eSpark-Backup/yazid-boud-khlouf-oled-keyboard/Deliverables/Renderings/3D_Top_View.PNG

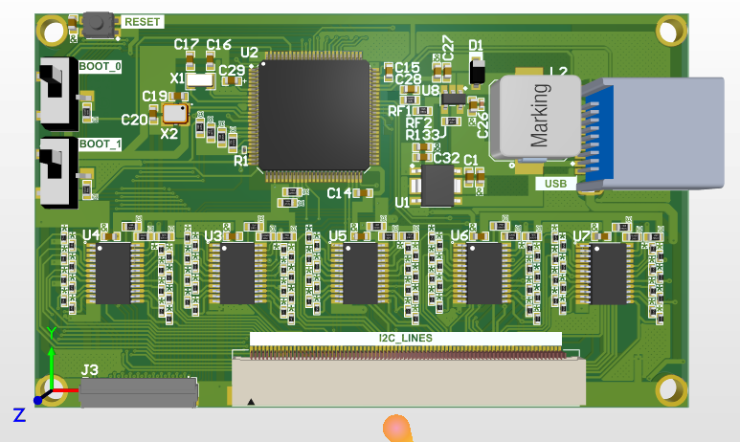
Deliverables/Renderings/3D_Top_View.PNG
