eSpark-Backup/yazid-boud-khlouf-oled-keyboard/Deliverables/Renderings/3D_Bottom_View.PNG

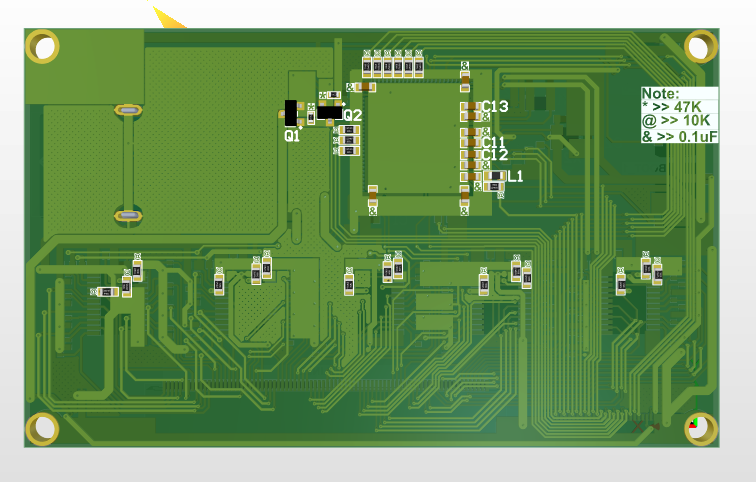
Deliverables/Renderings/3D_Bottom_View.PNG
