eSpark-Backup/yazid-boud-khlouf-oled-keyboard/README.md

# YazidBoukhlouf-OLEDKeyboard
To develop a custom keyboard for client that has OLEDs for Alphanumeric keys and can change characters on runtime. The OLEDs used must be transparent.
