eSpark-Backup/yazid-boud-khlouf-oled-keyboard/Deliverables/Renderings/2D_Bottom_View.PNG

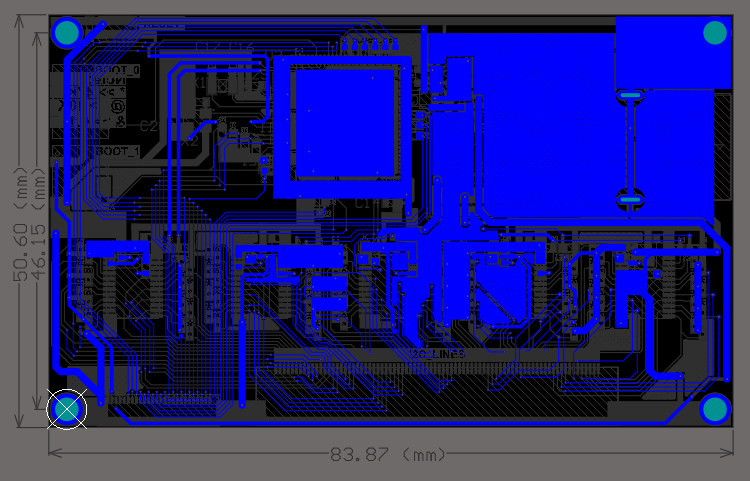
Deliverables/Renderings/2D_Bottom_View.PNG
