eSpark-Backup/yazid-boud-khlouf-oled-keyboard/Deliverables/Renderings/2D_C_View.PNG

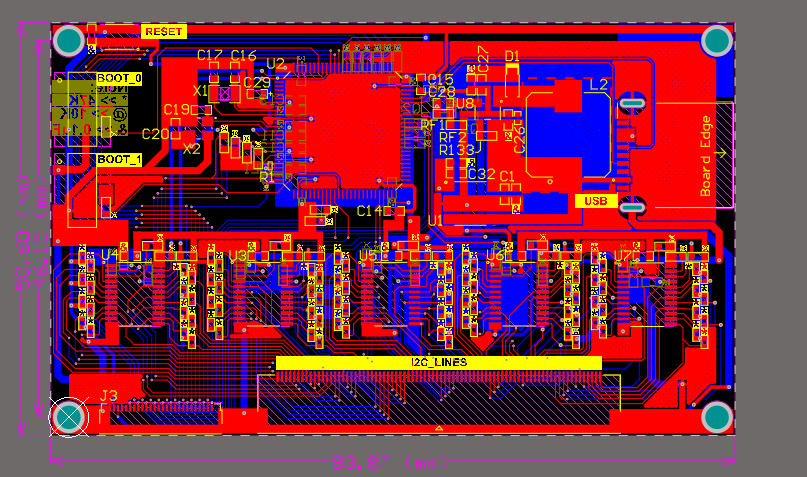
Deliverables/Renderings/2D_C_View.PNG
