eSpark-Backup/yazid-boud-khlouf-oled-keyboard/Deliverables/Renderings/2D_Top_View.PNG

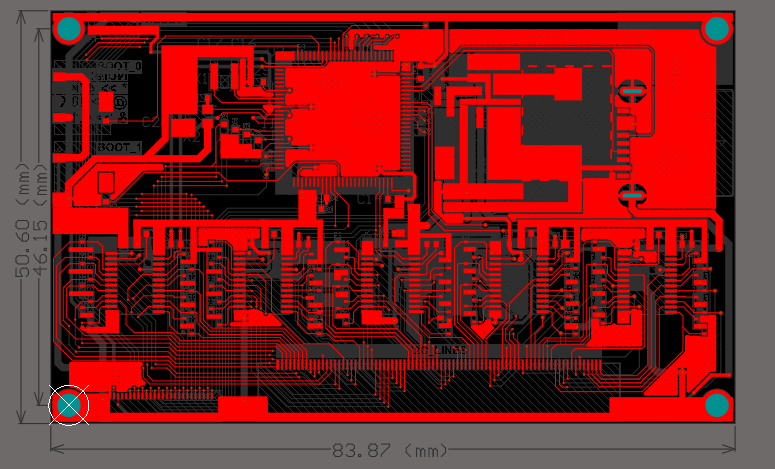
Deliverables/Renderings/2D_Top_View.PNG
