eSpark-Backup/yazid-boud-khlouf-oled-keyboard/Deliverables/Renderings/Isometric_View.PNG

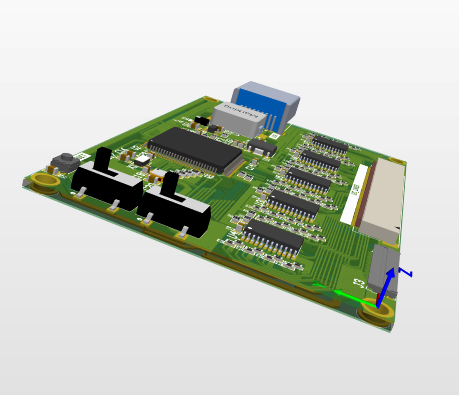
Deliverables/Renderings/Isometric_View.PNG
