eSpark-Backup/yazid-boud-khlouf-oled-keyboard/Design-Files/Control Board/Keyboard layout/layout_rough_sketch.jpg

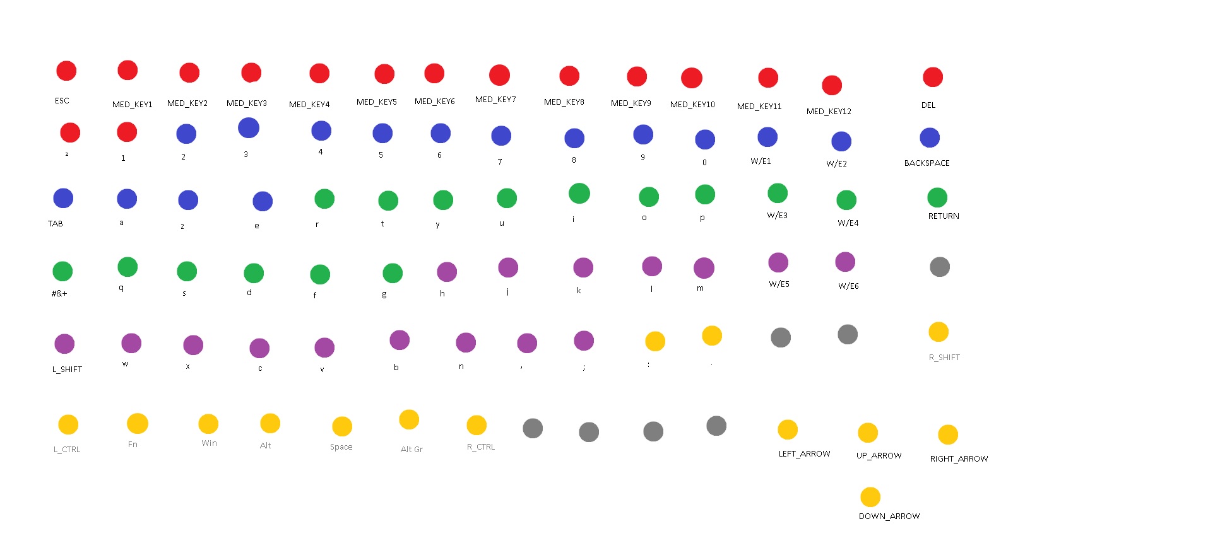
Design-Files/Control Board/Keyboard layout/layout_rough_sketch.jpg
