eSpark-Backup/yazid-boud-khlouf-oled-keyboard/Documents/Dev-Files/IMG_3417.jpg

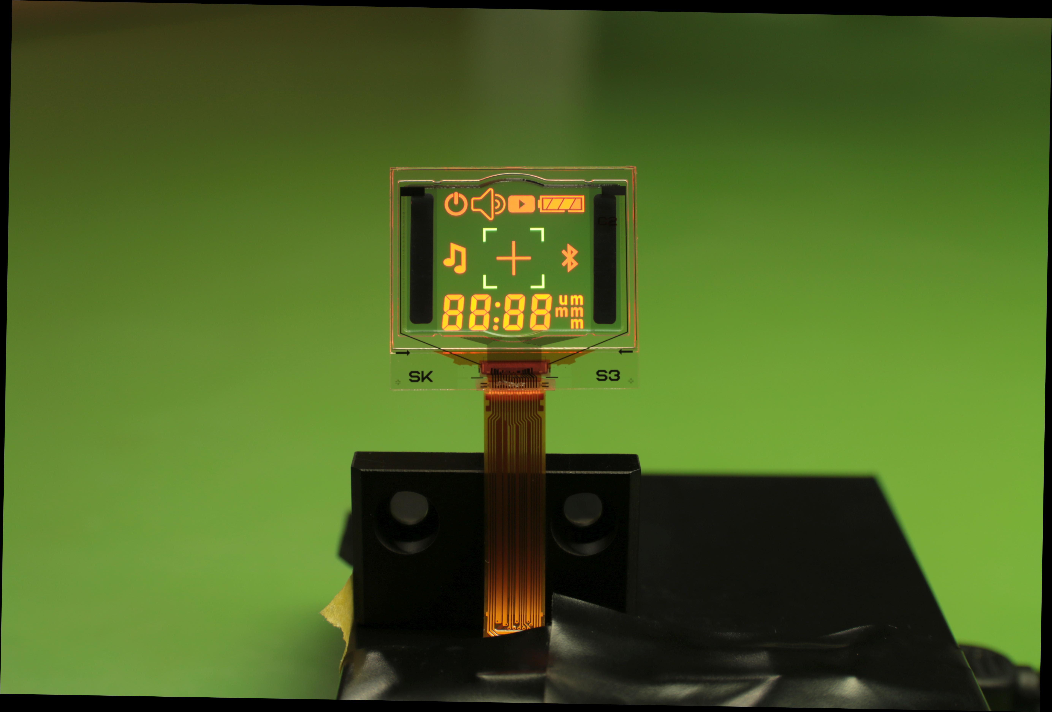
Documents/Dev-Files/IMG_3417.jpg
