eSpark-Backup/yazid-boud-khlouf-oled-keyboard/Documents/Client-Files/Combinaisons de touches.xlsx

Sheet: Short time press
 |  |  | Key is pressed for short time
 |  |  | While key is maintained - but until another key is pressed
 |  |  | While key is maintained
 |  |  | Key is pressed for long time
 |  |  | Key is "activated"
 | By default
 |  |  |  |  |  |  |  |  |  |  |  |  |  |  | Options
 | A | B | C | D | R | F | G | H | I | J | K | L | M | N
1 | Escap |  |  |  |  |  |  |  |  |  |  |  |  | Del | Word |  |  | Excel
2 | ² | 1 | 2 | 3 | 4 | 5 | 6 | 7 | 8 | 9 | 0 |  |  | Back space | Xa | Xa |  | % | =
3 | Tab | a | z | e | r | t | y | u | i | o | p |  |  | Return | B | I |  | + | -
4 | #&+ | q | s | d | f | g | h | j | k | l | m |  |  |  | U | ~~S~~ |  | * | /
5 | Shift |  | w | x | c | v | b | n | , | ; | : | . | Shift
6 | Ctrl | Fn | Win | Alt | Space |  |  |  |  | Alt Gr | Ctrl | ← | ↑ | →
7 |  |  |  |  |  |  |  |  |  |  |  |  | ↓
 | A | B | C | D | R | F | G | H | I | J | K | L | M | N
1 | Escap |  |  |  |  |  |  |  |  |  |  |  |  | Del |  |  |  | Escape
2 | ² | 1 | 2 | 3 | 4 | 5 | 6 | 7 | 8 | 9 | 0 |  |  | Back space
3 | Tab | a | z | e | r | t | y | u | i | o | p |  |  | Return | return
4 | #&+ | q | s | d | f | g | h | j | k | l | m |  |  |  | →
5 | Shift |  | w | x | c | v | b | n | , | ; | : | . | Shift
6 | Ctrl | Fn | Win | Alt | Space |  |  |  |  | Alt Gr | Ctrl | ← | ↑ | →
7 |  |  |  |  |  |  |  |  |  |  |  |  | ↓
 | A | B | C | D | R | F | G | H | I | J | K | L | M | N
1 | Escap |  |  |  |  |  |  |  |  |  |  |  |  | Del |  |  |  | Cancel (Ctrl+z)
2 | ² | 1 | 2 | 3 | 4 | 5 | 6 | 7 | 8 | 9 | 0 |  |  | Back space
3 | Tab | a | z | e | r | t | y | u | i | o | p |  |  | Return | return
4 | #&+ | q | s | d | f | g | h | j | k | l | m |  |  |  | →
5 | Shift |  | w | x | c | v | b | n | , | ; | : | . | Shift
6 | Ctrl | Fn | Win | Alt | Space |  |  |  |  | Alt Gr | Ctrl | ← | ↑ | →
7 |  |  |  |  |  |  |  |  |  |  |  |  | ↓
 | A | B | C | D | R | F | G | H | I | J | K | L | M | N
1 | Escap |  |  |  |  |  |  |  |  |  |  |  |  | Del |  |  |  | decrease screen brightness
2 | ² | 1 | 2 | 3 | 4 | 5 | 6 | 7 | 8 | 9 | 0 |  |  | Back space
3 | Tab | a | z | e | r | t | y | u | i | o | p |  |  | Return | return
4 | #&+ | q | s | d | f | g | h | j | k | l | m |  |  |  | →
5 | Shift |  | w | x | c | v | b | n | , | ; | : | . | Shift
6 | Ctrl | Fn | Win | Alt | Space |  |  |  |  | Alt Gr | Ctrl | ← | ↑ | →
7 |  |  |  |  |  |  |  |  |  |  |  |  | ↓
 | A | B | C | D | R | F | G | H | I | J | K | L | M | N
1 | Escap |  |  |  |  |  |  |  |  |  |  |  |  | Del |  |  |  | increase screen brightness
2 | ² | 1 | 2 | 3 | 4 | 5 | 6 | 7 | 8 | 9 | 0 |  |  | Back space
3 | Tab | a | z | e | r | t | y | u | i | o | p |  |  | Return | return
4 | #&+ | q | s | d | f | g | h | j | k | l | m |  |  |  | →
5 | Shift |  | w | x | c | v | b | n | , | ; | : | . | Shift
6 | Ctrl | Fn | Win | Alt | Space |  |  |  |  | Alt Gr | Ctrl | ← | ↑ | →
7 |  |  |  |  |  |  |  |  |  |  |  |  | ↓
 | A | B | C | D | R | F | G | H | I | J | K | L | M | N
1 | Escap |  |  |  |  |  |  |  |  |  |  |  |  | Del |  |  |  | decrease volume
2 | ² | 1 | 2 | 3 | 4 | 5 | 6 | 7 | 8 | 9 | 0 |  |  | Back space
3 | Tab | a | z | e | r | t | y | u | i | o | p |  |  | Return | return
4 | #&+ | q | s | d | f | g | h | j | k | l | m |  |  |  | →
5 | Shift |  | w | x | c | v | b | n | , | ; | : | . | Shift
6 | Ctrl | Fn | Win | Alt | Space |  |  |  |  | Alt Gr | Ctrl | ← | ↑ | →
7 |  |  |  |  |  |  |  |  |  |  |  |  | ↓
 | A | B | C | D | R | F | G | H | I | J | K | L | M | N
1 | Escap |  |  |  |  |  |  |  |  |  |  |  |  | Del |  |  |  | increase volume
2 | ² | 1 | 2 | 3 | 4 | 5 | 6 | 7 | 8 | 9 | 0 |  |  | Back space
3 | Tab | a | z | e | r | t | y | u | i | o | p |  |  | Return | return
4 | #&+ | q | s | d | f | g | h | j | k | l | m |  |  |  | →
5 | Shift |  | w | x | c | v | b | n | , | ; | : | . | Shift
6 | Ctrl | Fn | Win | Alt | Space |  |  |  |  | Alt Gr | Ctrl | ← | ↑ | →
7 |  |  |  |  |  |  |  |  |  |  |  |  | ↓
 | A | B | C | D | R | F | G | H | I | J | K | L | M | N |  |  |  | A | B | C | D | R | F | G | H | I | J | K | L | M | N
1 | Escap |  |  |  |  |  |  |  |  |  |  |  |  | Del |  |  | 1 | Escap |  |  |  |  |  |  |  |  |  |  |  |  | Del |  | Microphone on/off
2 | ² | 1 | 2 | 3 | 4 | 5 | 6 | 7 | 8 | 9 | 0 |  |  | Back space |  |  | 2 | ² | 1 | 2 | 3 | 4 | 5 | 6 | 7 | 8 | 9 | 0 |  |  | Back space
3 | Tab | a | z | e | r | t | y | u | i | o | p |  |  | Return | return |  | 3 | Tab | a | z | e | r | t | y | u | i | o | p |  |  | Return
4 | #&+ | q | s | d | f | g | h | j | k | l | m |  |  |  | → |  | 4 | #&+ | q | s | d | f | g | h | j | k | l | m
5 | Shift |  | w | x | c | v | b | n | , | ; | : | . | Shift |  |  |  | 5 | Shift |  | w | x | c | v | b | n | , | ; | : | . | Shift
6 | Ctrl | Fn | Win | Alt | Space |  |  |  |  | Alt Gr | Ctrl | ← | ↑ | → |  |  | 6 | Ctrl | Fn | Win | Alt | Space |  |  |  |  | Alt Gr | Ctrl | ← | ↑ | →
7 |  |  |  |  |  |  |  |  |  |  |  |  | ↓ |  |  |  | 7 |  |  |  |  |  |  |  |  |  |  |  |  | ↓
 | A | B | C | D | R | F | G | H | I | J | K | L | M | N |  |  |  | A | B | C | D | R | F | G | H | I | J | K | L | M | N
1 | Escap |  |  |  |  |  |  |  |  |  |  |  |  | Del |  |  | 1 | Escap |  |  |  |  |  |  |  |  |  |  |  |  | Del |  | Camera on/off
2 | ² | 1 | 2 | 3 | 4 | 5 | 6 | 7 | 8 | 9 | 0 |  |  | Back space |  |  | 2 | ² | 1 | 2 | 3 | 4 | 5 | 6 | 7 | 8 | 9 | 0 |  |  | Back space
3 | Tab | a | z | e | r | t | y | u | i | o | p |  |  | Return | return |  | 3 | Tab | a | z | e | r | t | y | u | i | o | p |  |  | Return
4 | #&+ | q | s | d | f | g | h | j | k | l | m |  |  |  | → |  | 4 | #&+ | q | s | d | f | g | h | j | k | l | m
5 | Shift |  | w | x | c | v | b | n | , | ; | : | . | Shift |  | ← |  | 5 | Shift |  | w | x | c | v | b | n | , | ; | : | . | Shift
6 | Ctrl | Fn | Win | Alt | Space |  |  |  |  | Alt Gr | Ctrl | ← | ↑ | → |  |  | 6 | Ctrl | Fn | Win | Alt | Space |  |  |  |  | Alt Gr | Ctrl | ← | ↑ | →
7 |  |  |  |  |  |  |  |  |  |  |  |  | ↓ |  |  |  | 7 |  |  |  |  |  |  |  |  |  |  |  |  | ↓
 | A | B | C | D | R | F | G | H | I | J | K | L | M | N |  |  |  | A | B | C | D | R | F | G | H | I | J | K | L | M | N
1 | Escap |  |  |  |  |  |  |  |  |  |  |  |  | Del |  |  | 1 | Escap |  |  |  |  |  |  |  |  |  |  |  |  | Del |  | Screen record
2 | ² | 1 | 2 | 3 | 4 | 5 | 6 | 7 | 8 | 9 | 0 |  |  | Back space |  |  | 2 | ² | 1 | 2 | 3 | 4 | 5 | 6 | 7 | 8 | 9 | 0 |  |  | Back space
3 | Tab | a | z | e | r | t | y | u | i | o | p |  |  | Return | return |  | 3 | Tab | a | z | e | r | t | y | u | i | o | p |  |  | Return
4 | #&+ | q | s | d | f | g | h | j | k | l | m |  |  |  | → |  | 4 | #&+ | q | s | d | f | g | h | j | k | l | m
5 | Shift |  | w | x | c | v | b | n | , | ; | : | . | Shift |  | ← |  | 5 | Shift |  | w | x | c | v | b | n | , | ; | : | . | Shift
6 | Ctrl | Fn | Win | Alt | Space |  |  |  |  | Alt Gr | Ctrl | ← | ↑ | → |  |  | 6 | Ctrl | Fn | Win | Alt | Space |  |  |  |  | Alt Gr | Ctrl | ← | ↑ | →
7 |  |  |  |  |  |  |  |  |  |  |  |  | ↓ |  |  |  | 7 |  |  |  |  |  |  |  |  |  |  |  |  | ↓
 | A | B | C | D | R | F | G | H | I | J | K | L | M | N
1 | Escap |  |  |  |  |  |  |  |  |  |  |  |  | Del |  |  |  | Screenshot
2 | ² | 1 | 2 | 3 | 4 | 5 | 6 | 7 | 8 | 9 | 0 |  |  | Back space
3 | Tab | a | z | e | r | t | y | u | i | o | p |  |  | Return | return
4 | #&+ | q | s | d | f | g | h | j | k | l | m |  |  |  | →
5 | Shift |  | w | x | c | v | b | n | , | ; | : | . | Shift |  | ←
6 | Ctrl | Fn | Win | Alt | Space |  |  |  |  | Alt Gr | Ctrl | ← | ↑ | →
7 |  |  |  |  |  |  |  |  |  |  |  |  | ↓
 | A | B | C | D | R | F | G | H | I | J | K | L | M | N
1 | Escap |  |  |  |  |  |  |  |  |  |  |  |  | Del |  |  |  | Print
2 | ² | 1 | 2 | 3 | 4 | 5 | 6 | 7 | 8 | 9 | 0 |  |  | Back space
3 | Tab | a | z | e | r | t | y | u | i | o | p |  |  | Return | return
4 | #&+ | q | s | d | f | g | h | j | k | l | m |  |  |  | →
5 | Shift |  | w | x | c | v | b | n | , | ; | : | . | Shift
6 | Ctrl | Fn | Win | Alt | Space |  |  |  |  | Alt Gr | Ctrl | ← | ↑ | →
7 |  |  |  |  |  |  |  |  |  |  |  |  | ↓
 | A | B | C | D | R | F | G | H | I | J | K | L | M | N
1 | Escap |  |  |  |  |  |  |  |  |  |  |  |  | Del |  |  |  | Share
2 | ² | 1 | 2 | 3 | 4 | 5 | 6 | 7 | 8 | 9 | 0 |  |  | Back space
3 | Tab | a | z | e | r | t | y | u | i | o | p |  |  | Return | return
4 | #&+ | q | s | d | f | g | h | j | k | l | m |  |  |  | →
5 | Shift |  | w | x | c | v | b | n | , | ; | : | . | Shift
6 | Ctrl | Fn | Win | Alt | Space |  |  |  |  | Alt Gr | Ctrl | ← | ↑ | →
7 |  |  |  |  |  |  |  |  |  |  |  |  | ↓
 | A | B | C | D | R | F | G | H | I | J | K | L | M | N |  |  |  | A | B | C | D | R | F | G | H | I | J | K | L | M | N
1 | Escap |  |  |  |  |  |  |  |  |  |  |  |  | Del |  |  | 1 | Escap |  |  |  |  |  |  |  |  |  |  |  |  | Del |  | Activate / Disable WiFi
2 | ² | 1 | 2 | 3 | 4 | 5 | 6 | 7 | 8 | 9 | 0 |  |  | Back space |  |  | 2 | ² | 1 | 2 | 3 | 4 | 5 | 6 | 7 | 8 | 9 | 0 |  |  | Back space
3 | Tab | a | z | e | r | t | y | u | i | o | p |  |  | Return | return |  | 3 | Tab | a | z | e | r | t | y | u | i | o | p |  |  | Return | return
4 | #&+ | q | s | d | f | g | h | j | k | l | m |  |  |  | → |  | 4 | #&+ | q | s | d | f | g | h | j | k | l | m |  |  |  | →
5 | Shift |  | w | x | c | v | b | n | , | ; | : | . | Shift |  | ← |  | 5 | Shift |  | w | x | c | v | b | n | , | ; | : | . | Shift
6 | Ctrl | Fn | Win | Alt | Space |  |  |  |  | Alt Gr | Ctrl | ← | ↑ | → |  |  | 6 | Ctrl | Fn | Win | Alt | Space |  |  |  |  | Alt Gr | Ctrl | ← | ↑ | →
7 |  |  |  |  |  |  |  |  |  |  |  |  | ↓ |  |  |  | 7 |  |  |  |  |  |  |  |  |  |  |  |  | ↓
 | A | B | C | D | R | F | G | H | I | J | K | L | M | N
1 | Escap |  |  |  |  |  |  |  |  |  |  |  |  | Del |  |  |  | Delete
2 | ² | 1 | 2 | 3 | 4 | 5 | 6 | 7 | 8 | 9 | 0 |  |  | Back space
3 | Tab | a | z | e | r | t | y | u | i | o | p |  |  | Return | return
4 | #&+ | q | s | d | f | g | h | j | k | l | m |  |  |  | →
5 | Shift |  | w | x | c | v | b | n | , | ; | : | . | Shift
6 | Ctrl | Fn | Win | Alt | Space |  |  |  |  | Alt Gr | Ctrl | ← | ↑ | →
7 |  |  |  |  |  |  |  |  |  |  |  |  | ↓
 | A | B | C | D | R | F | G | H | I | J | K | L | M | N
1 | Escap |  |  |  |  |  |  |  |  |  |  |  |  | Del |  |  |  | ²
2 | ² | 1 | 2 | 3 | 4 | 5 | 6 | 7 | 8 | 9 | 0 |  |  | Back space
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
7 |  |  |  |  |  |  |  |  |  |  |  |  | ↓
 | A | B | C | D | R | F | G | H | I | J | K | L | M | N
1 | Escap |  |  |  |  |  |  |  |  |  |  |  |  | Del |  |  |  | Return
2 | ² | 1 | 2 | 3 | 4 | 5 | 6 | 7 | 8 | 9 | 0 |  |  | Back space
3 | Tab | a | z | e | r | t | y | u | i | o | p |  |  | Return | return
4 | #&+ | q | s | d | f | g | h | j | k | l | m |  |  |  | →
5 | Shift |  | w | x | c | v | b | n | , | ; | : | . | Shift
6 | Ctrl | Fn | Win | Alt | Space |  |  |  |  | Alt Gr | Ctrl | ← | ↑ | →
7 |  |  |  |  |  |  |  |  |  |  |  |  | ↓
 | A | B | C | D | R | F | G | H | I | J | K | L | M | N |  |  |  | A | B | C | D | R | F | G | H | I | J | K | L | M | N
1 | Escap |  |  |  |  |  |  |  |  |  |  |  |  | Del |  |  | 1 | Escap |  |  |  |  |  |  |  |  |  |  |  |  | Del
2 | ² | 1 | 2 | 3 | 4 | 5 | 6 | 7 | 8 | 9 | 0 |  |  | Back space |  |  | 2 | ° | 1 | 2 | 3 | 4 | 5 | 6 | 7 | 8 | 9 | 0 | % | = | Back space
3 | Tab | a | z | e | r | t | y | u | i | o | p |  |  | Return | return |  | 3 | Tab | ' | " | ( | ) | { | } | [ | ] | < | > | + | - | Return
4 | #&+ | q | s | d | f | g | h | j | k | l | m |  |  |  | → |  | 4 | abc | & | # | @ | € | $ | £ | ¥ | ~ | ¨ | ^ | * | /
5 | Shift |  | w | x | c | v | b | n | , | ; | : | . | Shift |  | ← |  | 5 | Shift |  | \ | | | - | _ | ; | : | , | . | ? | ! | Shift
6 | Ctrl | Fn | Win | Alt | Space |  |  |  |  | Alt Gr | Ctrl | ← | ↑ | → |  |  | 6 | Ctrl | Fn | Win | Alt | Space |  |  |  |  | Alt Gr | Ctrl | ← | ↑ | →
7 |  |  |  |  |  |  |  |  |  |  |  |  | ↓ |  |  |  | 7 |  |  |  |  |  |  |  |  |  |  |  |  | ↓
 |  |  |  |  |  |  |  |  |  |  |  |  |  |  |  |  |  | A | B | C | D | R | F | G | H | I | J | K | L | M | N
 |  |  |  |  |  |  |  |  |  |  |  |  |  |  |  |  | 1 | Escap |  |  |  |  |  |  |  |  |  |  |  |  | Del |  | °
 |  |  |  |  |  |  |  |  |  |  |  |  |  |  |  |  | 2 | ° | 1 | 2 | 3 | 4 | 5 | 6 | 7 | 8 | 9 | 0 | % | = | Back space
 |  |  |  |  |  |  |  |  |  |  |  |  |  |  |  |  | 3 | Tab | ' | " | ( | ) | { | } | [ | ] | < | > | + | - | Return | return
 |  |  |  |  |  |  |  |  |  |  |  |  |  |  |  |  | 4 | abc | & | # | @ | € | $ | £ | ¥ | ~ | ¨ | ^ | * | / |  | →
 |  |  |  |  |  |  |  |  |  |  |  |  |  |  |  |  | 5 | Shift |  | \ | | | - | _ | ; | : | , | . | ? | ! | Shift
 |  |  |  |  |  |  |  |  |  |  |  |  |  |  |  |  | 6 | Ctrl | Fn | Win | Alt | Space |  |  |  |  | Alt Gr | Ctrl | ← | ↑ | →
 |  |  |  |  |  |  |  |  |  |  |  |  |  |  |  |  | 7 |  |  |  |  |  |  |  |  |  |  |  |  | ↓
 |  |  |  |  |  |  |  |  |  |  |  |  |  |  |  |  |  | A | B | C | D | R | F | G | H | I | J | K | L | M | N
 |  |  |  |  |  |  |  |  |  |  |  |  |  |  |  |  | 1 | Escap |  |  |  |  |  |  |  |  |  |  |  |  | Del |  | %
 |  |  |  |  |  |  |  |  |  |  |  |  |  |  |  |  | 2 | ° | 1 | 2 | 3 | 4 | 5 | 6 | 7 | 8 | 9 | 0 | % | = | Back space
 |  |  |  |  |  |  |  |  |  |  |  |  |  |  |  |  | 3 | Tab | ' | " | ( | ) | { | } | [ | ] | < | > | + | - | Return | return
 |  |  |  |  |  |  |  |  |  |  |  |  |  |  |  |  | 4 | abc | & | # | @ | € | $ | £ | ¥ | ~ | ¨ | ^ | * | / |  | →
 |  |  |  |  |  |  |  |  |  |  |  |  |  |  |  |  | 5 | Shift |  | \ | | | - | _ | ; | : | , | . | ? | ! | Shift
 |  |  |  |  |  |  |  |  |  |  |  |  |  |  |  |  | 6 | Ctrl | Fn | Win | Alt | Space |  |  |  |  | Alt Gr | Ctrl | ← | ↑ | →
 |  |  |  |  |  |  |  |  |  |  |  |  |  |  |  |  | 7 |  |  |  |  |  |  |  |  |  |  |  |  | ↓
 |  |  |  |  |  |  |  |  |  |  |  |  |  |  |  |  |  | A | B | C | D | R | F | G | H | I | J | K | L | M | N
 |  |  |  |  |  |  |  |  |  |  |  |  |  |  |  |  | 1 | Escap |  |  |  |  |  |  |  |  |  |  |  |  | Del |  | =
 |  |  |  |  |  |  |  |  |  |  |  |  |  |  |  |  | 2 | ° | 1 | 2 | 3 | 4 | 5 | 6 | 7 | 8 | 9 | 0 | % | = | Back space
 |  |  |  |  |  |  |  |  |  |  |  |  |  |  |  |  | 3 | Tab | ' | " | ( | ) | { | } | [ | ] | < | > | + | - | Return | return
 |  |  |  |  |  |  |  |  |  |  |  |  |  |  |  |  | 4 | abc | & | # | @ | € | $ | £ | ¥ | ~ | ¨ | ^ | * | / |  | →
 |  |  |  |  |  |  |  |  |  |  |  |  |  |  |  |  | 5 | Shift |  | \ | | | - | _ | ; | : | , | . | ? | ! | Shift
 |  |  |  |  |  |  |  |  |  |  |  |  |  |  |  |  | 6 | Ctrl | Fn | Win | Alt | Space |  |  |  |  | Alt Gr | Ctrl | ← | ↑ | →
 |  |  |  |  |  |  |  |  |  |  |  |  |  |  |  |  | 7 |  |  |  |  |  |  |  |  |  |  |  |  | ↓
 |  |  |  |  |  |  |  |  |  |  |  |  |  |  |  |  |  | A | B | C | D | R | F | G | H | I | J | K | L | M | N
 |  |  |  |  |  |  |  |  |  |  |  |  |  |  |  |  | 1 | Escap |  |  |  |  |  |  |  |  |  |  |  |  | Del
 |  |  |  |  |  |  |  |  |  |  |  |  |  |  |  |  | 2 | ° | 1 | 2 | 3 | 4 | 5 | 6 | 7 | 8 | 9 | 0 | % | = | Back space
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
 |  |  |  |  |  |  |  |  |  |  |  |  |  |  |  |  | 2 | ° | 1 | 2 | 3 | 4 | 5 | 6 | 7 | 8 | 9 | 0 | % | = | Back space
 |  |  |  |  |  |  |  |  |  |  |  |  |  |  |  |  | 3 | Tab | ' | " | ( | ) | { | } | [ | ] | < | > | + | - | Return | return
 |  |  |  |  |  |  |  |  |  |  |  |  |  |  |  |  | 4 | abc | & | # | @ | € | $ | £ | ¥ | ~ | ¨ | ^ | * | / |  | →
 |  |  |  |  |  |  |  |  |  |  |  |  |  |  |  |  | 5 | Shift |  | \ | | | - | _ | ; | : | , | ; | ? | ! | Shift
 |  |  |  |  |  |  |  |  |  |  |  |  |  |  |  |  | 6 | Ctrl | Fn | Win | Alt | Space |  |  |  |  | Alt Gr | Ctrl | ← | ↑ | →
 |  |  |  |  |  |  |  |  |  |  |  |  |  |  |  |  | 7 |  |  |  |  |  |  |  |  |  |  |  |  | ↓
 | A | B | C | D | R | F | G | H | I | J | K | L | M | N
1 | Escap |  |  |  |  |  |  |  |  |  |  |  |  | Del |  |  |  | q
2 | ² | 1 | 2 | 3 | 4 | 5 | 6 | 7 | 8 | 9 | 0 |  |  | Back space
3 | Tab | a | z | e | r | t | y | u | i | o | p |  |  | Return | return
4 | #&+ | q | s | d | f | g | h | j | k | l | m |  |  |  | →
5 | Shift |  | w | x | c | v | b | n | , | ; | : | . | Shift
6 | Ctrl | Fn | Win | Alt | Space |  |  |  |  | Alt Gr | Ctrl | ← | ↑ | →
7 |  |  |  |  |  |  |  |  |  |  |  |  | ↓
 | A | B | C | D | R | F | G | H | I | J | K | L | M | N
1 | Escap |  |  |  |  |  |  |  |  |  |  |  |  | Del |  |  |  | s
2 | ² | 1 | 2 | 3 | 4 | 5 | 6 | 7 | 8 | 9 | 0 |  |  | Back space
3 | Tab | a | z | e | r | t | y | u | i | o | p |  |  | Return | return
4 | #&+ | q | s | d | f | g | h | j | k | l | m |  |  |  | →
5 | Shift |  | w | x | c | v | b | n | , | ; | : | . | Shift
6 | Ctrl | Fn | Win | Alt | Space |  |  |  |  | Alt Gr | Ctrl | ← | ↑ | →
7 |  |  |  |  |  |  |  |  |  |  |  |  | ↓
 | A | B | C | D | R | F | G | H | I | J | K | L | M | N
1 | Escap |  |  |  |  |  |  |  |  |  |  |  |  | Del |  |  |  | d
2 | ² | 1 | 2 | 3 | 4 | 5 | 6 | 7 | 8 | 9 | 0 |  |  | Back space
3 | Tab | a | z | e | r | t | y | u | i | o | p |  |  | Return | return
4 | #&+ | q | s | d | f | g | h | j | k | l | m |  |  |  | →
5 | Shift |  | w | x | c | v | b | n | , | ; | : | . | Shift
6 | Ctrl | Fn | Win | Alt | Space |  |  |  |  | Alt Gr | Ctrl | ← | ↑ | →
7 |  |  |  |  |  |  |  |  |  |  |  |  | ↓
 | A | B | C | D | R | F | G | H | I | J | K | L | M | N
1 | Escap |  |  |  |  |  |  |  |  |  |  |  |  | Del |  |  |  | f
2 | ² | 1 | 2 | 3 | 4 | 5 | 6 | 7 | 8 | 9 | 0 |  |  | Back space
3 | Tab | a | z | e | r | t | y | u | i | o | p |  |  | Return | return
4 | #&+ | q | s | d | f | g | h | j | k | l | m |  |  |  | →
5 | Shift |  | w | x | c | v | b | n | , | ; | : | . | Shift
6 | Ctrl | Fn | Win | Alt | Space |  |  |  |  | Alt Gr | Ctrl | ← | ↑ | →
7 |  |  |  |  |  |  |  |  |  |  |  |  | ↓
 | A | B | C | D | R | F | G | H | I | J | K | L | M | N
1 | Escap |  |  |  |  |  |  |  |  |  |  |  |  | Del |  |  |  | g
2 | ² | 1 | 2 | 3 | 4 | 5 | 6 | 7 | 8 | 9 | 0 |  |  | Back space
3 | Tab | a | z | e | r | t | y | u | i | o | p |  |  | Return | return
4 | #&+ | q | s | d | f | g | h | j | k | l | m |  |  |  | →
5 | Shift |  | w | x | c | v | b | n | , | ; | : | . | Shift
6 | Ctrl | Fn | Win | Alt | Space |  |  |  |  | Alt Gr | Ctrl | ← | ↑ | →
7 |  |  |  |  |  |  |  |  |  |  |  |  | ↓
 | A | B | C | D | R | F | G | H | I | J | K | L | M | N
1 | Escap |  |  |  |  |  |  |  |  |  |  |  |  | Del |  |  |  | h
2 | ² | 1 | 2 | 3 | 4 | 5 | 6 | 7 | 8 | 9 | 0 |  |  | Back space
3 | Tab | a | z | e | r | t | y | u | i | o | p |  |  | Return | return
4 | #&+ | q | s | d | f | g | h | j | k | l | m |  |  |  | →
5 | Shift |  | w | x | c | v | b | n | , | ; | : | . | Shift
6 | Ctrl | Fn | Win | Alt | Space |  |  |  |  | Alt Gr | Ctrl | ← | ↑ | →
7 |  |  |  |  |  |  |  |  |  |  |  |  | ↓
 | A | B | C | D | R | F | G | H | I | J | K | L | M | N
1 | Escap |  |  |  |  |  |  |  |  |  |  |  |  | Del |  |  |  | i
2 | ² | 1 | 2 | 3 | 4 | 5 | 6 | 7 | 8 | 9 | 0 |  |  | Back space
3 | Tab | a | z | e | r | t | y | u | i | o | p |  |  | Return | return
4 | #&+ | q | s | d | f | g | h | j | k | l | m |  |  |  | →
5 | Shift |  | w | x | c | v | b | n | , | ; | : | . | Shift
6 | Ctrl | Fn | Win | Alt | Space |  |  |  |  | Alt Gr | Ctrl | ← | ↑ | →
7 |  |  |  |  |  |  |  |  |  |  |  |  | ↓
 | A | B | C | D | R | F | G | H | I | J | K | L | M | N
1 | Escap |  |  |  |  |  |  |  |  |  |  |  |  | Del |  |  |  | k
2 | ² | 1 | 2 | 3 | 4 | 5 | 6 | 7 | 8 | 9 | 0 |  |  | Back space
3 | Tab | a | z | e | r | t | y | u | i | o | p |  |  | Return | return
4 | #&+ | q | s | d | f | g | h | j | k | l | m |  |  |  | →
5 | Shift |  | w | x | c | v | b | n | , | ; | : | . | Shift
6 | Ctrl | Fn | Win | Alt | Space |  |  |  |  | Alt Gr | Ctrl | ← | ↑ | →
7 |  |  |  |  |  |  |  |  |  |  |  |  | ↓
 | A | B | C | D | R | F | G | H | I | J | K | L | M | N
1 | Escap |  |  |  |  |  |  |  |  |  |  |  |  | Del |  |  |  | l
2 | ² | 1 | 2 | 3 | 4 | 5 | 6 | 7 | 8 | 9 | 0 |  |  | Back space
3 | Tab | a | z | e | r | t | y | u | i | o | p |  |  | Return | return
4 | #&+ | q | s | d | f | g | h | j | k | l | m |  |  |  | →
5 | Shift |  | w | x | c | v | b | n | , | ; | : | . | Shift
6 | Ctrl | Fn | Win | Alt | Space |  |  |  |  | Alt Gr | Ctrl | ← | ↑ | →
7 |  |  |  |  |  |  |  |  |  |  |  |  | ↓
 | A | B | C | D | R | F | G | H | I | J | K | L | M | N
1 | Escap |  |  |  |  |  |  |  |  |  |  |  |  | Del |  |  |  | m
2 | ² | 1 | 2 | 3 | 4 | 5 | 6 | 7 | 8 | 9 | 0 |  |  | Back space
3 | Tab | a | z | e | r | t | y | u | i | o | p |  |  | Return | return
4 | #&+ | q | s | d | f | g | h | j | k | l | m |  |  |  | →
5 | Shift |  | w | x | c | v | b | n | , | ; | : | . | Shift
6 | Ctrl | Fn | Win | Alt | Space |  |  |  |  | Alt Gr | Ctrl | ← | ↑ | →
7 |  |  |  |  |  |  |  |  |  |  |  |  | ↓
 | A | B | C | D | R | F | G | H | I | J | K | L | M | N
1 | Escap |  |  |  |  |  |  |  |  |  |  |  |  | Del |  |  |  | None
2 | ² | 1 | 2 | 3 | 4 | 5 | 6 | 7 | 8 | 9 | 0 |  |  | Back space
3 | Tab | a | z | e | r | t | y | u | i | o | p |  |  | Return | return
4 | #&+ | q | s | d | f | g | h | j | k | l | m |  |  |  | →
5 | Shift |  | w | x | c | v | b | n | , | ; | : | . | Shift
6 | Ctrl | Fn | Win | Alt | Space |  |  |  |  | Alt Gr | Ctrl | ← | ↑ | →
7 |  |  |  |  |  |  |  |  |  |  |  |  | ↓
 | A | B | C | D | R | F | G | H | I | J | K | L | M | N
1 | Escap |  |  |  |  |  |  |  |  |  |  |  |  | Del |  |  |  | None
2 | ² | 1 | 2 | 3 | 4 | 5 | 6 | 7 | 8 | 9 | 0 |  |  | Back space
3 | Tab | a | z | e | r | t | y | u | i | o | p |  |  | Return | return
4 | #&+ | q | s | d | f | g | h | j | k | l | m |  |  |  | →
5 | Shift |  | w | x | c | v | b | n | , | ; | : | . | Shift
6 | Ctrl | Fn | Win | Alt | Space |  |  |  |  | Alt Gr | Ctrl | ← | ↑ | →
7 |  |  |  |  |  |  |  |  |  |  |  |  | ↓
 | A | B | C | D | R | F | G | H | I | J | K | L | M | N |  |  |  | A | B | C | D | R | F | G | H | I | J | K | L | M | N
1 | Escap |  |  |  |  |  |  |  |  |  |  |  |  | Del |  |  | 1 | Escap |  |  |  |  |  |  |  |  |  |  |  |  | Del
2 | ² | 1 | 2 | 3 | 4 | 5 | 6 | 7 | 8 | 9 | 0 |  |  | Back space |  |  | 2 | 3 | 1 | 2 | 3 | 4 | 5 | 6 | 7 | 8 | 9 | 0 |  |  | Back space
3 | Tab | a | z | e | r | t | y | u | i | o | p |  |  | Return | return |  | 3 | Tab | A | Z | E | R | T | Y | U | I | O | P |  |  | Return
4 | #&+ | q | s | d | f | g | h | j | k | l | m |  |  |  | → |  | 4 | #&+ | Q | S | D | F | G | H | J | K | L | M
5 | Shift |  | w | x | c | v | b | n | , | ; | : | . | Shift |  |  |  | 5 | Shift |  | W | X | C | V | B | N | , | ; | : | . | Shift
6 | Ctrl | Fn | Win | Alt | Space |  |  |  |  | Alt Gr | Ctrl | ← | ↑ | → |  |  | 6 | Ctrl | Fn | Win | Alt | Space |  |  |  |  | Alt Gr | Ctrl | ← | ↑ | →
7 |  |  |  |  |  |  |  |  |  |  |  |  | ↓ |  |  |  | 7 |  |  |  |  |  |  |  |  |  |  |  |  | ↓
 |  |  |  |  |  |  |  |  |  |  |  |  |  |  |  |  |  | A | B | C | D | R | F | G | H | I | J | K | L | M | N
 |  |  |  |  |  |  |  |  |  |  |  |  |  |  |  |  | 1 | Escap |  |  |  |  |  |  |  |  |  |  |  |  | Del |  | A
 |  |  |  |  |  |  |  |  |  |  |  |  |  |  |  |  | 2 | 3 | 1 | 2 | 3 | 4 | 5 | 6 | 7 | 8 | 9 | 0 |  |  | Back space
 |  |  |  |  |  |  |  |  |  |  |  |  |  |  |  |  | 3 | Tab | A | Z | E | R | T | Y | U | I | O | P |  |  | Return | return
 |  |  |  |  |  |  |  |  |  |  |  |  |  |  |  |  | 4 | #&+ | Q | S | D | F | G | H | J | K | L | M |  |  |  | →
 |  |  |  |  |  |  |  |  |  |  |  |  |  |  |  |  | 5 | Shift |  | W | X | C | V | B | N | , | ; | : | . | Shift
 |  |  |  |  |  |  |  |  |  |  |  |  |  |  |  |  | 6 | Ctrl | Fn | Win | Alt | Space |  |  |  |  | Alt Gr | Ctrl | ← | ↑ | →
 |  |  |  |  |  |  |  |  |  |  |  |  |  |  |  |  | 7 |  |  |  |  |  |  |  |  |  |  |  |  | ↓
 |  |  |  |  |  |  |  |  |  |  |  |  |  |  |  |  |  | A | B | C | D | R | F | G | H | I | J | K | L | M | N
 |  |  |  |  |  |  |  |  |  |  |  |  |  |  |  |  | 1 | Escap |  |  |  |  |  |  |  |  |  |  |  |  | Del |  | Z
 |  |  |  |  |  |  |  |  |  |  |  |  |  |  |  |  | 2 | 3 | 1 | 2 | 3 | 4 | 5 | 6 | 7 | 8 | 9 | 0 |  |  | Back space
 |  |  |  |  |  |  |  |  |  |  |  |  |  |  |  |  | 3 | Tab | A | Z | E | R | T | Y | U | I | O | P |  |  | Return | return
 |  |  |  |  |  |  |  |  |  |  |  |  |  |  |  |  | 4 | #&+ | Q | S | D | F | G | H | J | K | L | M |  |  |  | →
 |  |  |  |  |  |  |  |  |  |  |  |  |  |  |  |  | 5 | Shift |  | W | X | C | V | B | N | , | ; | : | . | Shift
 |  |  |  |  |  |  |  |  |  |  |  |  |  |  |  |  | 6 | Ctrl | Fn | Win | Alt | Space |  |  |  |  | Alt Gr | Ctrl | ← | ↑ | →
 |  |  |  |  |  |  |  |  |  |  |  |  |  |  |  |  | 7 |  |  |  |  |  |  |  |  |  |  |  |  | ↓
 |  |  |  |  |  |  |  |  |  |  |  |  |  |  |  |  |  | A | B | C | D | R | F | G | H | I | J | K | L | M | N
 |  |  |  |  |  |  |  |  |  |  |  |  |  |  |  |  | 1 | Escap |  |  |  |  |  |  |  |  |  |  |  |  | Del |  | E
 |  |  |  |  |  |  |  |  |  |  |  |  |  |  |  |  | 2 | 3 | 1 | 2 | 3 | 4 | 5 | 6 | 7 | 8 | 9 | 0 |  |  | Back space
 |  |  |  |  |  |  |  |  |  |  |  |  |  |  |  |  | 3 | Tab | A | Z | E | R | T | Y | U | I | O | P |  |  | Return | return
 |  |  |  |  |  |  |  |  |  |  |  |  |  |  |  |  | 4 | #&+ | Q | S | D | F | G | H | J | K | L | M |  |  |  | →
 |  |  |  |  |  |  |  |  |  |  |  |  |  |  |  |  | 5 | Shift |  | W | X | C | V | B | N | , | ; | : | . | Shift
 |  |  |  |  |  |  |  |  |  |  |  |  |  |  |  |  | 6 | Ctrl | Fn | Win | Alt | Space |  |  |  |  | Alt Gr | Ctrl | ← | ↑ | →
 |  |  |  |  |  |  |  |  |  |  |  |  |  |  |  |  | 7 |  |  |  |  |  |  |  |  |  |  |  |  | ↓
 |  |  |  |  |  |  |  |  |  |  |  |  |  |  |  |  |  | A | B | C | D | R | F | G | H | I | J | K | L | M | N
 |  |  |  |  |  |  |  |  |  |  |  |  |  |  |  |  | 1 | Escap |  |  |  |  |  |  |  |  |  |  |  |  | Del |  | R
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
 |  |  |  |  |  |  |  |  |  |  |  |  |  |  |  |  | 1 | Escap |  |  |  |  |  |  |  |  |  |  |  |  | Del |  | B
 |  |  |  |  |  |  |  |  |  |  |  |  |  |  |  |  | 2 | 3 | 1 | 2 | 3 | 4 | 5 | 6 | 7 | 8 | 9 | 0 |  |  | Back space
 |  |  |  |  |  |  |  |  |  |  |  |  |  |  |  |  | 3 | Tab | A | Z | E | R | T | Y | U | I | O | P |  |  | Return | return
 |  |  |  |  |  |  |  |  |  |  |  |  |  |  |  |  | 4 | #&+ | Q | S | D | F | G | H | J | K | L | M |  |  |  | →
 |  |  |  |  |  |  |  |  |  |  |  |  |  |  |  |  | 5 | Shift |  | W | X | C | V | B | N | , | ; | : | . | Shift
 |  |  |  |  |  |  |  |  |  |  |  |  |  |  |  |  | 6 | Ctrl | Fn | Win | Alt | Space |  |  |  |  | Alt Gr | Ctrl | ← | ↑ | →
 |  |  |  |  |  |  |  |  |  |  |  |  |  |  |  |  | 7 |  |  |  |  |  |  |  |  |  |  |  |  | ↓
 |  |  |  |  |  |  |  |  |  |  |  |  |  |  |  |  |  | A | B | C | D | R | F | G | H | I | J | K | L | M | N
 |  |  |  |  |  |  |  |  |  |  |  |  |  |  |  |  | 1 | Escap |  |  |  |  |  |  |  |  |  |  |  |  | Del |  | N
 |  |  |  |  |  |  |  |  |  |  |  |  |  |  |  |  | 2 | 3 | 1 | 2 | 3 | 4 | 5 | 6 | 7 | 8 | 9 | 0 |  |  | Back space
 |  |  |  |  |  |  |  |  |  |  |  |  |  |  |  |  | 3 | Tab | A | Z | E | R | T | Y | U | I | O | P |  |  | Return | return
 |  |  |  |  |  |  |  |  |  |  |  |  |  |  |  |  | 4 | #&+ | Q | S | D | F | G | H | J | K | L | M |  |  |  | →
 |  |  |  |  |  |  |  |  |  |  |  |  |  |  |  |  | 5 | Shift |  | W | X | C | V | B | N | , | ; | : | . | Shift
 |  |  |  |  |  |  |  |  |  |  |  |  |  |  |  |  | 6 | Ctrl | Fn | Win | Alt | Space |  |  |  |  | Alt Gr | Ctrl | ← | ↑ | →
 |  |  |  |  |  |  |  |  |  |  |  |  |  |  |  |  | 7 |  |  |  |  |  |  |  |  |  |  |  |  | ↓
 | A | B | C | D | R | F | G | H | I | J | K | L | M | N
1 | Escap |  |  |  |  |  |  |  |  |  |  |  |  | Del |  |  |  | w
2 | ² | 1 | 2 | 3 | 4 | 5 | 6 | 7 | 8 | 9 | 0 |  |  | Back space
3 | Tab | a | z | e | r | t | y | u | i | o | p |  |  | Return | return
4 | #&+ | q | s | d | f | g | h | j | k | l | m |  |  |  | →
5 | Shift |  | w | x | c | v | b | n | , | ; | : | . | Shift
6 | Ctrl | Fn | Win | Alt | Space |  |  |  |  | Alt Gr | Ctrl | ← | ↑ | →
7 |  |  |  |  |  |  |  |  |  |  |  |  | ↓
 | A | B | C | D | R | F | G | H | I | J | K | L | M | N
1 | Escap |  |  |  |  |  |  |  |  |  |  |  |  | Del |  |  |  | x
2 | ² | 1 | 2 | 3 | 4 | 5 | 6 | 7 | 8 | 9 | 0 |  |  | Back space
3 | Tab | a | z | e | r | t | y | u | i | o | p |  |  | Return | return
4 | #&+ | q | s | d | f | g | h | j | k | l | m |  |  |  | →
5 | Shift |  | w | x | c | v | b | n | , | ; | : | . | Shift
6 | Ctrl | Fn | Win | Alt | Space |  |  |  |  | Alt Gr | Ctrl | ← | ↑ | →
7 |  |  |  |  |  |  |  |  |  |  |  |  | ↓
 | A | B | C | D | R | F | G | H | I | J | K | L | M | N
1 | Escap |  |  |  |  |  |  |  |  |  |  |  |  | Del |  |  |  | c
2 | ² | 1 | 2 | 3 | 4 | 5 | 6 | 7 | 8 | 9 | 0 |  |  | Back space
3 | Tab | a | z | e | r | t | y | u | i | o | p |  |  | Return | return
4 | #&+ | q | s | d | f | g | h | j | k | l | m |  |  |  | →
5 | Shift |  | w | x | c | v | b | n | , | ; | : | . | Shift
6 | Ctrl | Fn | Win | Alt | Space |  |  |  |  | Alt Gr | Ctrl | ← | ↑ | →
7 |  |  |  |  |  |  |  |  |  |  |  |  | ↓
 | A | B | C | D | R | F | G | H | I | J | K | L | M | N
1 | Escap |  |  |  |  |  |  |  |  |  |  |  |  | Del |  |  |  | v
2 | ² | 1 | 2 | 3 | 4 | 5 | 6 | 7 | 8 | 9 | 0 |  |  | Back space
3 | Tab | a | z | e | r | t | y | u | i | o | p |  |  | Return | return
4 | #&+ | q | s | d | f | g | h | j | k | l | m |  |  |  | →
5 | Shift |  | w | x | c | v | b | n | , | ; | : | . | Shift
6 | Ctrl | Fn | Win | Alt | Space |  |  |  |  | Alt Gr | Ctrl | ← | ↑ | →
7 |  |  |  |  |  |  |  |  |  |  |  |  | ↓
 | A | B | C | D | R | F | G | H | I | J | K | L | M | N
1 | Escap |  |  |  |  |  |  |  |  |  |  |  |  | Del |  |  |  | b
2 | ² | 1 | 2 | 3 | 4 | 5 | 6 | 7 | 8 | 9 | 0 |  |  | Back space
3 | Tab | a | z | e | r | t | y | u | i | o | p |  |  | Return | return
4 | #&+ | q | s | d | f | g | h | j | k | l | m |  |  |  | →
5 | Shift |  | w | x | c | v | b | n | , | ; | : | . | Shift
6 | Ctrl | Fn | Win | Alt | Space |  |  |  |  | Alt Gr | Ctrl | ← | ↑ | →
7 |  |  |  |  |  |  |  |  |  |  |  |  | ↓
 | A | B | C | D | R | F | G | H | I | J | K | L | M | N
1 | Escap |  |  |  |  |  |  |  |  |  |  |  |  | Del |  |  |  | n
2 | ² | 1 | 2 | 3 | 4 | 5 | 6 | 7 | 8 | 9 | 0 |  |  | Back space
3 | Tab | a | z | e | r | t | y | u | i | o | p |  |  | Return | return
4 | #&+ | q | s | d | f | g | h | j | k | l | m |  |  |  | →
5 | Shift |  | w | x | c | v | b | n | , | ; | : | . | Shift
6 | Ctrl | Fn | Win | Alt | Space |  |  |  |  | Alt Gr | Ctrl | ← | ↑ | →
7 |  |  |  |  |  |  |  |  |  |  |  |  | ↓
 | A | B | C | D | R | F | G | H | I | J | K | L | M | N
1 | Escap |  |  |  |  |  |  |  |  |  |  |  |  | Del |  |  |  | ,
2 | ² | 1 | 2 | 3 | 4 | 5 | 6 | 7 | 8 | 9 | 0 |  |  | Back space
3 | Tab | a | z | e | r | t | y | u | i | o | p |  |  | Return | return
4 | #&+ | q | s | d | f | g | h | j | k | l | m |  |  |  | →
5 | Shift |  | w | x | c | v | b | n | , | ; | : | . | Shift
6 | Ctrl | Fn | Win | Alt | Space |  |  |  |  | Alt Gr | Ctrl | ← | ↑ | →
7 |  |  |  |  |  |  |  |  |  |  |  |  | ↓
 | A | B | C | D | R | F | G | H | I | J | K | L | M | N
1 | Escap |  |  |  |  |  |  |  |  |  |  |  |  | Del |  |  |  | ;
2 | ² | 1 | 2 | 3 | 4 | 5 | 6 | 7 | 8 | 9 | 0 |  |  | Back space
3 | Tab | a | z | e | r | t | y | u | i | o | p |  |  | Return | return
4 | #&+ | q | s | d | f | g | h | j | k | l | m |  |  |  | →
5 | Shift |  | w | x | c | v | b | n | , | ; | : | . | Shift
6 | Ctrl | Fn | Win | Alt | Space |  |  |  |  | Alt Gr | Ctrl | ← | ↑ | →
7 |  |  |  |  |  |  |  |  |  |  |  |  | ↓
 | A | B | C | D | R | F | G | H | I | J | K | L | M | N
1 | Escap |  |  |  |  |  |  |  |  |  |  |  |  | Del |  |  |  | :
2 | ² | 1 | 2 | 3 | 4 | 5 | 6 | 7 | 8 | 9 | 0 |  |  | Back space
3 | Tab | a | z | e | r | t | y | u | i | o | p |  |  | Return | return
4 | #&+ | q | s | d | f | g | h | j | k | l | m |  |  |  | →
5 | Shift |  | w | x | c | v | b | n | , | ; | : | . | Shift
6 | Ctrl | Fn | Win | Alt | Space |  |  |  |  | Alt Gr | Ctrl | ← | ↑ | →
7 |  |  |  |  |  |  |  |  |  |  |  |  | ↓
 | A | B | C | D | R | F | G | H | I | J | K | L | M | N
1 | Escap |  |  |  |  |  |  |  |  |  |  |  |  | Del |  |  |  | .
2 | ² | 1 | 2 | 3 | 4 | 5 | 6 | 7 | 8 | 9 | 0 |  |  | Back space
3 | Tab | a | z | e | r | t | y | u | i | o | p |  |  | Return | return
4 | #&+ | q | s | d | f | g | h | j | k | l | m |  |  |  | →
5 | Shift |  | w | x | c | v | b | n | , | ; | : | . | Shift
6 | Ctrl | Fn | Win | Alt | Space |  |  |  |  | Alt Gr | Ctrl | ← | ↑ | →
7 |  |  |  |  |  |  |  |  |  |  |  |  | ↓
 | A | B | C | D | R | F | G | H | I | J | K | L | M | N
1 | Escap |  |  |  |  |  |  |  |  |  |  |  |  | Del |  |  |  | (Same as the other side)
2 | ² | 1 | 2 | 3 | 4 | 5 | 6 | 7 | 8 | 9 | 0 |  |  | Back space
3 | Tab | a | z | e | r | t | y | u | i | o | p |  |  | Return | return
4 | #&+ | q | s | d | f | g | h | j | k | l | m |  |  |  | →
5 | Shift |  | w | x | c | v | b | n | , | ; | : | . | Shift
6 | Ctrl | Fn | Win | Alt | Space |  |  |  |  | Alt Gr | Ctrl | ← | ↑ | →
7 |  |  |  |  |  |  |  |  |  |  |  |  | ↓
 | A | B | C | D | R | F | G | H | I | J | K | L | M | N
1 | Escap |  |  |  |  |  |  |  |  |  |  |  |  | Del |  |  |  | Control
2 | ² | 1 | 2 | 3 | 4 | 5 | 6 | 7 | 8 | 9 | 0 |  |  | Back space
3 | Tab | a | z | e | r | t | y | u | i | o | p |  |  | Return | return
4 | #&+ | q | s | d | f | g | h | j | k | l | m |  |  |  | →
5 | Shift |  | w | x | c | v | b | n | , | ; | : | . | Shift
6 | Ctrl | Fn | Win | Alt | Space |  |  |  |  | Alt Gr | Ctrl | ← | ↑ | →
7 |  |  |  |  |  |  |  |  |  |  |  |  | ↓
 | A | B | C | D | R | F | G | H | I | J | K | L | M | N |  |  |  | A | B | C | D | R | F | G | H | I | J | K | L | M | N
1 | Escap |  |  |  |  |  |  |  |  |  |  |  |  | Del |  |  | 1 | Escap | f1 | f2 | f3 | f4 | f5 | f6 | f7 | f8 | f9 | f10 | f11 | f12 | Del
2 | ² | 1 | 2 | 3 | 4 | 5 | 6 | 7 | 8 | 9 | 0 |  |  | Back space |  |  | 2 | ² | 1 | 2 | 3 | 4 | 5 | 6 | 7 | 8 | 9 | 0 |  |  | Back space
3 | Tab | a | z | e | r | t | y | u | i | o | p |  |  | Return | return |  | 3 | Tab | a | z | e | r | t | y | u | i | o | p |  |  | Return
4 | #&+ | q | s | d | f | g | h | j | k | l | m |  |  |  | → |  | 4 | #&+ | q | s | d | f | g | h | j | k | l | m
5 | Shift |  | w | x | c | v | b | n | , | ; | : | . | Shift |  |  |  | 5 | Shift |  | w | x | c | v | b | n | , | ; | : | . | Shift
6 | Ctrl | Fn | Win | Alt | Space |  |  |  |  | Alt Gr | Ctrl | ← | ↑ | → |  |  | 6 | Ctrl | Fn | Win | Alt | Space |  |  |  |  | Alt Gr | Ctrl | ← | ↑ | →
7 |  |  |  |  |  |  |  |  |  |  |  |  | ↓ |  |  |  | 7 |  |  |  |  |  |  |  |  |  |  |  |  | ↓
 |  |  |  |  |  |  |  |  |  |  |  |  |  |  |  |  |  | A | B | C | D | R | F | G | H | I | J | K | L | M | N
 |  |  |  |  |  |  |  |  |  |  |  |  |  |  |  |  | 1 | Escap | f1 | f2 | f3 | f4 | f5 | f6 | f7 | f8 | f9 | f10 | f11 | f12 | Del |  | f1
 |  |  |  |  |  |  |  |  |  |  |  |  |  |  |  |  | 2 | ² | 1 | 2 | 3 | 4 | 5 | 6 | 7 | 8 | 9 | 0 |  |  | Back space
 |  |  |  |  |  |  |  |  |  |  |  |  |  |  |  |  | 3 | Tab | a | z | e | r | t | y | u | i | o | p |  |  | Return | return
 |  |  |  |  |  |  |  |  |  |  |  |  |  |  |  |  | 4 | #&+ | q | s | d | f | g | h | j | k | l | m |  |  |  | →
 |  |  |  |  |  |  |  |  |  |  |  |  |  |  |  |  | 5 | Shift |  | w | x | c | v | b | n | , | ; | : | . | Shift
 |  |  |  |  |  |  |  |  |  |  |  |  |  |  |  |  | 6 | Ctrl | Fn | Win | Alt | Space |  |  |  |  | Alt Gr | Ctrl | ← | ↑ | →
 |  |  |  |  |  |  |  |  |  |  |  |  |  |  |  |  | 7 |  |  |  |  |  |  |  |  |  |  |  |  | ↓
 |  |  |  |  |  |  |  |  |  |  |  |  |  |  |  |  |  | A | B | C | D | R | F | G | H | I | J | K | L | M | N
 |  |  |  |  |  |  |  |  |  |  |  |  |  |  |  |  | 1 | Escap | f1 | f2 | f3 | f4 | f5 | f6 | f7 | f8 | f9 | f10 | f11 | f12 | Del |  | f2
 |  |  |  |  |  |  |  |  |  |  |  |  |  |  |  |  | 2 | ² | 1 | 2 | 3 | 4 | 5 | 6 | 7 | 8 | 9 | 0 |  |  | Back space
 |  |  |  |  |  |  |  |  |  |  |  |  |  |  |  |  | 3 | Tab | a | z | e | r | t | y | u | i | o | p |  |  | Return | return
 |  |  |  |  |  |  |  |  |  |  |  |  |  |  |  |  | 4 | #&+ | q | s | d | f | g | h | j | k | l | m |  |  |  | →
 |  |  |  |  |  |  |  |  |  |  |  |  |  |  |  |  | 5 | Shift |  | w | x | c | v | b | n | , | ; | : | . | Shift
 |  |  |  |  |  |  |  |  |  |  |  |  |  |  |  |  | 6 | Ctrl | Fn | Win | Alt | Space |  |  |  |  | Alt Gr | Ctrl | ← | ↑ | →
 |  |  |  |  |  |  |  |  |  |  |  |  |  |  |  |  | 7 |  |  |  |  |  |  |  |  |  |  |  |  | ↓
 |  |  |  |  |  |  |  |  |  |  |  |  |  |  |  |  |  | A | B | C | D | R | F | G | H | I | J | K | L | M | N
 |  |  |  |  |  |  |  |  |  |  |  |  |  |  |  |  | 1 | Escap | f1 | f2 | f3 | f4 | f5 | f6 | f7 | f8 | f9 | f10 | f11 | f12 | Del |  | f3
 |  |  |  |  |  |  |  |  |  |  |  |  |  |  |  |  | 2 | ² | 1 | 2 | 3 | 4 | 5 | 6 | 7 | 8 | 9 | 0 |  |  | Back space
 |  |  |  |  |  |  |  |  |  |  |  |  |  |  |  |  | 3 | Tab | a | z | e | r | t | y | u | i | o | p |  |  | Return | return
 |  |  |  |  |  |  |  |  |  |  |  |  |  |  |  |  | 4 | #&+ | q | s | d | f | g | h | j | k | l | m |  |  |  | →
 |  |  |  |  |  |  |  |  |  |  |  |  |  |  |  |  | 5 | Shift |  | w | x | c | v | b | n | , | ; | : | . | Shift
 |  |  |  |  |  |  |  |  |  |  |  |  |  |  |  |  | 6 | Ctrl | Fn | Win | Alt | Space |  |  |  |  | Alt Gr | Ctrl | ← | ↑ | →
 |  |  |  |  |  |  |  |  |  |  |  |  |  |  |  |  | 7 |  |  |  |  |  |  |  |  |  |  |  |  | ↓
 |  |  |  |  |  |  |  |  |  |  |  |  |  |  |  |  |  | A | B | C | D | R | F | G | H | I | J | K | L | M | N
 |  |  |  |  |  |  |  |  |  |  |  |  |  |  |  |  | 1 | Escap | f1 | f2 | f3 | f4 | f5 | f6 | f7 | f8 | f9 | f10 | f11 | f12 | Del |  | f4
 |  |  |  |  |  |  |  |  |  |  |  |  |  |  |  |  | 2 | ² | 1 | 2 | 3 | 4 | 5 | 6 | 7 | 8 | 9 | 0 |  |  | Back space
 |  |  |  |  |  |  |  |  |  |  |  |  |  |  |  |  | 3 | Tab | a | z | e | r | t | y | u | i | o | p |  |  | Return | return
 |  |  |  |  |  |  |  |  |  |  |  |  |  |  |  |  | 4 | #&+ | q | s | d | f | g | h | j | k | l | m |  |  |  | →
 |  |  |  |  |  |  |  |  |  |  |  |  |  |  |  |  | 5 | Shift |  | w | x | c | v | b | n | , | ; | : | . | Shift
 |  |  |  |  |  |  |  |  |  |  |  |  |  |  |  |  | 6 | Ctrl | Fn | Win | Alt | Space |  |  |  |  | Alt Gr | Ctrl | ← | ↑ | →
 |  |  |  |  |  |  |  |  |  |  |  |  |  |  |  |  | 7 |  |  |  |  |  |  |  |  |  |  |  |  | ↓
 |  |  |  |  |  |  |  |  |  |  |  |  |  |  |  |  |  | A | B | C | D | R | F | G | H | I | J | K | L | M | N
 |  |  |  |  |  |  |  |  |  |  |  |  |  |  |  |  | 1 | Escap | f1 | f2 | f3 | f4 | f5 | f6 | f7 | f8 | f9 | f10 | f11 | f12 | Del |  | f5
 |  |  |  |  |  |  |  |  |  |  |  |  |  |  |  |  | 2 | ² | 1 | 2 | 3 | 4 | 5 | 6 | 7 | 8 | 9 | 0 |  |  | Back space
 |  |  |  |  |  |  |  |  |  |  |  |  |  |  |  |  | 3 | Tab | a | z | e | r | t | y | u | i | o | p |  |  | Return | return
 |  |  |  |  |  |  |  |  |  |  |  |  |  |  |  |  | 4 | #&+ | q | s | d | f | g | h | j | k | l | m |  |  |  | →
 |  |  |  |  |  |  |  |  |  |  |  |  |  |  |  |  | 5 | Shift |  | w | x | c | v | b | n | , | ; | : | . | Shift
 |  |  |  |  |  |  |  |  |  |  |  |  |  |  |  |  | 6 | Ctrl | Fn | Win | Alt | Space |  |  |  |  | Alt Gr | Ctrl | ← | ↑ | →
 |  |  |  |  |  |  |  |  |  |  |  |  |  |  |  |  | 7 |  |  |  |  |  |  |  |  |  |  |  |  | ↓
 |  |  |  |  |  |  |  |  |  |  |  |  |  |  |  |  |  | A | B | C | D | R | F | G | H | I | J | K | L | M | N
 |  |  |  |  |  |  |  |  |  |  |  |  |  |  |  |  | 1 | Escap | f1 | f2 | f3 | f4 | f5 | f6 | f7 | f8 | f9 | f10 | f11 | f12 | Del |  | f6
 |  |  |  |  |  |  |  |  |  |  |  |  |  |  |  |  | 2 | ² | 1 | 2 | 3 | 4 | 5 | 6 | 7 | 8 | 9 | 0 |  |  | Back space
 |  |  |  |  |  |  |  |  |  |  |  |  |  |  |  |  | 3 | Tab | a | z | e | r | t | y | u | i | o | p |  |  | Return | return
 |  |  |  |  |  |  |  |  |  |  |  |  |  |  |  |  | 4 | #&+ | q | s | d | f | g | h | j | k | l | m |  |  |  | →
 |  |  |  |  |  |  |  |  |  |  |  |  |  |  |  |  | 5 | Shift |  | w | x | c | v | b | n | , | ; | : | . | Shift
 |  |  |  |  |  |  |  |  |  |  |  |  |  |  |  |  | 6 | Ctrl | Fn | Win | Alt | Space |  |  |  |  | Alt Gr | Ctrl | ← | ↑ | →
 |  |  |  |  |  |  |  |  |  |  |  |  |  |  |  |  | 7 |  |  |  |  |  |  |  |  |  |  |  |  | ↓
 |  |  |  |  |  |  |  |  |  |  |  |  |  |  |  |  |  | A | B | C | D | R | F | G | H | I | J | K | L | M | N
 |  |  |  |  |  |  |  |  |  |  |  |  |  |  |  |  | 1 | Escap | f1 | f2 | f3 | f4 | f5 | f6 | f7 | f8 | f9 | f10 | f11 | f12 | Del |  | f7
 |  |  |  |  |  |  |  |  |  |  |  |  |  |  |  |  | 2 | ² | 1 | 2 | 3 | 4 | 5 | 6 | 7 | 8 | 9 | 0 |  |  | Back space
 |  |  |  |  |  |  |  |  |  |  |  |  |  |  |  |  | 3 | Tab | a | z | e | r | t | y | u | i | o | p |  |  | Return | return
 |  |  |  |  |  |  |  |  |  |  |  |  |  |  |  |  | 4 | #&+ | q | s | d | f | g | h | j | k | l | m |  |  |  | →
 |  |  |  |  |  |  |  |  |  |  |  |  |  |  |  |  | 5 | Shift |  | w | x | c | v | b | n | , | ; | : | . | Shift
 |  |  |  |  |  |  |  |  |  |  |  |  |  |  |  |  | 6 | Ctrl | Fn | Win | Alt | Space |  |  |  |  | Alt Gr | Ctrl | ← | ↑ | →
 |  |  |  |  |  |  |  |  |  |  |  |  |  |  |  |  | 7 |  |  |  |  |  |  |  |  |  |  |  |  | ↓
 |  |  |  |  |  |  |  |  |  |  |  |  |  |  |  |  |  | A | B | C | D | R | F | G | H | I | J | K | L | M | N
 |  |  |  |  |  |  |  |  |  |  |  |  |  |  |  |  | 1 | Escap | f1 | f2 | f3 | f4 | f5 | f6 | f7 | f8 | f9 | f10 | f11 | f12 | Del |  | f8
 |  |  |  |  |  |  |  |  |  |  |  |  |  |  |  |  | 2 | ² | 1 | 2 | 3 | 4 | 5 | 6 | 7 | 8 | 9 | 0 |  |  | Back space
 |  |  |  |  |  |  |  |  |  |  |  |  |  |  |  |  | 3 | Tab | a | z | e | r | t | y | u | i | o | p |  |  | Return | return
 |  |  |  |  |  |  |  |  |  |  |  |  |  |  |  |  | 4 | #&+ | q | s | d | f | g | h | j | k | l | m |  |  |  | →
 |  |  |  |  |  |  |  |  |  |  |  |  |  |  |  |  | 5 | Shift |  | w | x | c | v | b | n | , | ; | : | . | Shift
 |  |  |  |  |  |  |  |  |  |  |  |  |  |  |  |  | 6 | Ctrl | Fn | Win | Alt | Space |  |  |  |  | Alt Gr | Ctrl | ← | ↑ | →
 |  |  |  |  |  |  |  |  |  |  |  |  |  |  |  |  | 7 |  |  |  |  |  |  |  |  |  |  |  |  | ↓
 |  |  |  |  |  |  |  |  |  |  |  |  |  |  |  |  |  | A | B | C | D | R | F | G | H | I | J | K | L | M | N
 |  |  |  |  |  |  |  |  |  |  |  |  |  |  |  |  | 1 | Escap | f1 | f2 | f3 | f4 | f5 | f6 | f7 | f8 | f9 | f10 | f11 | f12 | Del |  | f9
 |  |  |  |  |  |  |  |  |  |  |  |  |  |  |  |  | 2 | ² | 1 | 2 | 3 | 4 | 5 | 6 | 7 | 8 | 9 | 0 |  |  | Back space
 |  |  |  |  |  |  |  |  |  |  |  |  |  |  |  |  | 3 | Tab | a | z | e | r | t | y | u | i | o | p |  |  | Return | return
 |  |  |  |  |  |  |  |  |  |  |  |  |  |  |  |  | 4 | #&+ | q | s | d | f | g | h | j | k | l | m |  |  |  | →
 |  |  |  |  |  |  |  |  |  |  |  |  |  |  |  |  | 5 | Shift |  | w | x | c | v | b | n | , | ; | : | . | Shift
 |  |  |  |  |  |  |  |  |  |  |  |  |  |  |  |  | 6 | Ctrl | Fn | Win | Alt | Space |  |  |  |  | Alt Gr | Ctrl | ← | ↑ | →
 |  |  |  |  |  |  |  |  |  |  |  |  |  |  |  |  | 7 |  |  |  |  |  |  |  |  |  |  |  |  | ↓
 |  |  |  |  |  |  |  |  |  |  |  |  |  |  |  |  |  | A | B | C | D | R | F | G | H | I | J | K | L | M | N
 |  |  |  |  |  |  |  |  |  |  |  |  |  |  |  |  | 1 | Escap | f1 | f2 | f3 | f4 | f5 | f6 | f7 | f8 | f9 | f10 | f11 | f12 | Del |  | f10
 |  |  |  |  |  |  |  |  |  |  |  |  |  |  |  |  | 2 | ² | 1 | 2 | 3 | 4 | 5 | 6 | 7 | 8 | 9 | 0 |  |  | Back space
 |  |  |  |  |  |  |  |  |  |  |  |  |  |  |  |  | 3 | Tab | a | z | e | r | t | y | u | i | o | p |  |  | Return | return
 |  |  |  |  |  |  |  |  |  |  |  |  |  |  |  |  | 4 | #&+ | q | s | d | f | g | h | j | k | l | m |  |  |  | →
 |  |  |  |  |  |  |  |  |  |  |  |  |  |  |  |  | 5 | Shift |  | w | x | c | v | b | n | , | ; | : | . | Shift
 |  |  |  |  |  |  |  |  |  |  |  |  |  |  |  |  | 6 | Ctrl | Fn | Win | Alt | Space |  |  |  |  | Alt Gr | Ctrl | ← | ↑ | →
 |  |  |  |  |  |  |  |  |  |  |  |  |  |  |  |  | 7 |  |  |  |  |  |  |  |  |  |  |  |  | ↓
 |  |  |  |  |  |  |  |  |  |  |  |  |  |  |  |  |  | A | B | C | D | R | F | G | H | I | J | K | L | M | N
 |  |  |  |  |  |  |  |  |  |  |  |  |  |  |  |  | 1 | Escap | f1 | f2 | f3 | f4 | f5 | f6 | f7 | f8 | f9 | f10 | f11 | f12 | Del |  | f11
 |  |  |  |  |  |  |  |  |  |  |  |  |  |  |  |  | 2 | ² | 1 | 2 | 3 | 4 | 5 | 6 | 7 | 8 | 9 | 0 |  |  | Back space
 |  |  |  |  |  |  |  |  |  |  |  |  |  |  |  |  | 3 | Tab | a | z | e | r | t | y | u | i | o | p |  |  | Return | return
 |  |  |  |  |  |  |  |  |  |  |  |  |  |  |  |  | 4 | #&+ | q | s | d | f | g | h | j | k | l | m |  |  |  | →
 |  |  |  |  |  |  |  |  |  |  |  |  |  |  |  |  | 5 | Shift |  | w | x | c | v | b | n | , | ; | : | . | Shift
 |  |  |  |  |  |  |  |  |  |  |  |  |  |  |  |  | 6 | Ctrl | Fn | Win | Alt | Space |  |  |  |  | Alt Gr | Ctrl | ← | ↑ | →
 |  |  |  |  |  |  |  |  |  |  |  |  |  |  |  |  | 7 |  |  |  |  |  |  |  |  |  |  |  |  | ↓
 |  |  |  |  |  |  |  |  |  |  |  |  |  |  |  |  |  | A | B | C | D | R | F | G | H | I | J | K | L | M | N
 |  |  |  |  |  |  |  |  |  |  |  |  |  |  |  |  | 1 | Escap | f1 | f2 | f3 | f4 | f5 | f6 | f7 | f8 | f9 | f10 | f11 | f12 | Del |  | f12
 |  |  |  |  |  |  |  |  |  |  |  |  |  |  |  |  | 2 | ² | 1 | 2 | 3 | 4 | 5 | 6 | 7 | 8 | 9 | 0 |  |  | Back space
 |  |  |  |  |  |  |  |  |  |  |  |  |  |  |  |  | 3 | Tab | a | z | e | r | t | y | u | i | o | p |  |  | Return | return
 |  |  |  |  |  |  |  |  |  |  |  |  |  |  |  |  | 4 | #&+ | q | s | d | f | g | h | j | k | l | m |  |  |  | →
 |  |  |  |  |  |  |  |  |  |  |  |  |  |  |  |  | 5 | Shift |  | w | x | c | v | b | n | , | ; | : | . | Shift
 |  |  |  |  |  |  |  |  |  |  |  |  |  |  |  |  | 6 | Ctrl | Fn | Win | Alt | Space |  |  |  |  | Alt Gr | Ctrl | ← | ↑ | →
 |  |  |  |  |  |  |  |  |  |  |  |  |  |  |  |  | 7 |  |  |  |  |  |  |  |  |  |  |  |  | ↓
 | A | B | C | D | R | F | G | H | I | J | K | L | M | N
1 | Escap |  |  |  |  |  |  |  |  |  |  |  |  | Del |  |  |  | Windows
2 | ² | 1 | 2 | 3 | 4 | 5 | 6 | 7 | 8 | 9 | 0 |  |  | Back space
3 | Tab | a | z | e | r | t | y | u | i | o | p |  |  | Return | return
4 | #&+ | q | s | d | f | g | h | j | k | l | m |  |  |  | →
5 | Shift |  | w | x | c | v | b | n | , | ; | : | . | Shift
6 | Ctrl | Fn | Win | Alt | Space |  |  |  |  | Alt Gr | Ctrl | ← | ↑ | →
7 |  |  |  |  |  |  |  |  |  |  |  |  | ↓
 | A | B | C | D | R | F | G | H | I | J | K | L | M | N
1 | Escap |  |  |  |  |  |  |  |  |  |  |  |  | Del |  |  |  | Alt
2 | ² | 1 | 2 | 3 | 4 | 5 | 6 | 7 | 8 | 9 | 0 |  |  | Back space
3 | Tab | a | z | e | r | t | y | u | i | o | p |  |  | Return | return
4 | #&+ | q | s | d | f | g | h | j | k | l | m |  |  |  | →
5 | Shift |  | w | x | c | v | b | n | , | ; | : | . | Shift
6 | Ctrl | Fn | Win | Alt | Space |  |  |  |  | Alt Gr | Ctrl | ← | ↑ | →
7 |  |  |  |  |  |  |  |  |  |  |  |  | ↓
 | A | B | C | D | R | F | G | H | I | J | K | L | M | N
1 | Escap |  |  |  |  |  |  |  |  |  |  |  |  | Del |  |  |  | Space
2 | ² | 1 | 2 | 3 | 4 | 5 | 6 | 7 | 8 | 9 | 0 |  |  | Back space
3 | Tab | a | z | e | r | t | y | u | i | o | p |  |  | Return | return
4 | #&+ | q | s | d | f | g | h | j | k | l | m |  |  |  | →
5 | Shift |  | w | x | c | v | b | n | , | ; | : | . | Shift
6 | Ctrl | Fn | Win | Alt | Space |  |  |  |  | Alt Gr | Ctrl | ← | ↑ | →
7 |  |  |  |  |  |  |  |  |  |  |  |  | ↓
 | A | B | C | D | R | F | G | H | I | J | K | L | M | N
1 | Escap |  |  |  |  |  |  |  |  |  |  |  |  | Del |  |  |  | Alt Gr
2 | ² | 1 | 2 | 3 | 4 | 5 | 6 | 7 | 8 | 9 | 0 |  |  | Back space
3 | Tab | a | z | e | r | t | y | u | i | o | p |  |  | Return | return
4 | #&+ | q | s | d | f | g | h | j | k | l | m |  |  |  | →
5 | Shift |  | w | x | c | v | b | n | , | ; | : | . | Shift
6 | Ctrl | Fn | Win | Alt | Space |  |  |  |  | Alt Gr | Ctrl | ← | ↑ | →
7 |  |  |  |  |  |  |  |  |  |  |  |  | ↓
 | A | B | C | D | R | F | G | H | I | J | K | L | M | N
1 | Escap |  |  |  |  |  |  |  |  |  |  |  |  | Del |  |  |  | Control
2 | ² | 1 | 2 | 3 | 4 | 5 | 6 | 7 | 8 | 9 | 0 |  |  | Back space
3 | Tab | a | z | e | r | t | y | u | i | o | p |  |  | Return | return
4 | #&+ | q | s | d | f | g | h | j | k | l | m |  |  |  | →
5 | Shift |  | w | x | c | v | b | n | , | ; | : | . | Shift
6 | Ctrl | Fn | Win | Alt | Space |  |  |  |  | Alt Gr | Ctrl | ← | ↑ | →
7 |  |  |  |  |  |  |  |  |  |  |  |  | ↓
 | A | B | C | D | R | F | G | H | I | J | K | L | M | N
1 | Escap |  |  |  |  |  |  |  |  |  |  |  |  | Del |  |  |  | left arrow
2 | ² | 1 | 2 | 3 | 4 | 5 | 6 | 7 | 8 | 9 | 0 |  |  | Back space
3 | Tab | a | z | e | r | t | y | u | i | o | p |  |  | Return | return
4 | #&+ | q | s | d | f | g | h | j | k | l | m |  |  |  | →
5 | Shift |  | w | x | c | v | b | n | , | ; | ? | ! | Shift
6 | Ctrl | Fn | Win | Alt | Space |  |  |  |  | Alt Gr | Ctrl | ← | ↑ | →
7 |  |  |  |  |  |  |  |  |  |  |  |  | ↓
 | A | B | C | D | R | F | G | H | I | J | K | L | M | N
1 | Escap |  |  |  |  |  |  |  |  |  |  |  |  | Del |  |  |  | up arrow
2 | ² | 1 | 2 | 3 | 4 | 5 | 6 | 7 | 8 | 9 | 0 |  |  | Back space
3 | Tab | a | z | e | r | t | y | u | i | o | p |  |  | Return | return
4 | #&+ | q | s | d | f | g | h | j | k | l | m |  |  |  | →
5 | Shift |  | w | x | c | v | b | n | , | ; | : | . | Shift
6 | Ctrl | Fn | Win | Alt | Space |  |  |  |  | Alt Gr | Ctrl | ← | ↑ | →
7 |  |  |  |  |  |  |  |  |  |  |  |  | ↓
 | A | B | C | D | R | F | G | H | I | J | K | L | M | N
1 | Escap |  |  |  |  |  |  |  |  |  |  |  |  | Del |  |  |  | right arrow
2 | ² | 1 | 2 | 3 | 4 | 5 | 6 | 7 | 8 | 9 | 0 |  |  | Back space
3 | Tab | a | z | e | r | t | y | u | i | o | p |  |  | Return | return
4 | #&+ | q | s | d | f | g | h | j | k | l | m |  |  |  | →
5 | Shift |  | w | x | c | v | b | n | , | ; | : | . | Shift
6 | Ctrl | Fn | Win | Alt | Space |  |  |  |  | Alt Gr | Ctrl | ← | ↑ | →
7 |  |  |  |  |  |  |  |  |  |  |  |  | ↓
 | A | B | C | D | R | F | G | H | I | J | K | L | M | N
1 | Escap |  |  |  |  |  |  |  |  |  |  |  |  | Del |  |  |  | down arrow
2 | ² | 1 | 2 | 3 | 4 | 5 | 6 | 7 | 8 | 9 | 0 |  |  | Back space
3 | Tab | a | z | e | r | t | y | u | i | o | p |  |  | Return | return
4 | #&+ | q | s | d | f | g | h | j | k | l | m |  |  |  | →
5 | Shift |  | w | x | c | v | b | n | , | ; | : | . | Shift
6 | Ctrl | Fn | Win | Alt | Space |  |  |  |  | Alt Gr | Ctrl | ← | ↑ | →
7 |  |  |  |  |  |  |  |  |  |  |  |  | ↓

Sheet: Key maintained
 |  |  | Key is pressed for short time
 |  |  | While key is maintained - but until another key is pressed
 |  |  | While key is maintained
 |  |  | Key is pressed for long time
 |  |  | Key is "activated"
 | By default
 | A | B | C | D | R | F | G | H | I | J | K | L | M | N
1 | Escap |  |  |  |  |  |  |  |  |  |  |  |  | Del
2 | ² | 1 | 2 | 3 | 4 | 5 | 6 | 7 | 8 | 9 | 0 |  |  | Back space
3 | Tab | a | z | e | r | t | y | u | i | o | p |  |  | Return
4 | #&+ | q | s | d | f | g | h | j | k | l | m
5 | Shift |  | w | x | c | v | b | n | , | ; | : | . | Shift
6 | Ctrl | Fn | Win | Alt | Space |  |  |  |  | Alt Gr | Ctrl | ← | ↑ | →
7 |  |  |  |  |  |  |  |  |  |  |  |  | ↓
 | A | B | C | D | R | F | G | H | I | J | K | L | M | N |  |  | A | B | C | D | R | F | G | H | I | J | K | L | M | N
1 | Escap |  |  |  |  |  |  |  |  |  |  |  |  | Del |  | 1 | Escap
2 | ² | 1 | 2 | 3 | 4 | 5 | 6 | 7 | 8 | 9 | 0 |  |  | Back space |  | 2
3 | Tab | a | z | e | r | t | y | u | i | o | p |  |  | Return | return | 3 |  | a | à | á | â | ã | ä | å | ā | æ
4 | #&+ | q | s | d | f | g | h | j | k | l | m |  |  |  | → | 4
5 | Shift |  | w | x | c | v | b | n | , | ; | : | . | Shift |  | ← | 5 |  |  |  |  |  |  |  |  |  |  |  | .
6 | Ctrl | Fn | Win | Alt | Space |  |  |  |  | Alt Gr | Ctrl | ← | ↑ | → |  | 6
7 |  |  |  |  |  |  |  |  |  |  |  |  | ↓ |  |  | 7
 |  |  |  |  |  |  |  |  |  |  |  |  |  |  |  |  | A | B | C | D | R | F | G | H | I | J | K | L | M | N
 |  |  |  |  |  |  |  |  |  |  |  |  |  |  |  | 1 | Escap |  |  |  |  |  |  |  |  |  |  |  |  |  |  | a
 |  |  |  |  |  |  |  |  |  |  |  |  |  |  |  | 2
 |  |  |  |  |  |  |  |  |  |  |  |  |  |  |  | 3 |  | a | à | á | â | ã | ä | å | ā | æ |  |  |  |  | return
 |  |  |  |  |  |  |  |  |  |  |  |  |  |  |  | 4 |  |  |  |  |  |  |  |  |  |  |  |  |  |  | →
 |  |  |  |  |  |  |  |  |  |  |  |  |  |  |  | 5 |  |  |  |  |  |  |  |  |  |  |  | .
 |  |  |  |  |  |  |  |  |  |  |  |  |  |  |  | 6
 |  |  |  |  |  |  |  |  |  |  |  |  |  |  |  | 7
 |  |  |  |  |  |  |  |  |  |  |  |  |  |  |  |  | A | B | C | D | R | F | G | H | I | J | K | L | M | N
 |  |  |  |  |  |  |  |  |  |  |  |  |  |  |  | 1 | Escap |  |  |  |  |  |  |  |  |  |  |  |  |  |  | a
 |  |  |  |  |  |  |  |  |  |  |  |  |  |  |  | 2
 |  |  |  |  |  |  |  |  |  |  |  |  |  |  |  | 3 |  | a | à | á | â | ã | ä | å | ā | æ |  |  |  |  | return
 |  |  |  |  |  |  |  |  |  |  |  |  |  |  |  | 4 |  |  |  |  |  |  |  |  |  |  |  |  |  |  | →
 |  |  |  |  |  |  |  |  |  |  |  |  |  |  |  | 5 |  |  |  |  |  |  |  |  |  |  |  | .
 |  |  |  |  |  |  |  |  |  |  |  |  |  |  |  | 6
 |  |  |  |  |  |  |  |  |  |  |  |  |  |  |  | 7
 |  |  |  |  |  |  |  |  |  |  |  |  |  |  |  |  | A | B | C | D | R | F | G | H | I | J | K | L | M | N
 |  |  |  |  |  |  |  |  |  |  |  |  |  |  |  | 1 | Escap |  |  |  |  |  |  |  |  |  |  |  |  |  |  | à
 |  |  |  |  |  |  |  |  |  |  |  |  |  |  |  | 2
 |  |  |  |  |  |  |  |  |  |  |  |  |  |  |  | 3 |  | a | à | á | â | ã | ä | å | ā | æ |  |  |  |  | return
 |  |  |  |  |  |  |  |  |  |  |  |  |  |  |  | 4 |  |  |  |  |  |  |  |  |  |  |  |  |  |  | →
 |  |  |  |  |  |  |  |  |  |  |  |  |  |  |  | 5 |  |  |  |  |  |  |  |  |  |  |  | .

Sheet: Key maintained (temporarly)
 |  |  | Key is pressed for short time
 |  |  | While key is maintained - but until another key is pressed
 |  |  | While key is maintained
 |  |  | Key is pressed for long time
 |  |  | Key is "activated"
 | By default
 | A | B | C | D | R | F | G | H | I | J | K | L | M | N
1 | Escap |  |  |  |  |  |  |  |  |  |  |  |  | Del
2 | ² | 1 | 2 | 3 | 4 | 5 | 6 | 7 | 8 | 9 | 0 |  |  | Back space
3 | Tab | a | z | e | r | t | y | u | i | o | p |  |  | Return
4 | #&+ | q | s | d | f | g | h | j | k | l | m
5 | Shift |  | w | x | c | v | b | n | , | ; | : | . | Shift
6 | Ctrl | Fn | Win | Alt | Space |  |  |  |  | Alt Gr | Ctrl | ← | ↑ | →
7 |  |  |  |  |  |  |  |  |  |  |  |  | ↓
 | A | B | C | D | R | F | G | H | I | J | K | L | M | N |  |  | A | B | C | D | R | F | G | H | I | J | K | L | M | N
1 | Escap |  |  |  |  |  |  |  |  |  |  |  |  | Del |  | 1 | Escap |  |  |  |  |  |  |  |  |  |  |  |  | Del
2 | ² | 1 | 2 | 3 | 4 | 5 | 6 | 7 | 8 | 9 | 0 |  |  | Back space |  | 2 | ° | 1 | 2 | 3 | 4 | 5 | 6 | 7 | 8 | 9 | 0 | % | = | Back space
3 | Tab | a | z | e | r | t | y | u | i | o | p |  |  | Return | return | 3 | Tab | ' | " | ( | ) | { | } | [ | ] | < | > | + | - | Return
4 | #&+ | q | s | d | f | g | h | j | k | l | m |  |  |  | → | 4 | #&+ | & | # | @ | € | $ | £ | ¥ | ~ | ¨ | ^ | * | /
5 | Shift |  | w | x | c | v | b | n | , | ; | : | . | Shift |  | ← | 5 | Shift |  | \ | | | - | _ | ; | : | , | . | ? | ! | Shift
6 | Ctrl | Fn | Win | Alt | Space |  |  |  |  | Alt Gr | Ctrl | ← | ↑ | → |  | 6 | Ctrl | Fn | Win | Alt | Space |  |  |  |  | Alt Gr | Ctrl | ← | ↑ | →
7 |  |  |  |  |  |  |  |  |  |  |  |  | ↓ |  |  | 7 |  |  |  |  |  |  |  |  |  |  |  |  | ↓
 | A | B | C | D | R | F | G | H | I | J | K | L | M | N |  |  | A | B | C | D | R | F | G | H | I | J | K | L | M | N
1 | Escap |  |  |  |  |  |  |  |  |  |  |  |  | Del |  | 1 | Escap |  |  |  |  |  |  |  |  |  |  |  |  | Del
2 | ² | 1 | 2 | 3 | 4 | 5 | 6 | 7 | 8 | 9 | 0 |  |  | Back space |  | 2 | 3 | 1 | 2 | 3 | 4 | 5 | 6 | 7 | 8 | 9 | 0 |  |  | Back space
3 | Tab | a | z | e | r | t | y | u | i | o | p |  |  | Return | return | 3 | Tab | A | Z | E | R | T | Y | U | I | O | P |  |  | Return
4 | #&+ | q | s | d | f | g | h | j | k | l | m |  |  |  | → | 4 | #&+ | Q | S | D | F | G | H | J | K | L | M
5 | Shift |  | w | x | c | v | b | n | , | ; | : | . | Shift |  | ← | 5 | Shift |  | W | X | C | V | B | N | , | ; | : | . | Shift
6 | Ctrl | Fn | Win | Alt | Space |  |  |  |  | Alt Gr | Ctrl | ← | ↑ | → |  | 6 | Ctrl | Fn | Win | Alt | Space |  |  |  |  | Alt Gr | Ctrl | ← | ↑ | →
7 |  |  |  |  |  |  |  |  |  |  |  |  | ↓ |  |  | 7 |  |  |  |  |  |  |  |  |  |  |  |  | ↓

Sheet: Shortcuts
 | Option 1
 |  | A | B | C | D | R | F | G | H | I | J | K | L | M | N
 | 1 | Escap |  |  |  |  |  |  |  |  |  |  |  |  | Del
 |  |  | cancel | restore | lum - | lum + | son - | son + | play pause | micro on/off | screen record | screenshot | print | Wifi on/off
 | Option 2
 |  | A | B | C | D | R | F | G | H | I | J | K | L | M | N
 | 1 | Escap |  |  |  |  |  |  |  |  |  |  |  |  | Del
quick press |  |  | cancel | lum - | lum + | son - | son + | micro on/off | Camera On/off | Screen record | Screenshot | Print | Share | Wifi On/off
long press |  |  |  |  |  |  |  | Micro settings | Camera settings |  |  | Printer settings |  | Wifi settings
 | Option 3
 |  | A | B | C | D | R | F | G | H | I | J | K | L | M | N
 | 1 | Escap |  |  |  |  |  |  |  |  |  |  |  |  | Del
quick press |  |  | cancel | lum - | lum + | son - | son + | micro on/off | Camera On/off | Screenshot | Print | Share | Bluetooth | Wifi On/off
long press |  |  |  |  |  |  |  | Micro settings | Camera settings | Screenrecord | Printer settings |  | Bluetooth settings | Wifi settings
 | Option 4
 |  | A | B | C | D | R | F | G | H | I | J | K | L | M | N
 | 1 | Escap |  |  |  |  |  |  |  |  |  |  |  |  | Del
quick press |  |  | Night view | lum - | lum + | son - | son + | micro on/off | Camera On/off | Screenshot | Share screen | Bluetooth | Wifi On/off | Mode économie d'energie
long press |  |  | Dark mode |  |  |  |  | Micro settings | Camera settings | Screenrecord |  | Bluetooth settings | Wifi settings
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
