eSpark-Backup/yazid-boud-khlouf-oled-keyboard/Deliverables/Supporting Files/Custom_Keyboard.step

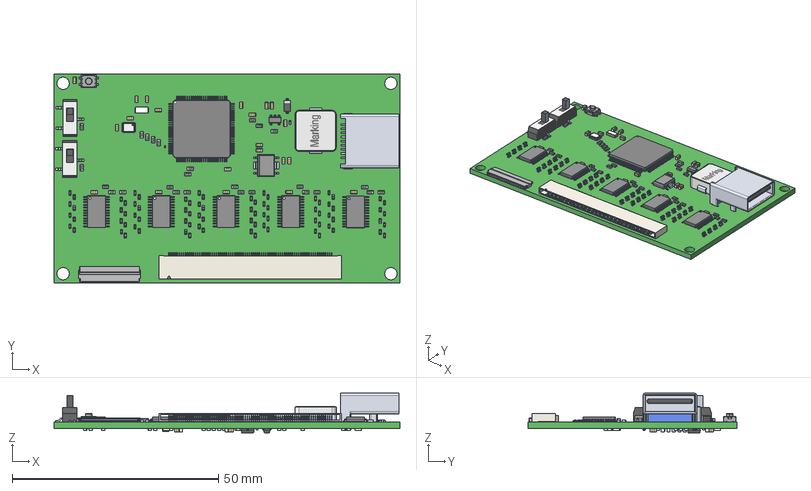
[picture p9: CAD file, 2022-07-15]
Deliverables/Supporting Files/Custom_Keyboard.step
83.9 x 50.6 x 9.63 mm
046288080000846+
User_Library-CAPC1608X09 x 32
ECS-.327-12.5-34B-C-TR--3DModel-STEP-40055
FH34SRJ-26S-0.5SH_RGB8421504
User_Library-RES_1005-0402 x 82
MetalFrame
Pin1Marker
Pin3
Pin1
Lid
Pin4
Pin2
Ceramic
User_Library-SOT-23-5-1
TCA9548APWR x 5
User_Library-LQFP100_05
User_Library-HSOP-6
ts-1185ec-c-d-b_RGB6710886
ss-3235d-03-l2 x 2
User_Library-RESC1608X05N x 51
User_Library-0201(0603M)_Res
CircuitWorks-SOT-23 x 2
base
pin
CircuitWorks-SOD123
User_Library-Capacitor_0402
