eSpark-Backup/yazid-boud-khlouf-oled-keyboard/Design-Files/Control Board/Custom_Keyboard.step

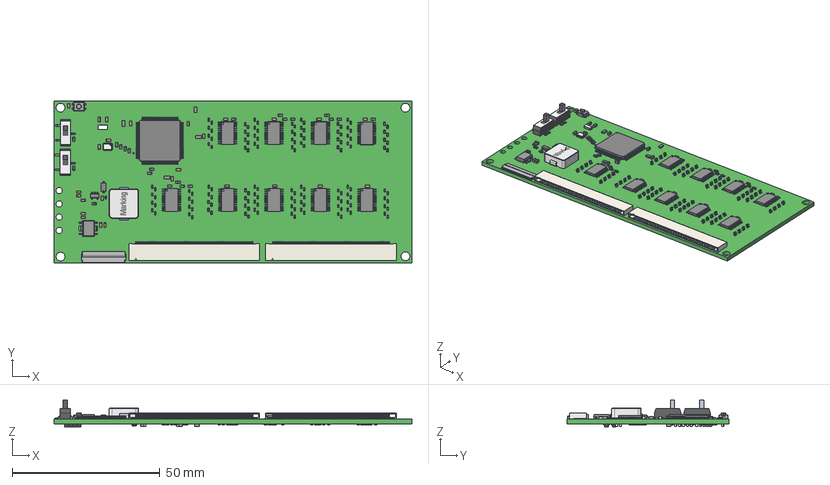
[picture p10: CAD file, 2022-11-07]
Design-Files/Control Board/Custom_Keyboard.step
121.1 x 54.7 x 9.05 mm
TCA9548APWR x 9
User_Library-CAPC1608X09 x 40
Pins x 4
User_Library-RES_1005-0402 x 146
User_Library-RESC1608X05N x 63
046288080000846+ x 2
FH34SRJ-26S-0.5SH_RGB8421504
ECS-.327-12.5-34B-C-TR--3DModel-STEP-40055
MetalFrame
Pin1Marker
Pin3
Pin1
Lid
Pin4
Pin2
Ceramic
User_Library-SOT-23-5-1
User_Library-LQFP100_05
User_Library-HSOP-6
ts-1185ec-c-d-b_RGB6710886
ss-3235d-03-l2 x 2
User_Library-0201(0603M)_Res
CircuitWorks-SOT-23 x 2
base
pin
SOD-123_STM
User_Library-Capacitor_0402
