eSpark-Backup/yazid-boud-khlouf-oled-keyboard/Design-Files/Flex Cables/Control_Flex_Cable (26-Pin)/Flex_26.step

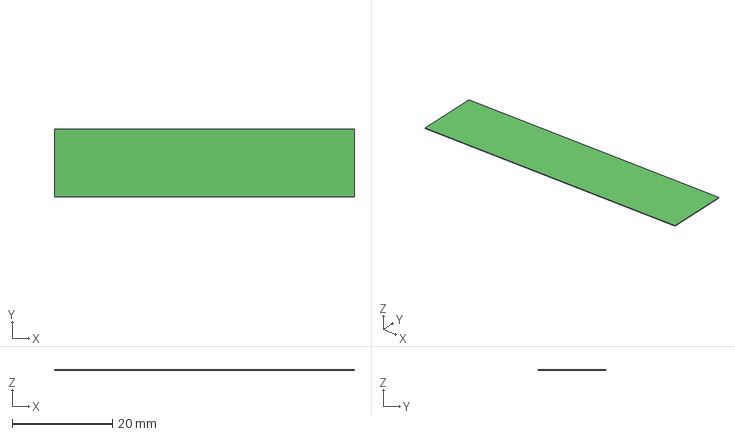
[picture p11: CAD file, 2022-10-26]
Design-Files/Flex Cables/Control_Flex_Cable (26-Pin)/Flex_26.step
60.0 x 13.5 x 0.116 mm
