eSpark-Backup/yazid-boud-khlouf-oled-keyboard/Design-Files/Flex Cables/Membrane_Flex_Cable (80-Pin)/Flex_80.step

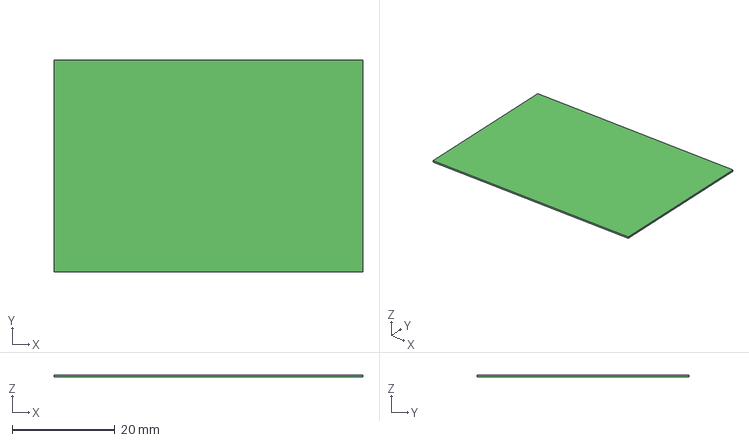
[picture p12: CAD file, 2022-10-26]
Design-Files/Flex Cables/Membrane_Flex_Cable (80-Pin)/Flex_80.step
60.0 x 41.2 x 0.411 mm
