eSpark-Backup/yazid-boud-khlouf-oled-keyboard/Design-Files/Flex Cables/OLED_Flex_Cable (6-Pin)/Flex_6.step

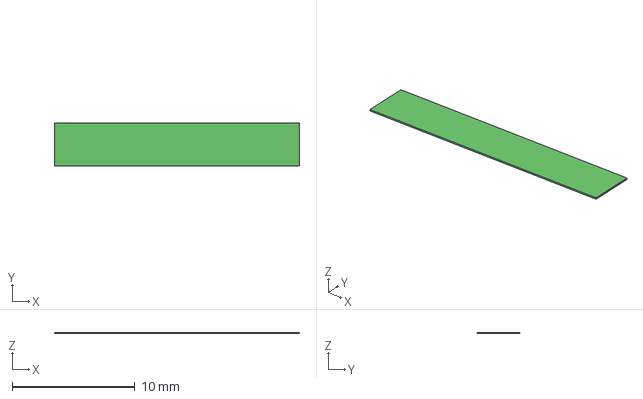
[picture p13: CAD file, 2022-10-26]
Design-Files/Flex Cables/OLED_Flex_Cable (6-Pin)/Flex_6.step
20.0 x 3.50 x 0.116 mm
