eSpark-Backup/yazid-boud-khlouf-oled-keyboard/Design-Files/Membrane_Board/Membrane_Board.step

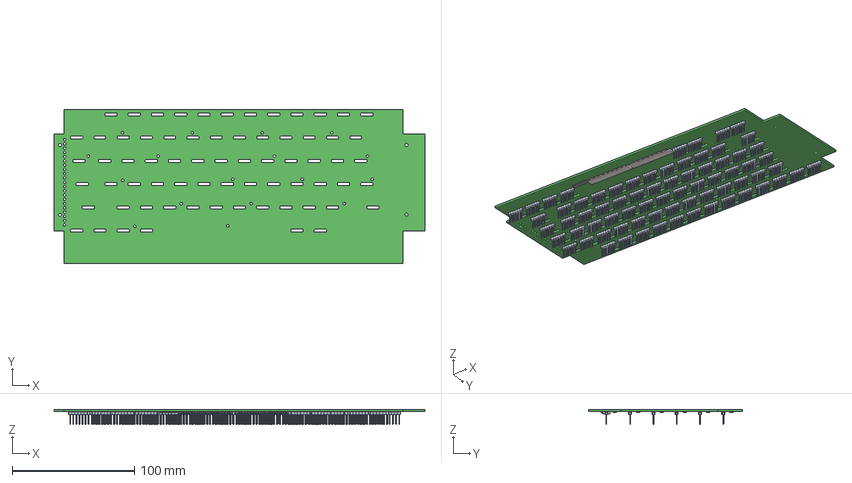
[picture p14: CAD file, 2022-11-07]
Design-Files/Membrane_Board/Membrane_Board.step
303.0 x 126.1 x 12.3 mm
s10129380-906002XLF x 72
046288080000846+ x 2
FH19C-6S-0.5SH_\X\8A\ÜH\X\97\Ü* x 72
FH34SRJ-26S-0.5SH_RGB8421504
