eSpark-Backup/yazid-boud-khlouf-oled-keyboard/Design-Files/Membrane_Board/Project Logs for Membrane_Board/Membrane_Board.step

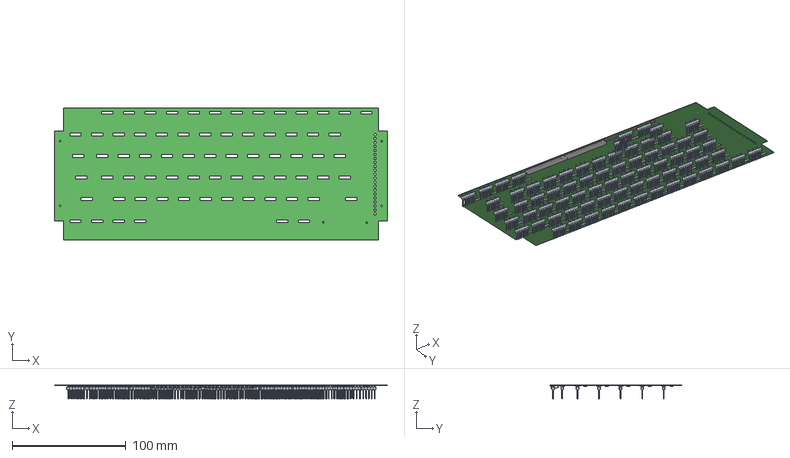
[picture p15: CAD file, 2022-08-18]
Design-Files/Membrane_Board/Project Logs for Membrane_Board/Membrane_Board.step
293.0 x 116.1 x 12.3 mm
s10129380-906002XLF x 72
FH19C-6S-0.5SH_\X\8A\ÜH\X\97\Ü* x 72
FH34SRJ-26S-0.5SH_RGB8421504
046288080000846+ x 2
