eSpark-Backup/yazid-boud-khlouf-oled-keyboard/Design-Files/OLED_PCB/OLED_PCB.step

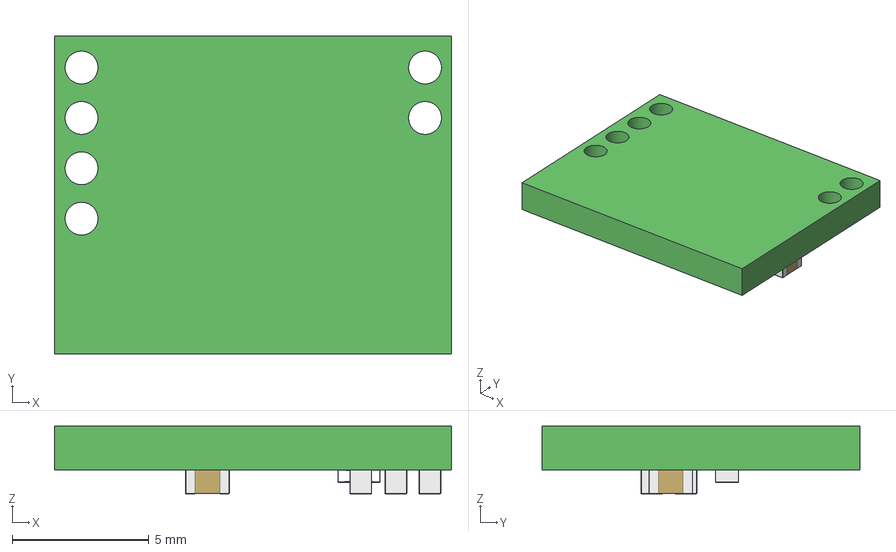
[picture p16: CAD file, 2022-10-11]
Design-Files/OLED_PCB/OLED_PCB.step
14.5 x 11.6 x 2.47 mm
User_Library-RESC1608X05N
User_Library-CAPC1608X09 x 5
