eSpark-Backup/yazid-boud-khlouf-oled-keyboard/Design-Files/USB Extension Board/USB_Extension.step

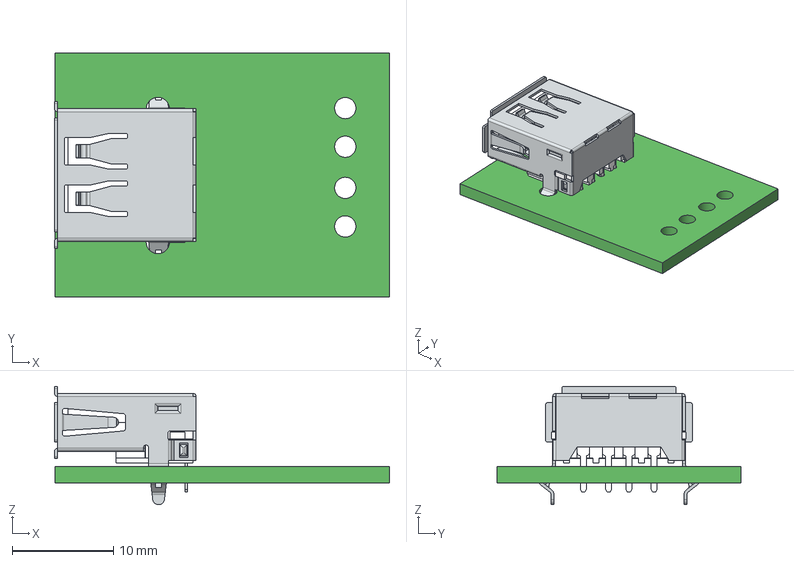
[picture p17: CAD file, 2022-10-11]
Design-Files/USB Extension Board/USB_Extension.step
33.1 x 24.1 x 11.7 mm
61400416021_Insulator
61400416021_Contact_Plating x 4
61400416021_Shielding
