eSpark-Backup/yazid-boud-khlouf-oled-keyboard/(list of files, cad)

Other CAD files:
Design-Files/Project Outputs for Custom_Keyboard/Custom_Keyboard.step
Deliverables/Supporting_Files/Custom_Keyboard.DWG
Deliverables/Supporting_Files/Custom_Keyboard.step
