eSpark-Backup/yazid-boud-khlouf-oled-keyboard/Deliverables/Schematics/Custom_Keyboard.pdf

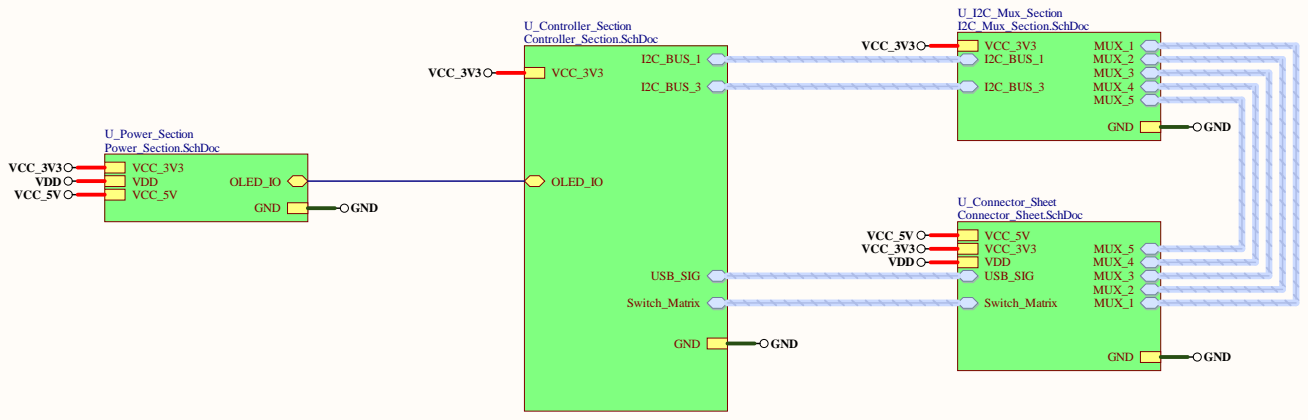
[picture p18: page 1]

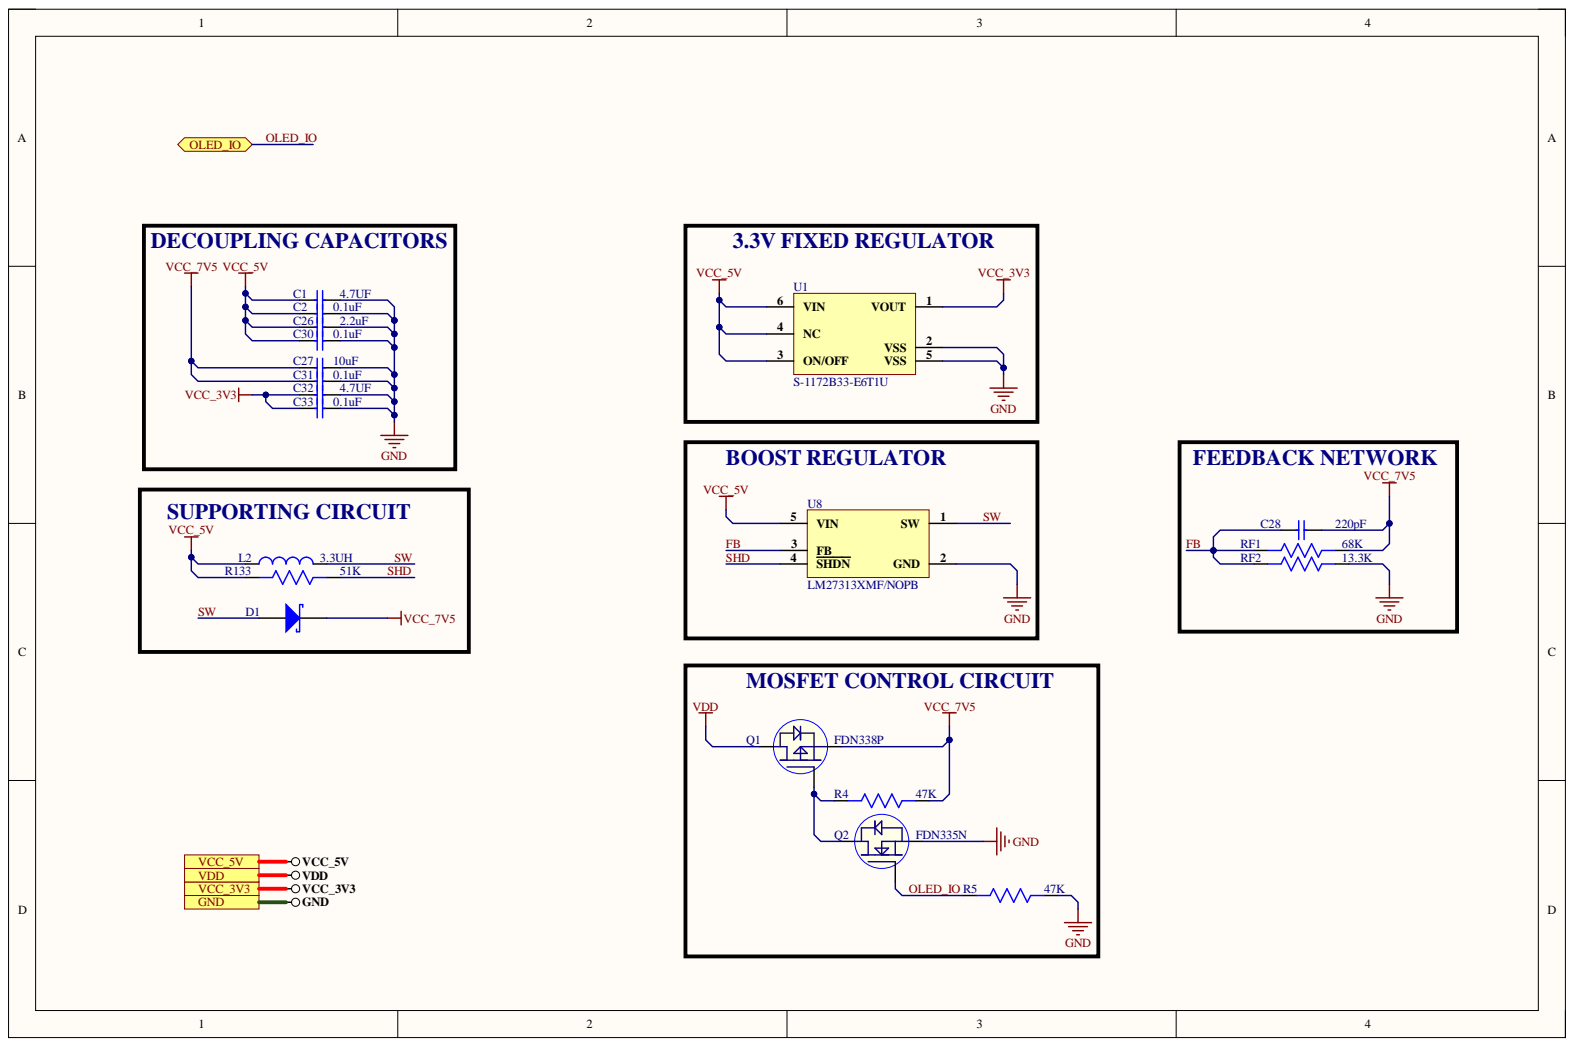
[picture p19: page 2]

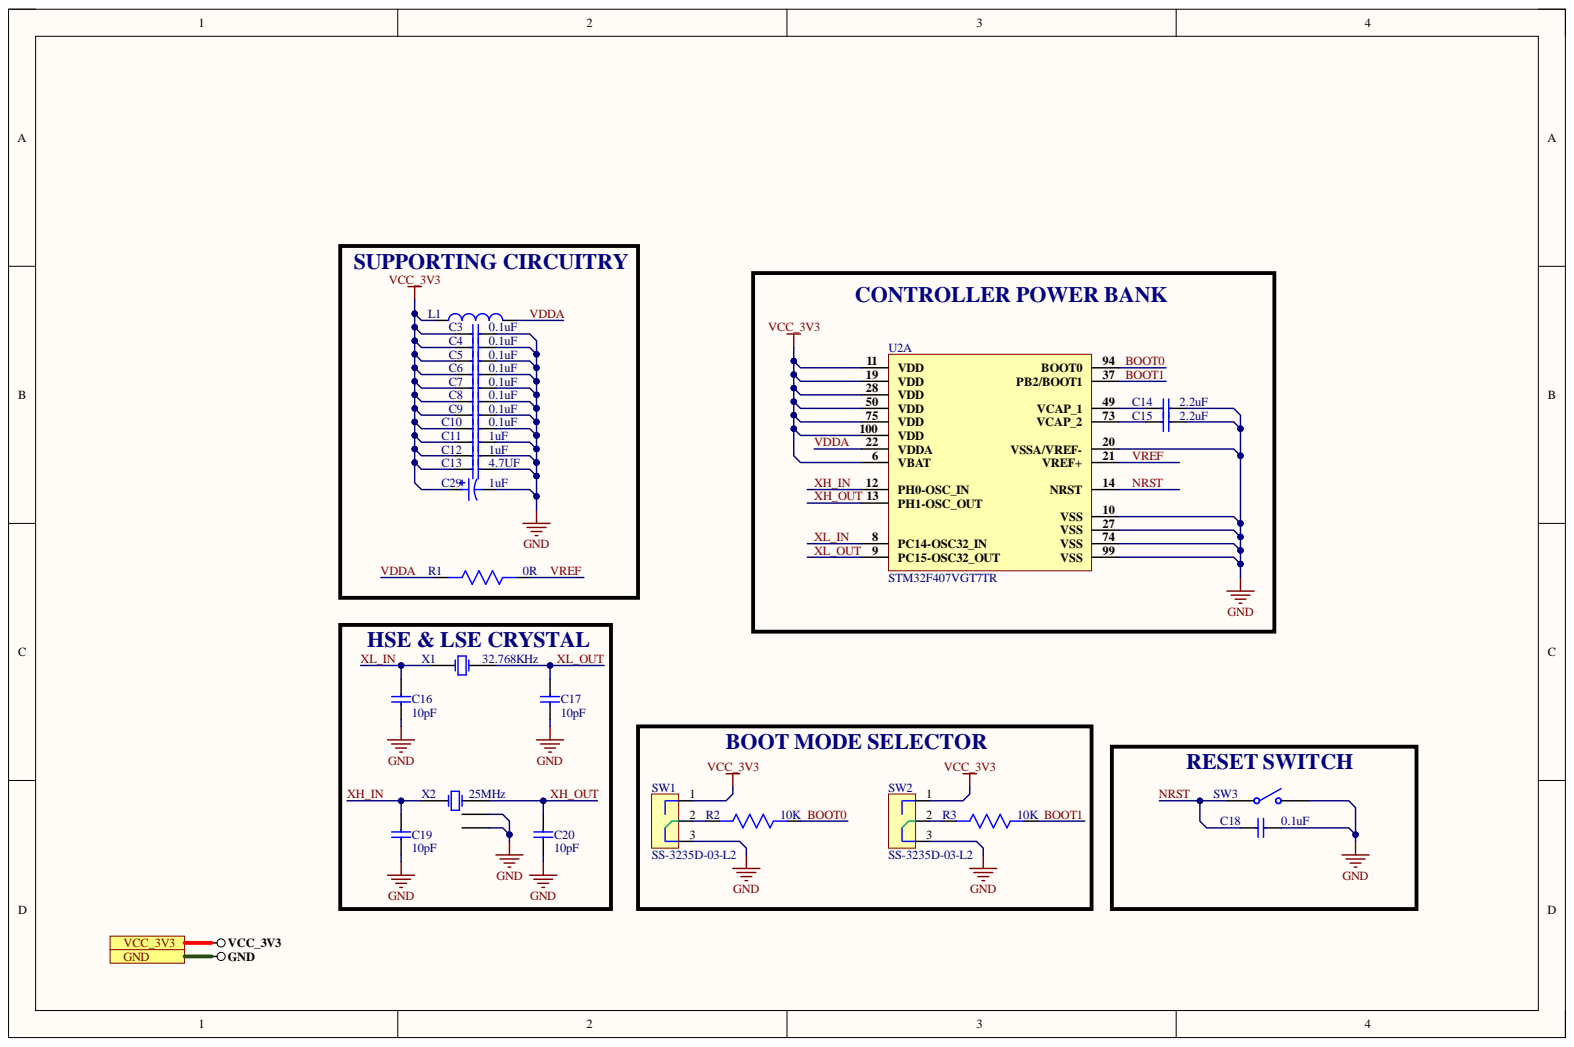
[picture p20: page 3]

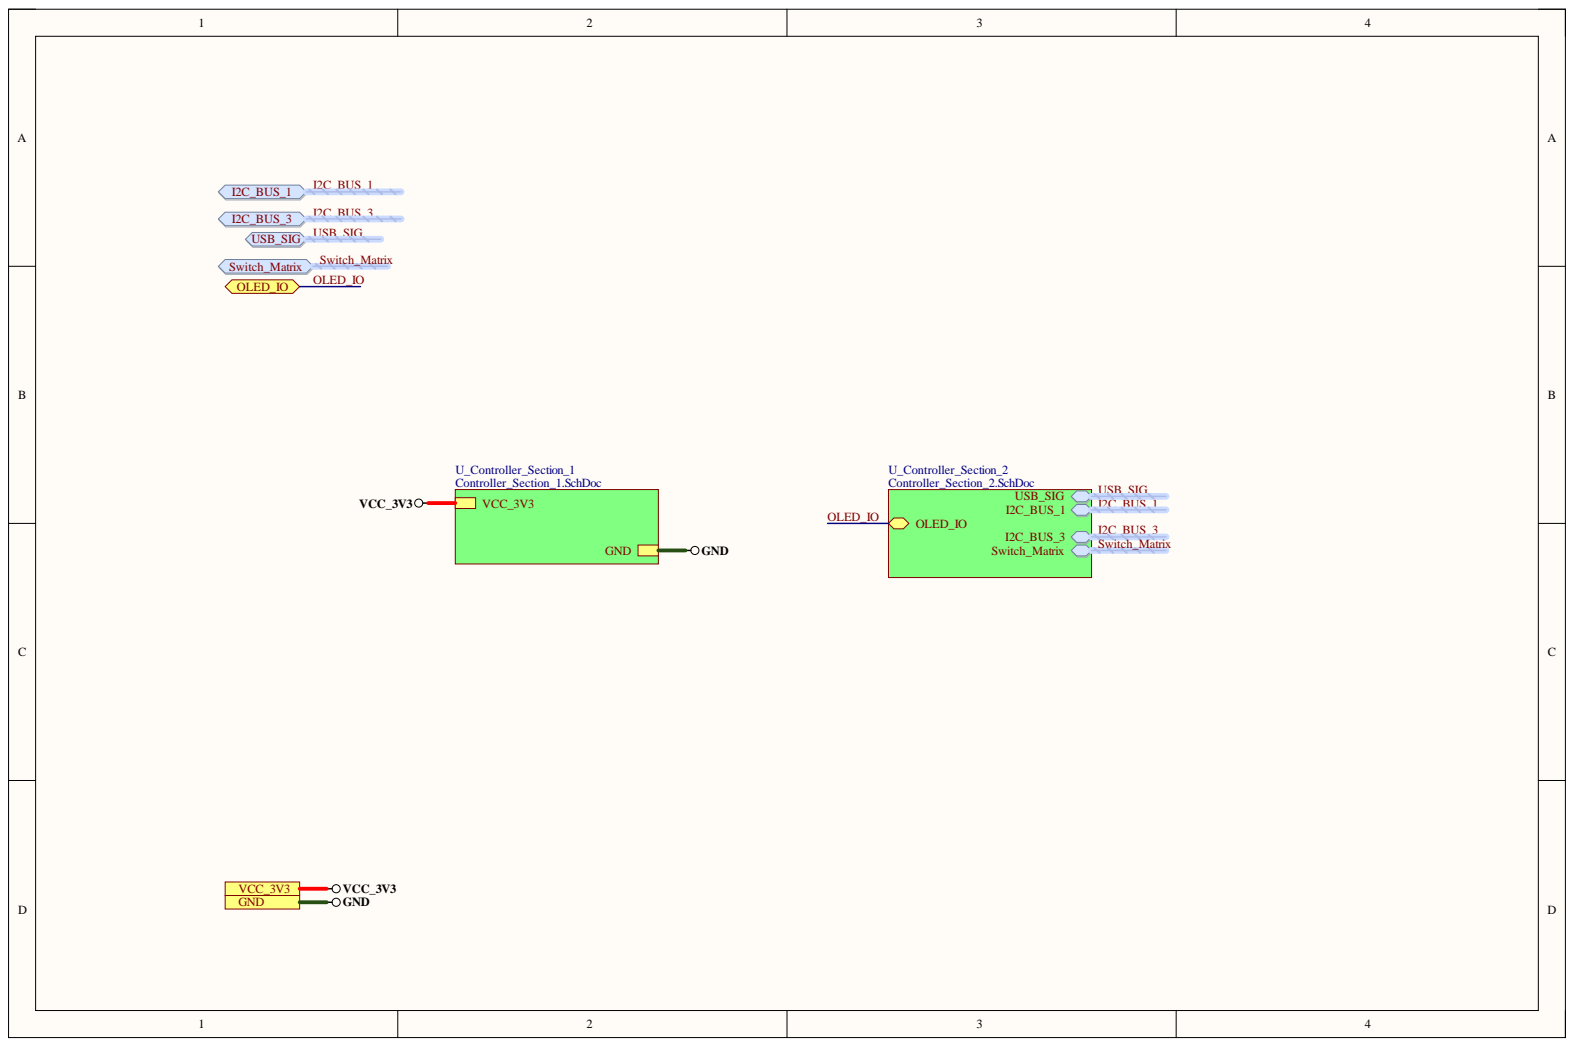
[picture p21: page 4]

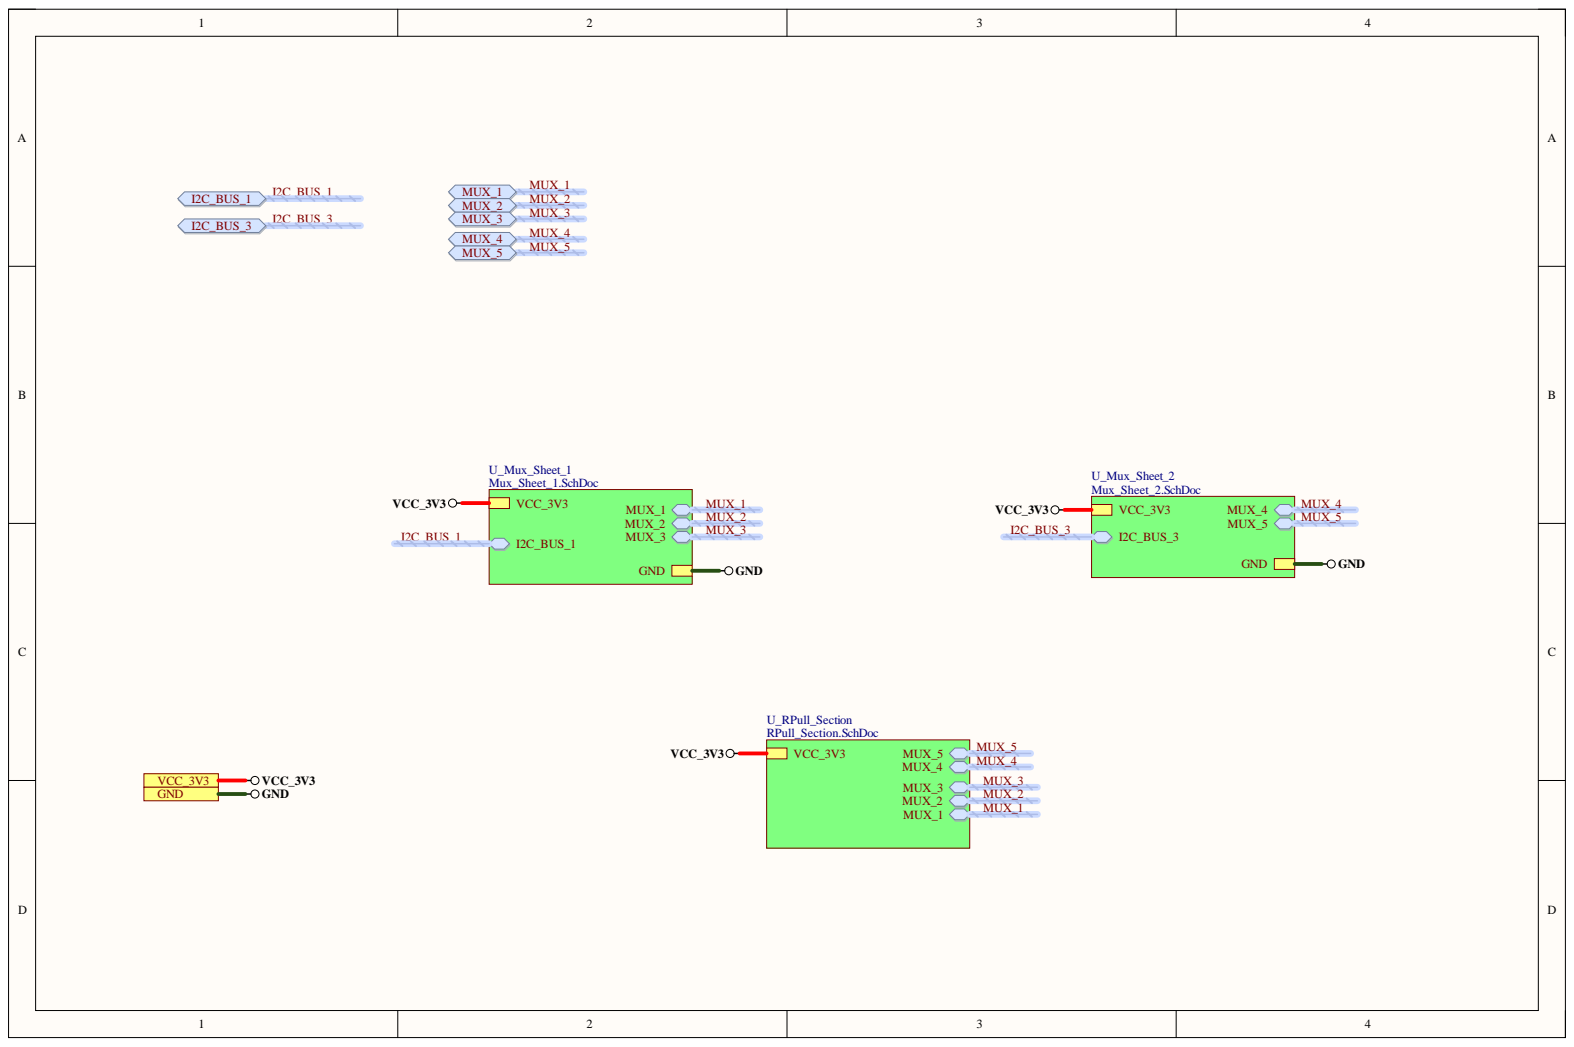
[picture p22: page 5]

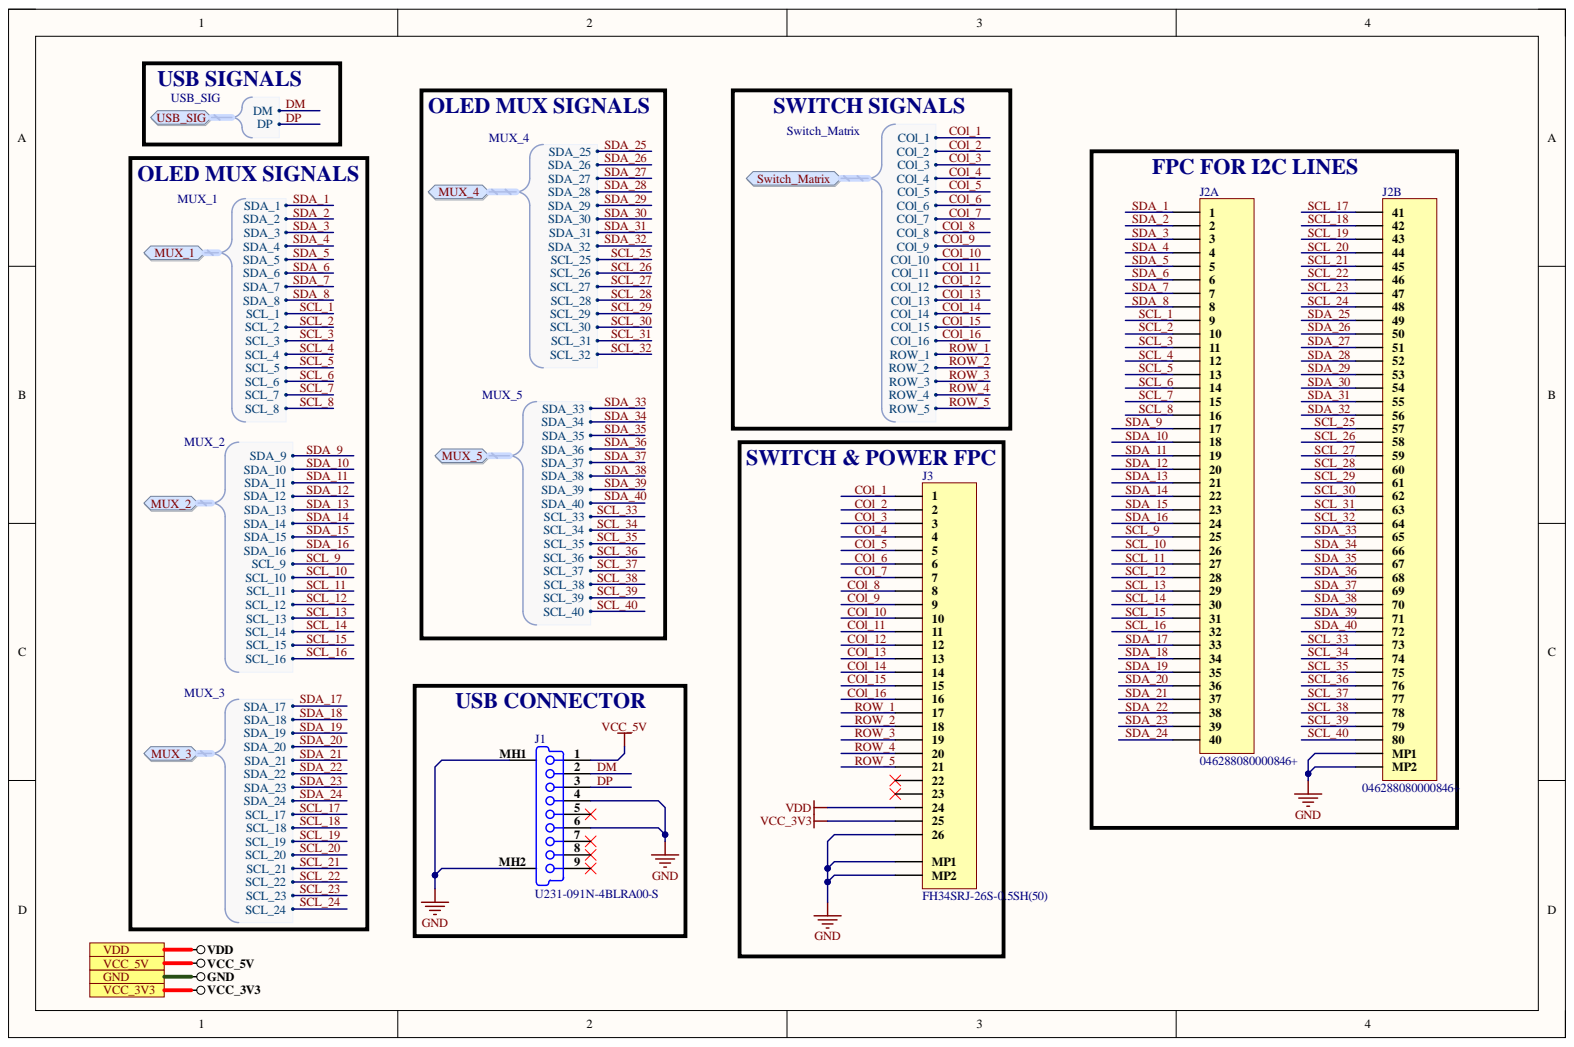
[picture p23: page 6]

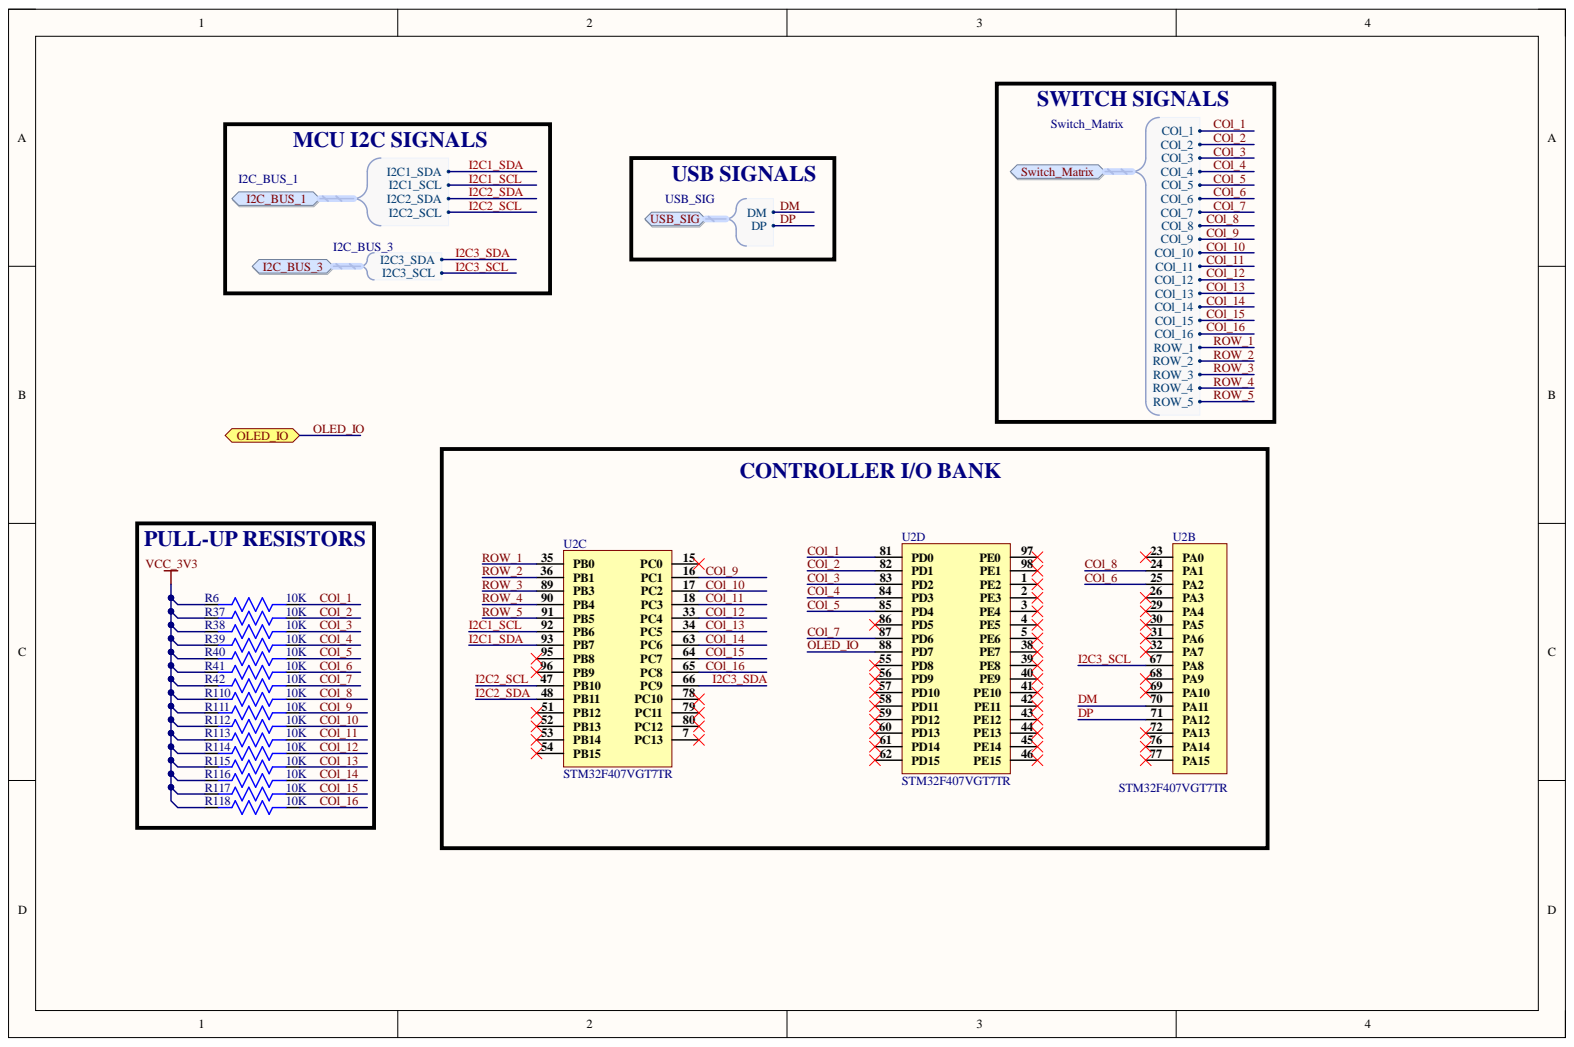
[picture p24: page 7]

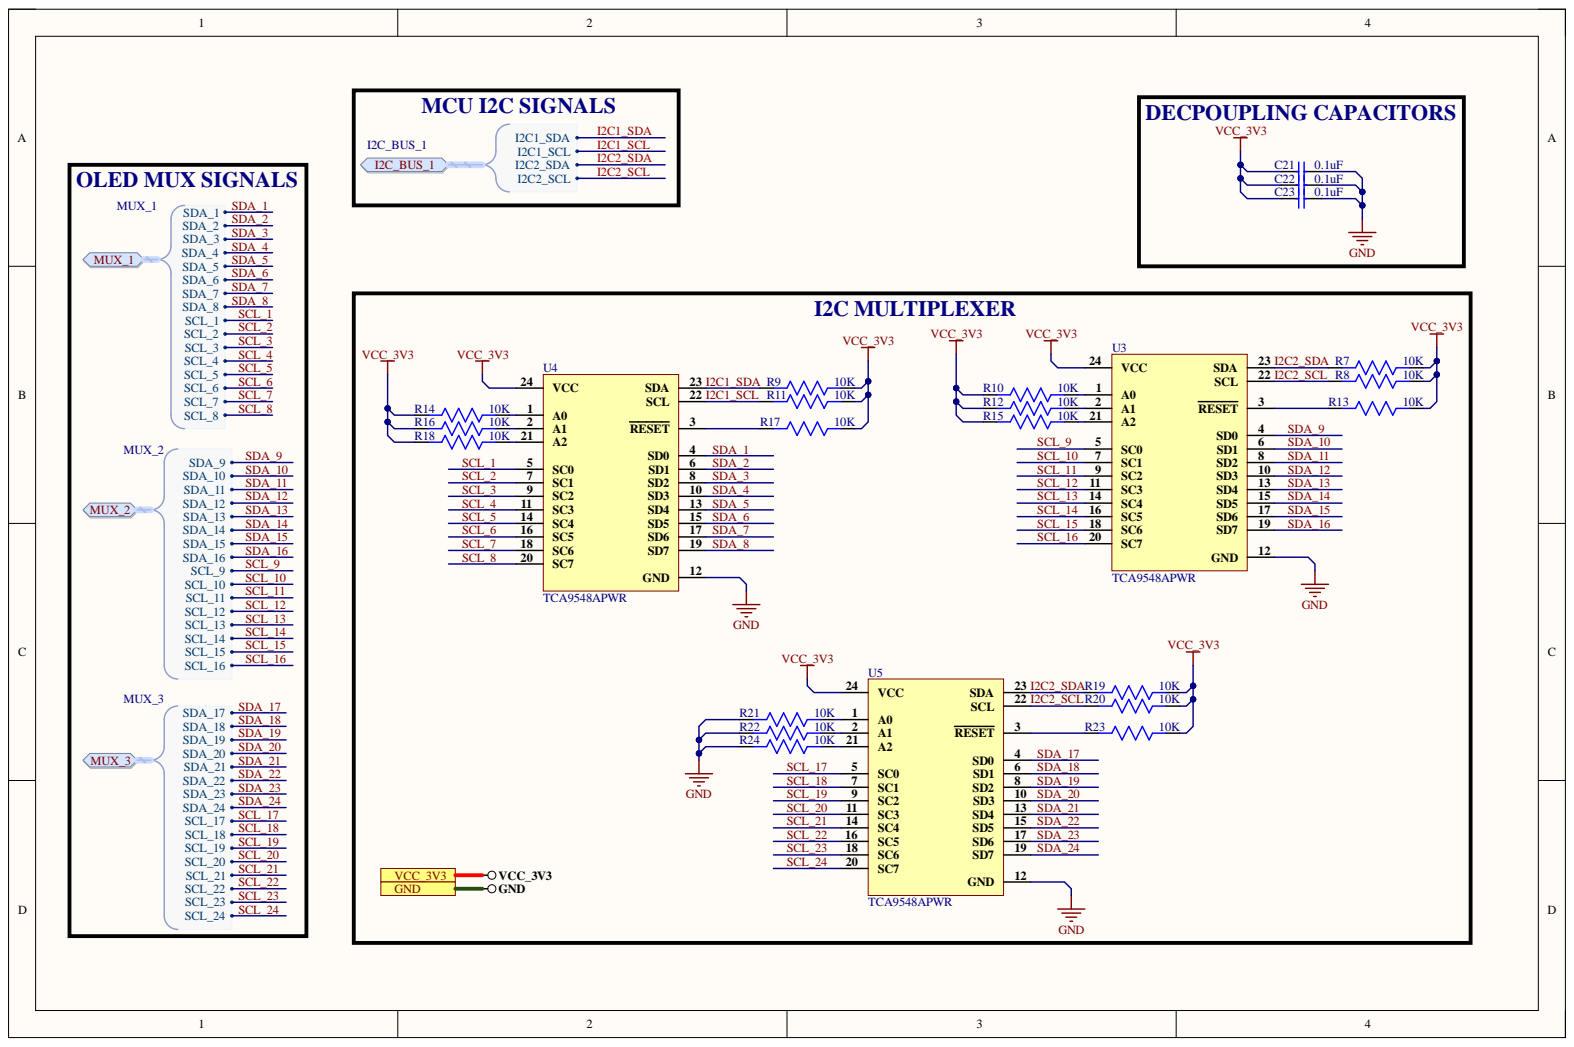
[picture p25: page 8]

MCU I2C SIGNALS I2C_BUS _ 1 | I2C1_S D A I2C2_S D A I2C2_S D A I2C2_S C L I2C2_S C L

DECPOUPLING CAPACITORS VC C_3 V 3 | GN D

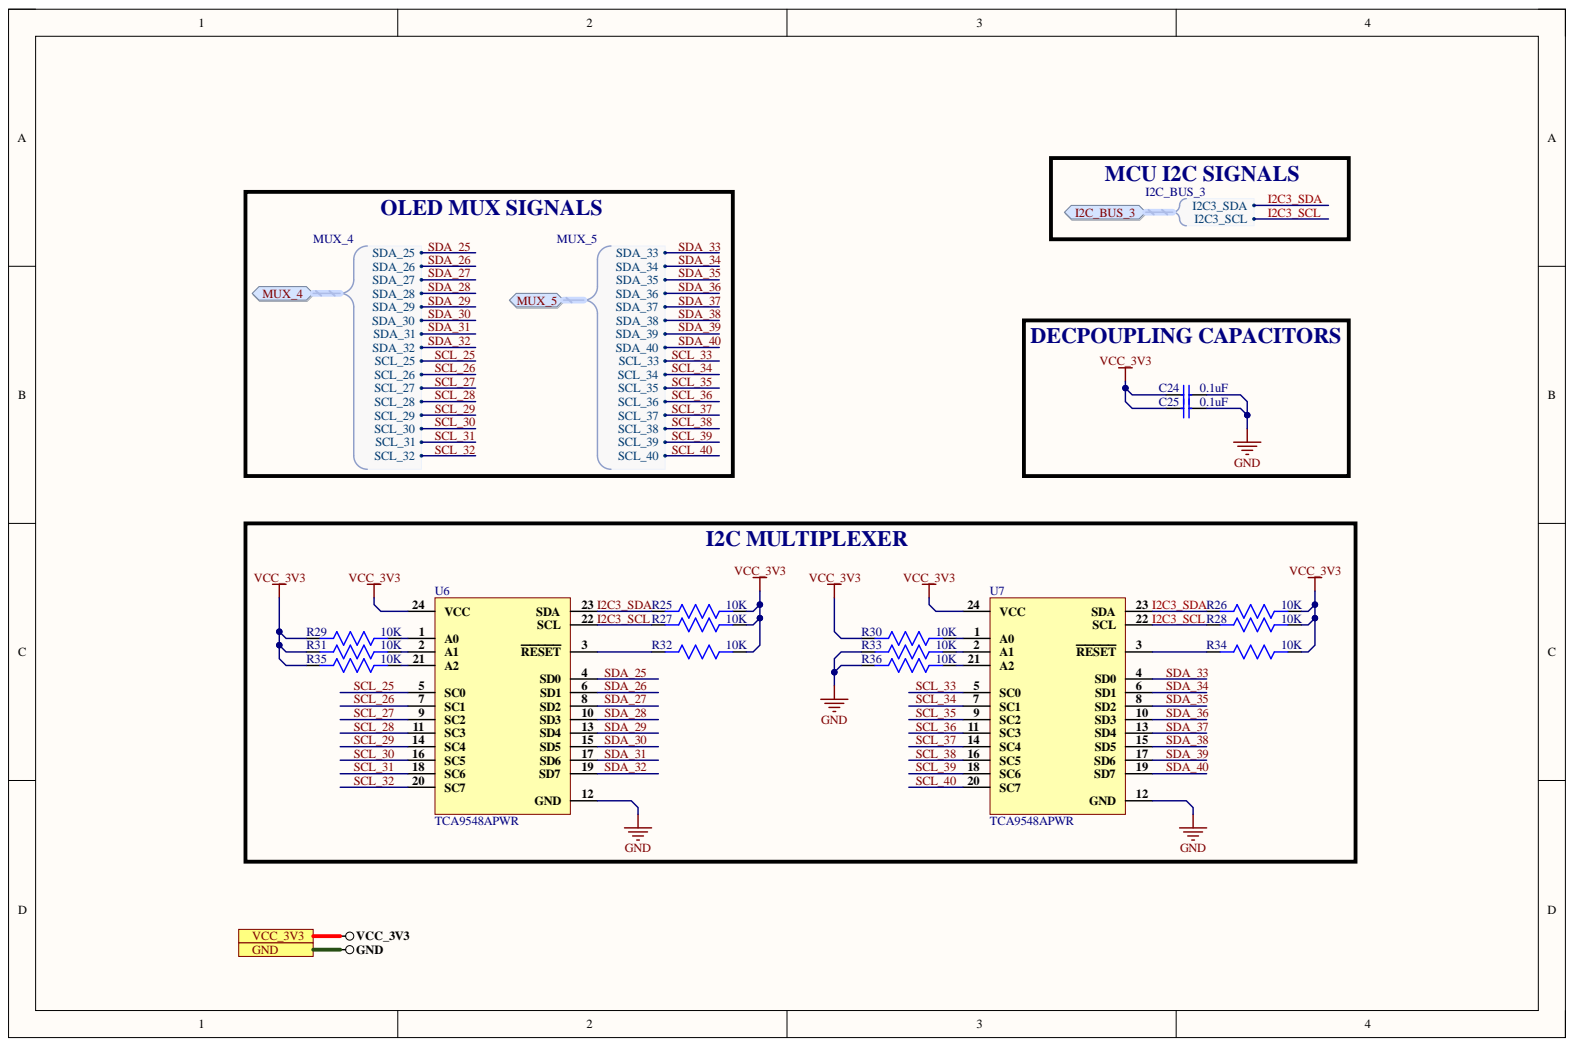
[picture p26: page 9]

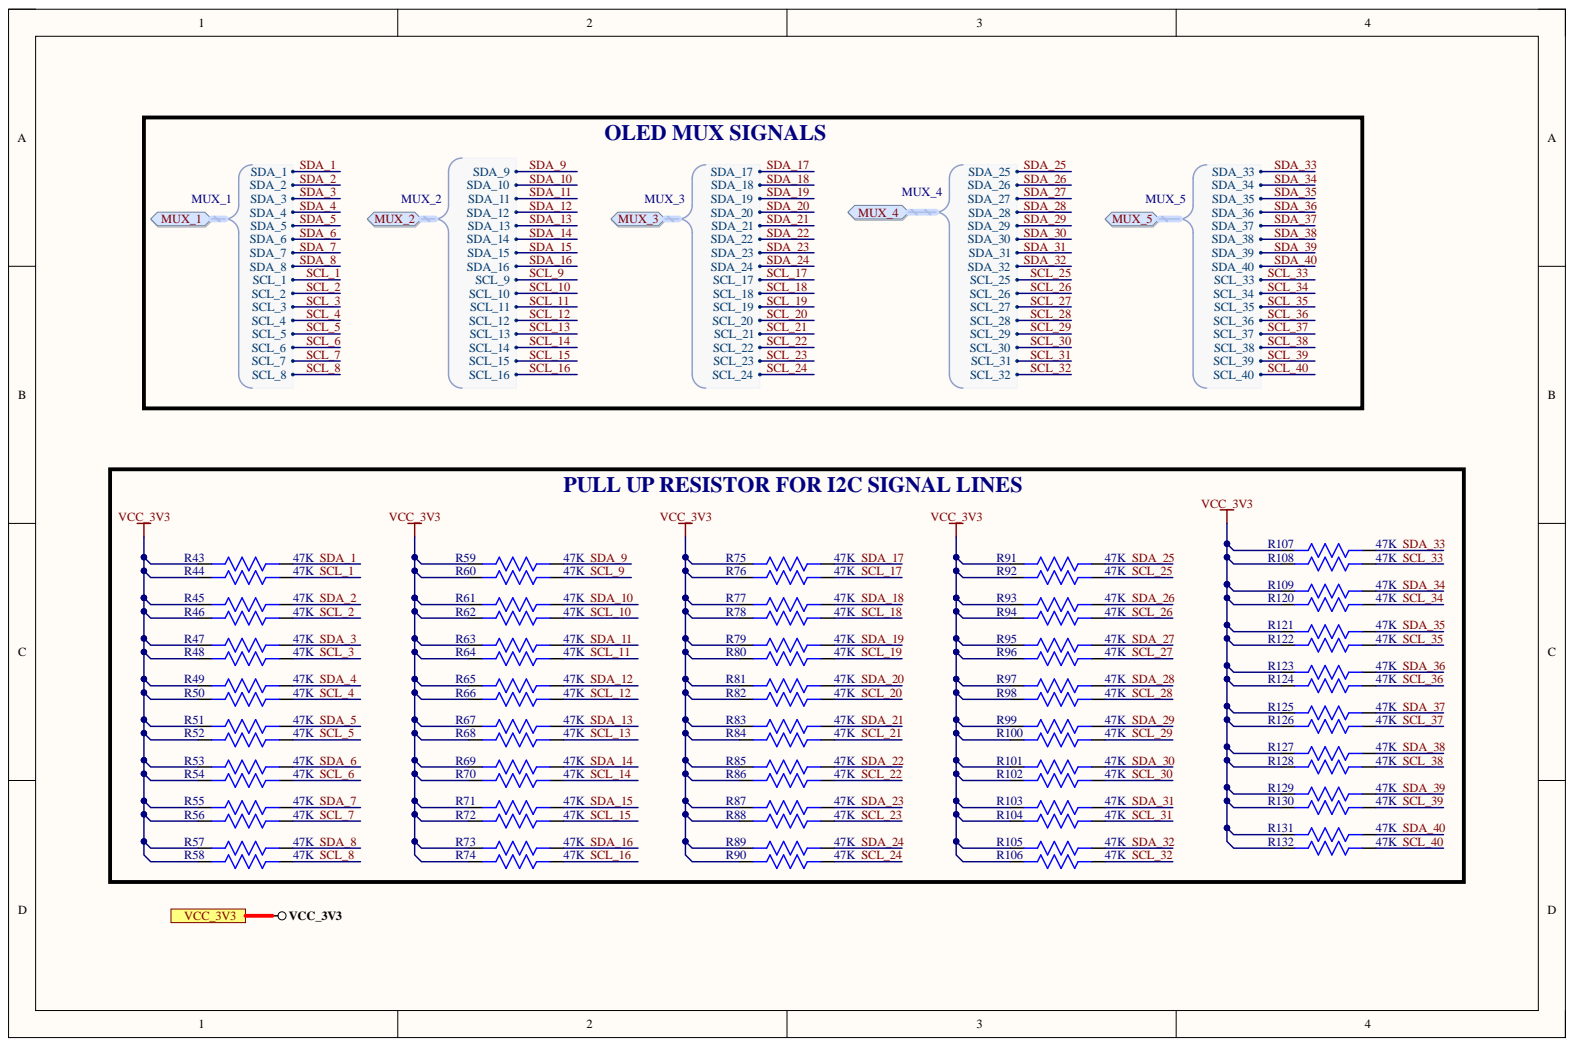
[picture p27: page 10]

PULL UP RESISTOR FOR I2C SIGNAL LINES

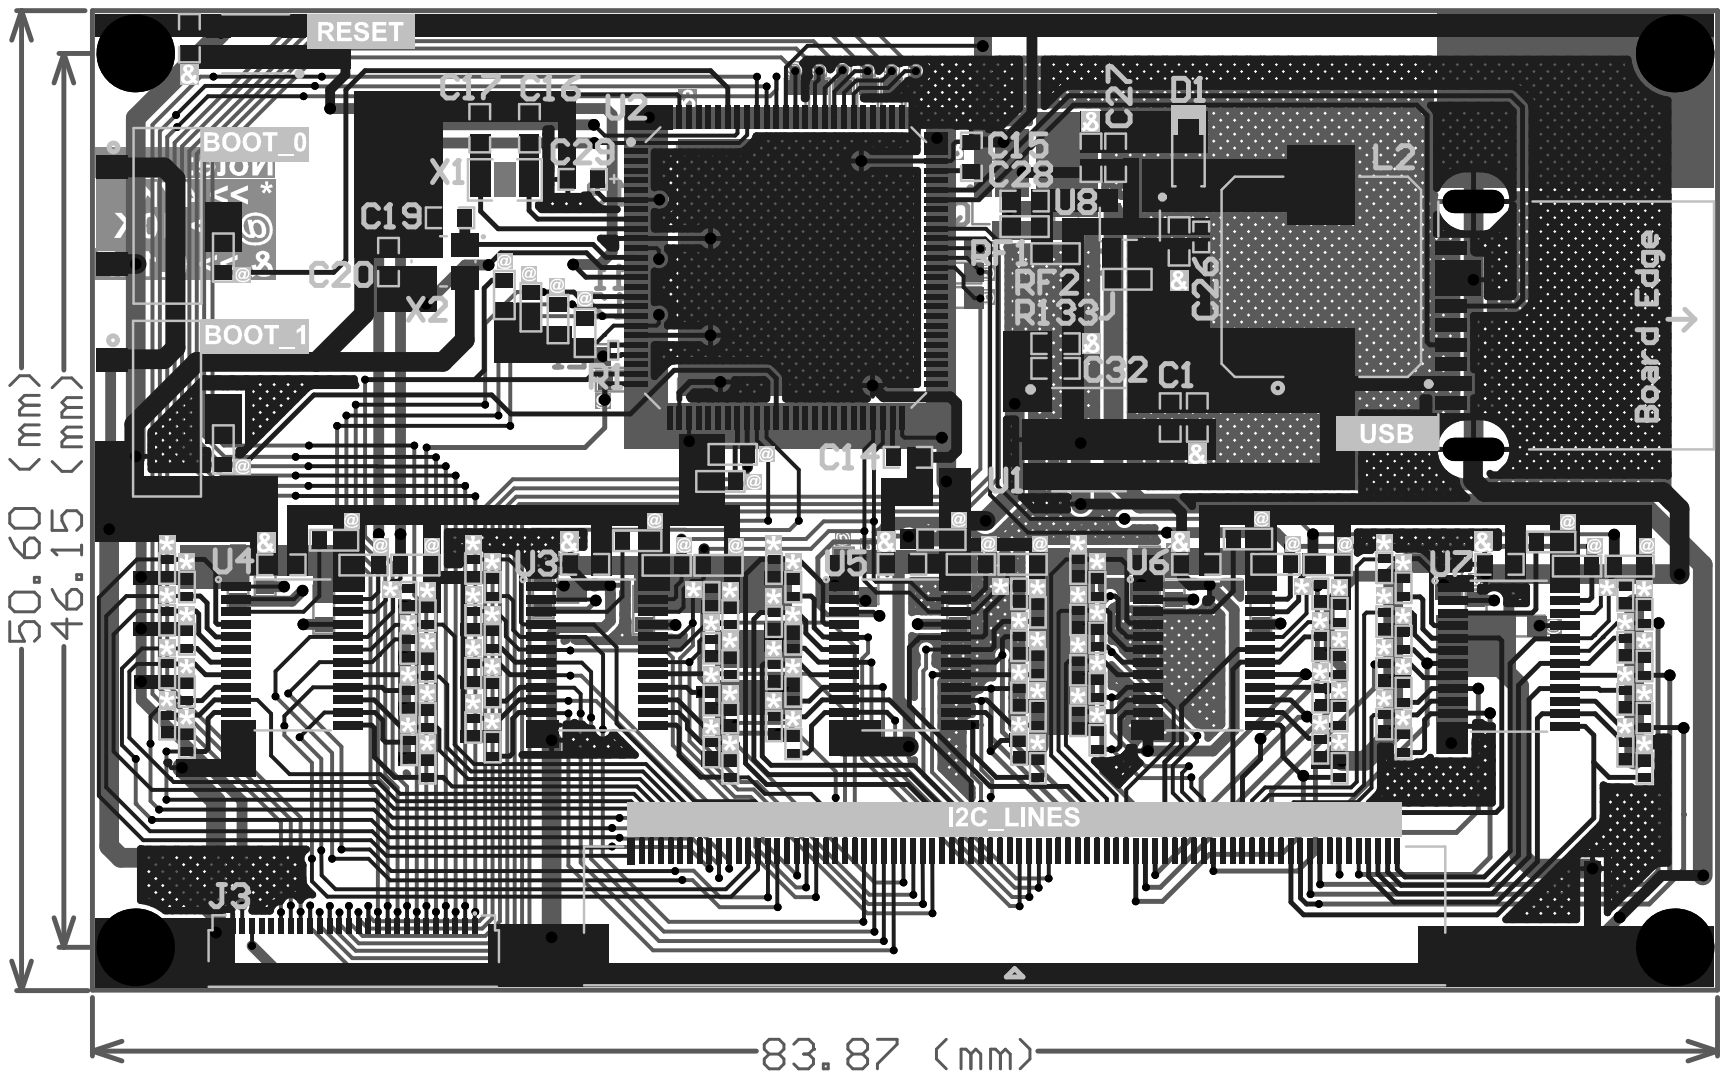
[picture p28: page 11]

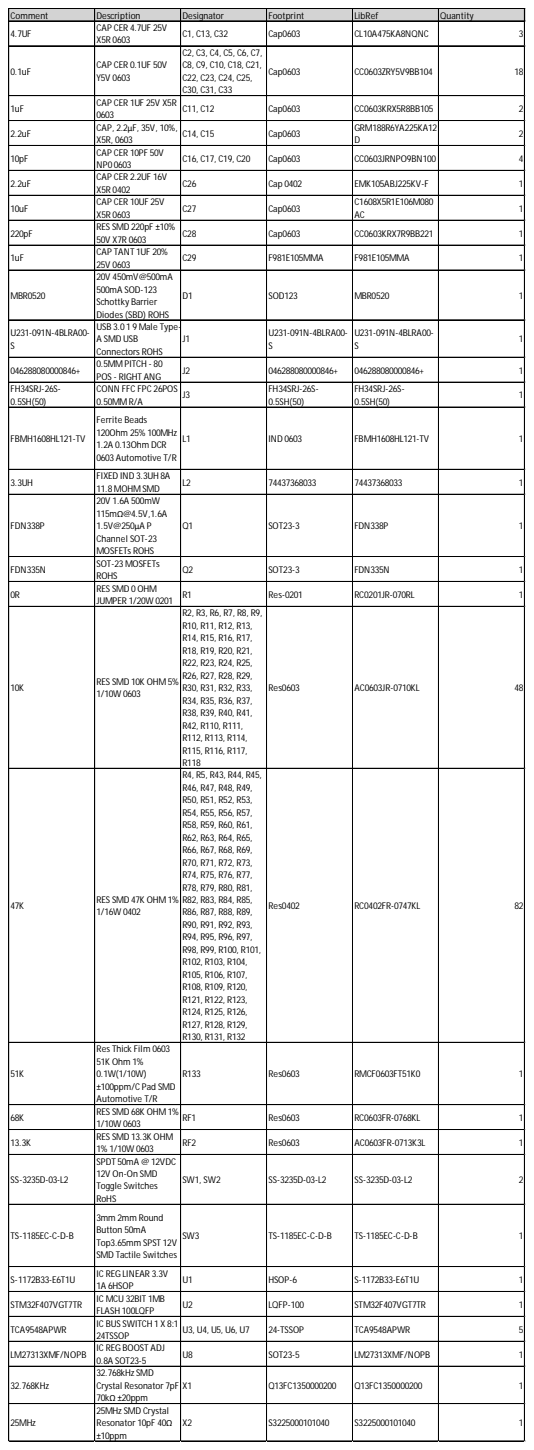
[picture p29: page 12]

Comment | Description | Designator | Footprint | LibRef | Quantity
4.7UF | CAP CER 4.7UF 25V X5R 0603 | C1, C13, C32 | Cap0603 | CL10A475KA8NQNC | 3

0.1uF | CAP CER 0.1UF 50V Y5V 0603 | C2, C3, C4, C5, C6, C7, C8, C9, C10, C18, C21, C22, C23, C24, C25, C30, C31, C33 | Cap0603 | CC0603ZRY5V9BB104 | 18

1uF | CAP CER 1UF 25V X5R 0603 | C11, C12 | Cap0603 | CC0603KRX5R8BB105 | 2

2.2uF | CAP, 2.2µF, 35V, 10%, X5R, 0603 | C14, C15 | Cap0603 | GRM188R6YA225KA12 D | 2

10pF | CAP CER 10PF 50V NP0 0603 | C16, C17, C19, C20 | Cap0603 | CC0603JRNPO9BN100 | 4

2.2uF | CAP CER 2.2UF 16V X5R 0402 | C26 | Cap 0402 | EMK105ABJ225KV-F | 1

10uF | CAP CER 10UF 25V X5R 0603 | C27 | Cap0603 | C1608X5R1E106M080 AC | 1

220pF | RES SMD 220pF ±10% 50V X7R 0603 | C28 | Cap0603 | CC0603KRX7R9BB221 | 1

1uF | CAP TANT 1UF 20% 25V 0603 | C29 | F981E105MMA | F981E105MMA | 1

MBR0520 | 20V 450mV@500mA 500mA SOD-123 Schottky Barrier Diodes (SBD) ROHS | D1 | SOD123 | MBR0520 | 1

U231-091N-4BLRA00-S | USB 3.0 1 9 Male Type-A SMD USB Connectors ROHS | J1 | U231-091N-4BLRA00-S | U231-091N-4BLRA00-S | 1

046288080000846+ | 0.5MM PITCH - 80 POS - RIGHT ANG | J2 | 046288080000846+ | 046288080000846+ | 1

FH34SRJ-26S-0.5SH(50) | CONN FFC FPC 26POS 0.50MM R/A | J3 | FH34SRJ-26S-0.5SH(50) | FH34SRJ-26S-0.5SH(50) | 1

FBMH1608HL121-TV | Ferrite Beads 120Ohm 25% 100MHz 1.2A 0.13Ohm DCR 0603 Automotive T/R | L1 | IND 0603 | FBMH1608HL121-TV | 1

3.3UH | FIXED IND 3.3UH 8A 11.8 MOHM SMD | L2 | 74437368033 | 74437368033 | 1

FDN338P | 20V 1.6A 500mW 115mΩ@4.5V,1.6A 1.5V@250μA P Channel SOT-23 MOSFETs ROHS | Q1 | SOT23-3 | FDN338P | 1

FDN335N | SOT-23 MOSFETs ROHS | Q2 | SOT23-3 | FDN335N | 1

0R | RES SMD 0OHM JUMPER 1/20W 0201 | R1 | Res-0201 | RC0201JR-070RL | 1

10K | RES SMD 10K OHM 5% 1/10W 0603 | R2, R3, R6, R7, R8, R9, R10, R11, R12, R13, R14, R15, R16, R17, R18, R19, R20, R21, R22, R23, R24, R25, R26, R27, R28, R29, R30, R31, R32, R33, R34, R35, R36, R37, R38, R39, R40, R41, R42, R110, R111, R112, R113, R114, R115, R116, R117, R118 | Res0603 | AC0603JR-0710KL | 48

47K | RES SMD 47K OHM 1% 1/16W 0402 | R4, R5, R43, R44, R45, R46, R47, R48, R49, R50, R51, R52, R53, R54, R55, R56, R57, R58, R59, R60, R61, R62, R63, R64, R65, R66, R67, R68, R69, R70, R71, R72, R73, R74, R75, R76, R77, R78, R79, R80, R81, R82, R83, R84, R85, R86, R87, R88, R89, R90, R91, R92, R93, R94, R95, R96, R97, R98, R99, R100, R101, R102, R103, R104, R105, R106, R107, R108, R109, R120, R121, R122, R123, R124, R125, R126, R127, R128, R129, R130, R131, R132 | Res0402 | RC0402FR-0747KL | 82

51K | Res Thick Film 0603 51K Ohm 1% 0.1W(1/10W) ±100ppm/C Pad SMD Automotive T/R | R133 | Res0603 | RMCF0603FT51K0 | 1

68K | RES SMD 68K OHM 1% 1/10W 0603 | RF1 | Res0603 | RC0603FR-0768KL | 1

13.3K | RES SMD 13.3K OHM 1% 1/10W 0603 | RF2 | Res0603 | AC0603FR-0713K3L | 1

SS-3235D-03-L2 | SPDT 50mA @ 12VDC 12V On-On SMD Toggle Switches RoHS | SW1, SW2 | SS-3235D-03-L2 | SS-3235D-03-L2 | 2

TS-1185EC-C-D-B | 3mm 2mm Round Button 50mA Top3.65mm SPST 12V SMD Tactile Switches | SW3 | TS-1185EC-C-D-B | TS-1185EC-C-D-B | 1

S-1172B33-E6T1U | IC REG LINEAR 3.3V 1A 6HSOP | U1 | HSOP-6 | S-1172B33-E6T1U | 1

STM32F407VGT7TR | IC MCU 32BIT 1MB FLASH 100LQFP | U2 | LQFP-100 | STM32F407VGT7TR | 1

TCA9548APWR | IC BUS SWITCH 1 X 8:1 24TSSOP | U3, U4, U5, U6, U7 | 24-TSSOP | TCA9548APWR | 5

LM27313XMF/NOPB | IC REG BOOST ADJ 0.8A SOT23-5 | U8 | SOT23-5 | LM27313XMF/NOPB | 1

32.768KHz | 32.768kHz SMD Crystal Resonator 7pF 70kΩ ±20ppm | X1 | Q13FC1350000200 | Q13FC1350000200 | 1

25MHz | 25MHz SMD Crystal Resonator 10pF 40Ω ±10ppm | X2 | S3225000101040 | S3225000101040 | 1
