eSpark-Backup/yazid-boud-khlouf-oled-keyboard/Design-Files/Membrane_Board/Membrane_Board.pdf

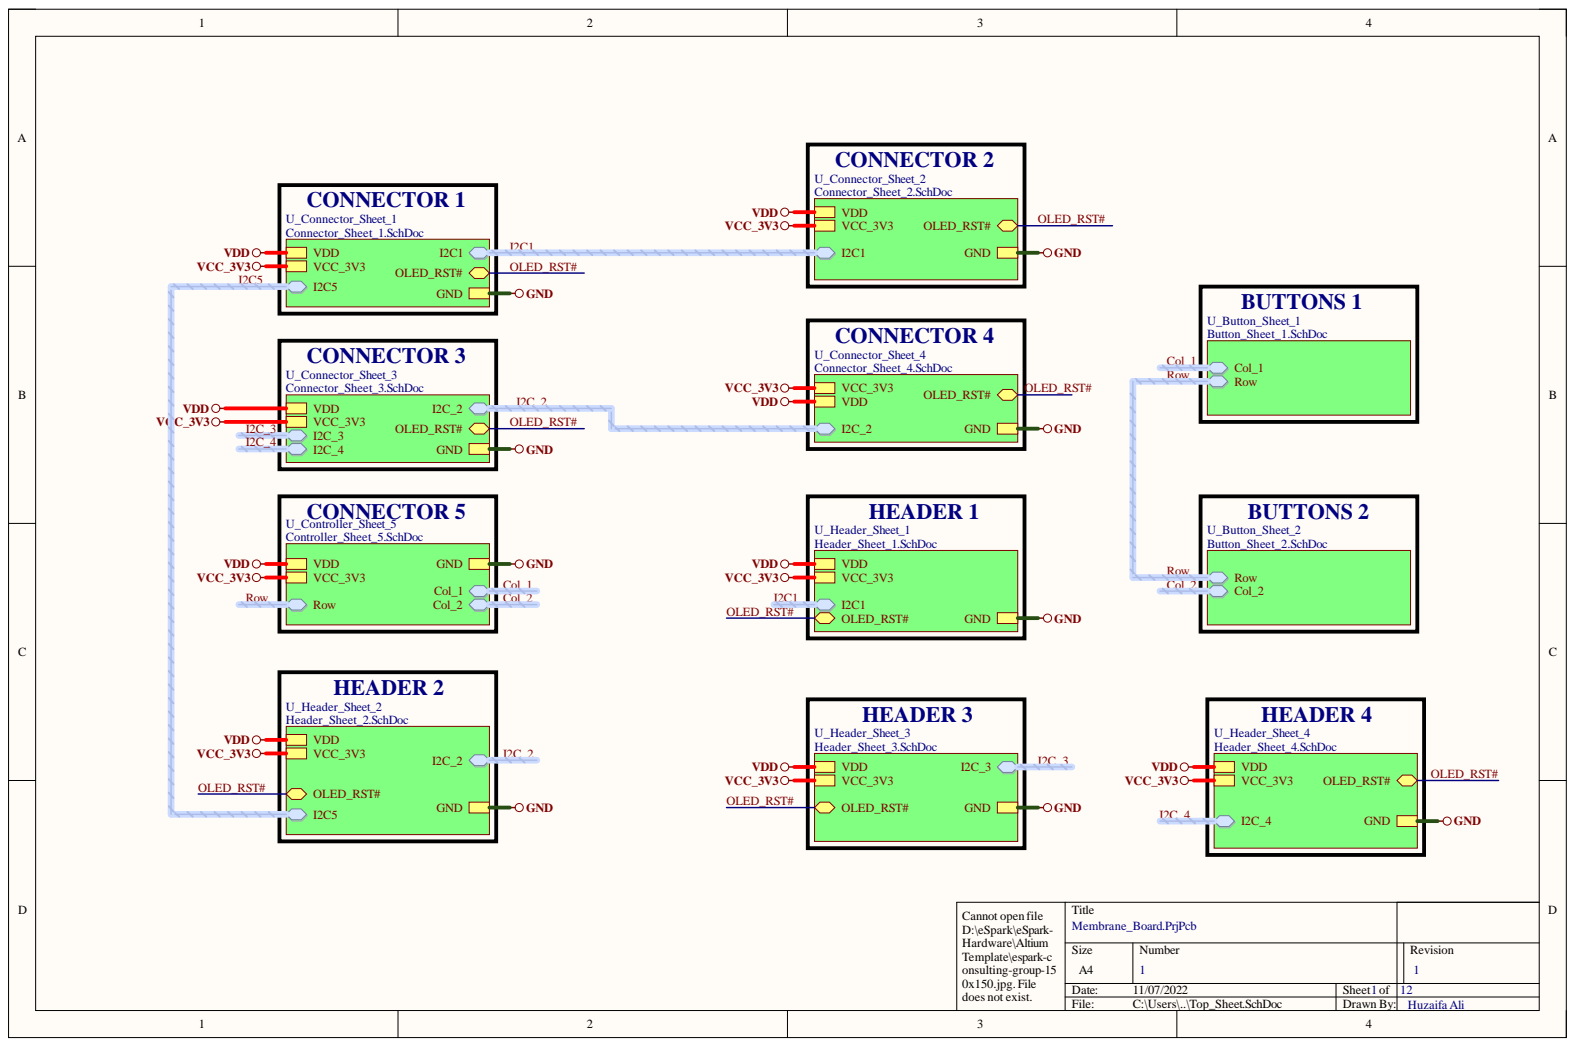
[picture p30: page 1]

Cannot open file D:\eSpark\eSpark-Hardware\Altium Template\espark-c onsulting-group-15 0x150.jpg. File does not exist. | Title Membrane_Board.PrjPcb

Size A4 | Number 1 | Revision 1

Date: 11/07/2022 | Sheet of 1 | 12
File: C:\Users\..\Top_Sheet.SchDoc | Drawn By: | Huzaifa Ali

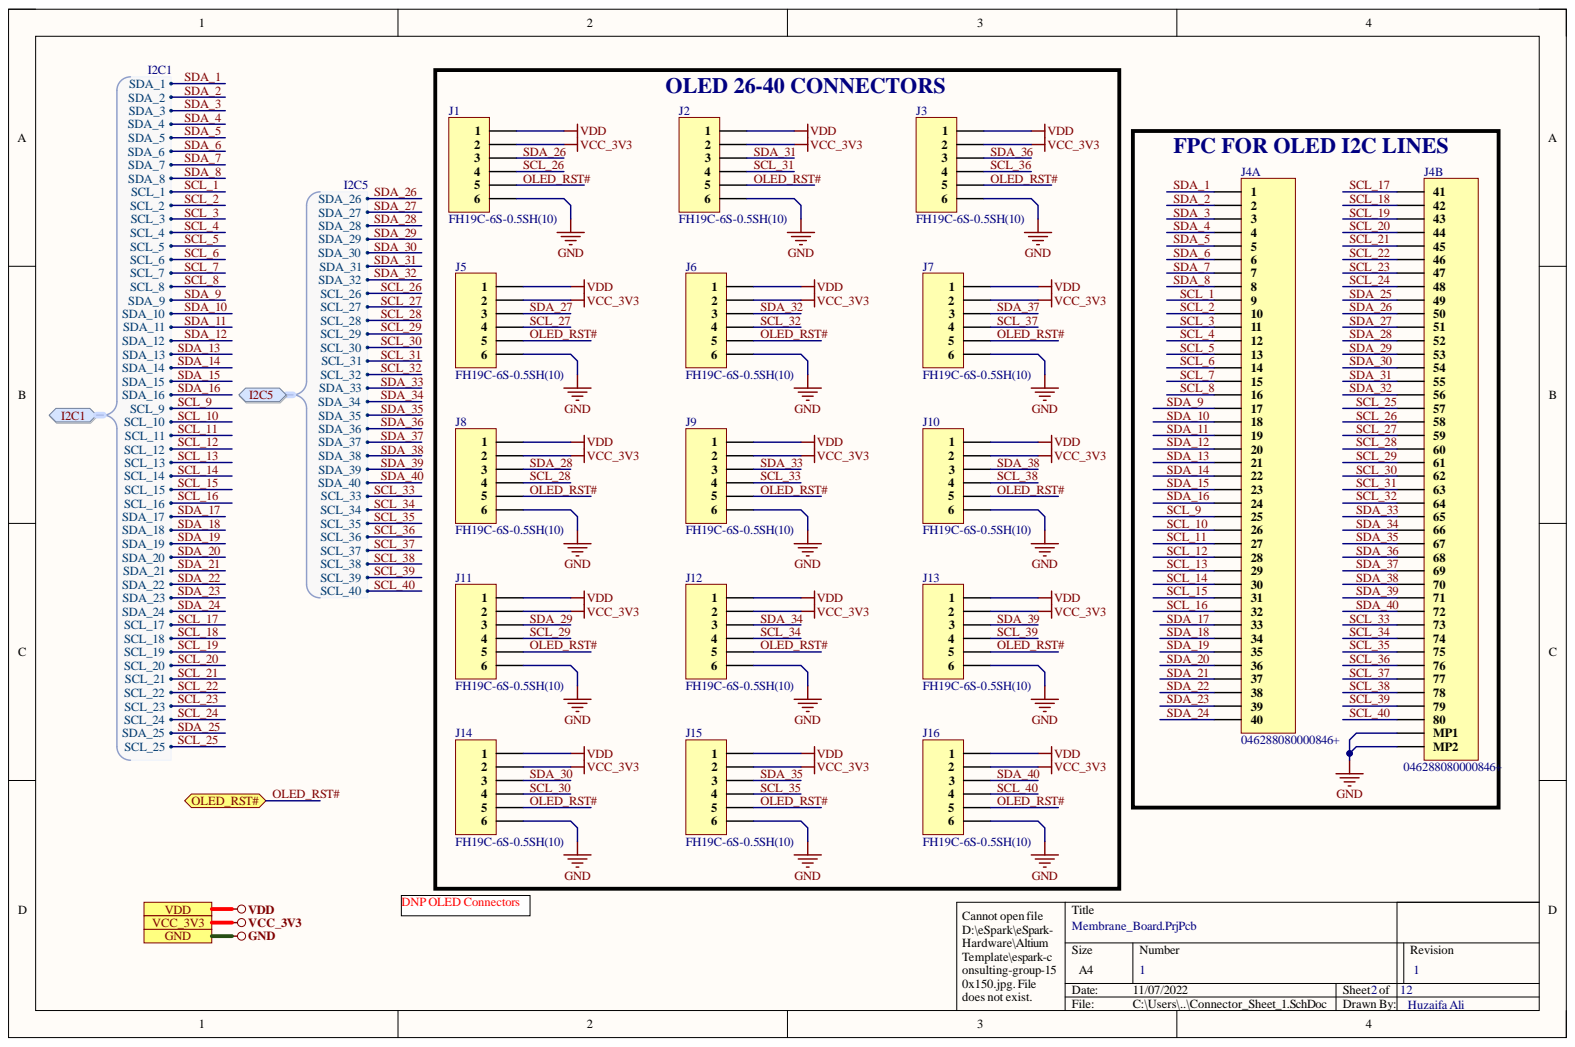
[picture p31: page 2]

FPC FOR OLED I2C LINES

Siz e A4 | Numb e r 1 | R evisio n 1

Da te : 11/07/20 2 2 | She et of 2 | 12
File : C:\Use rs\. .\Conne ctor_She e t_ 1 . S c hD o c | Dr awn B y | : Huz aifa A li

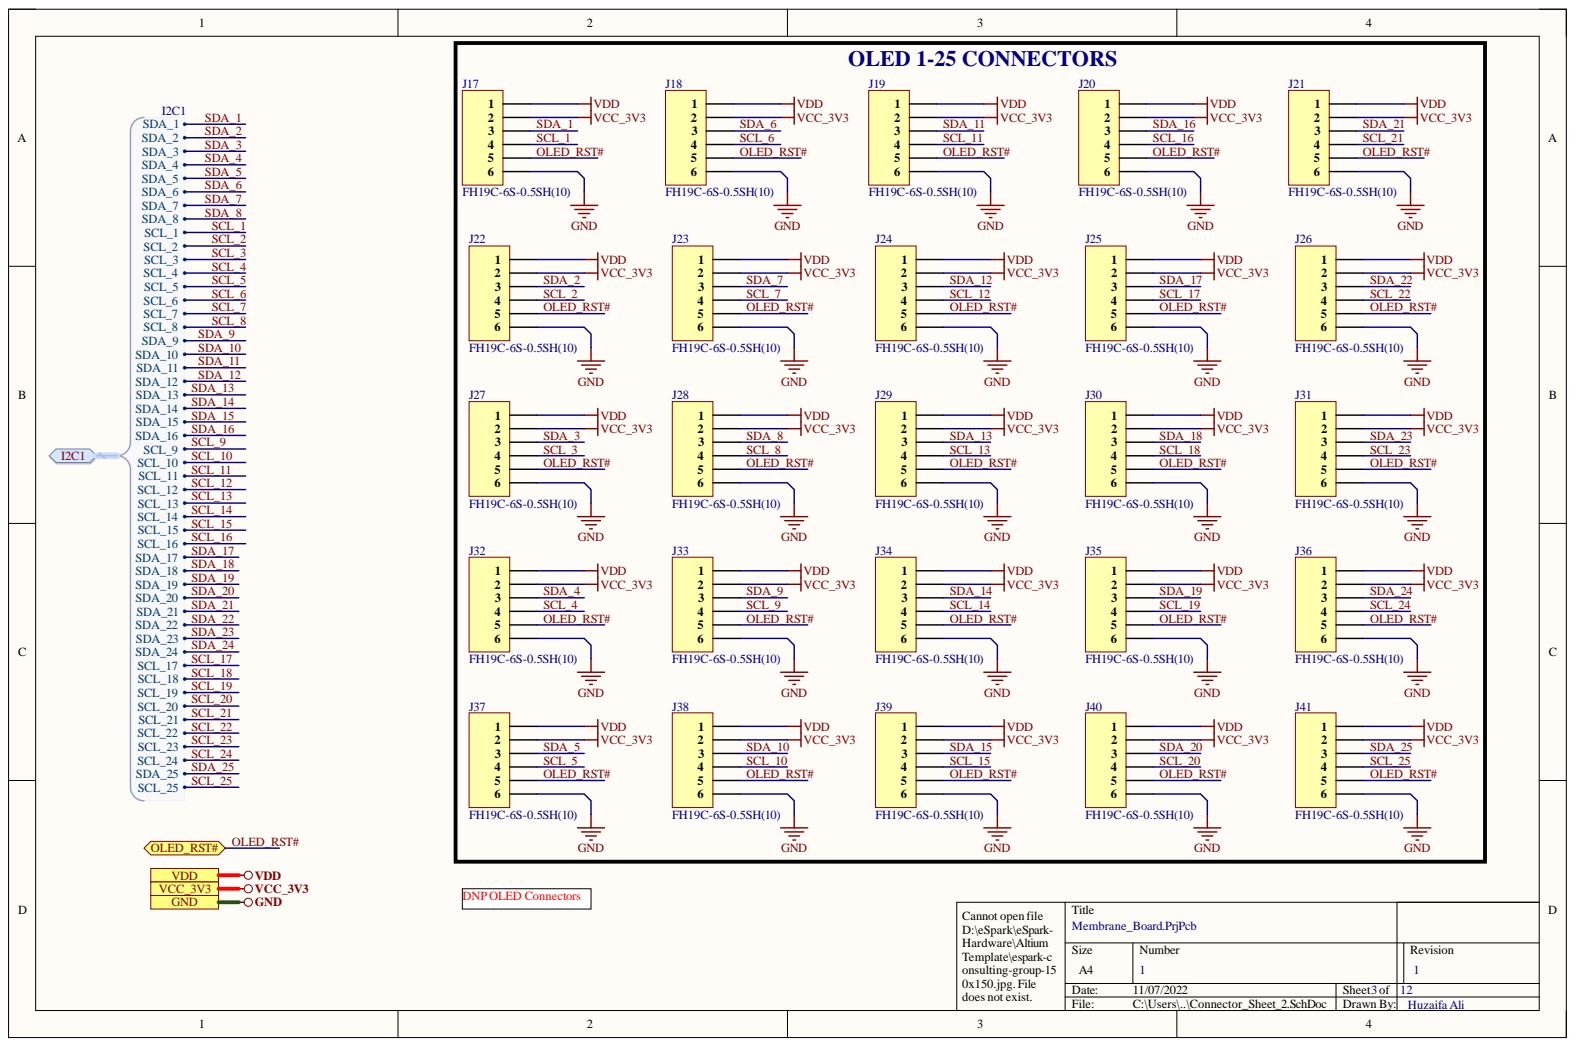
[picture p32: page 3]

C annot open file D:\e Spa rk\e S p ark-Hardware\Altium Template\espark-c onsulting-grou p -1 5 0x150.jpg. Fil e does not exist. | Titl e Membr ane_Board . P rj P c b

Siz e A4 | Numb e r 1 | R evisio n 1

Da te : 11/07/20 2 2 | She et of 3 | 12
File : C:\Use rs\. .\Conne ctor_She e t_2 . S c hD o c | Dr awn B y | : Huz aifa A li

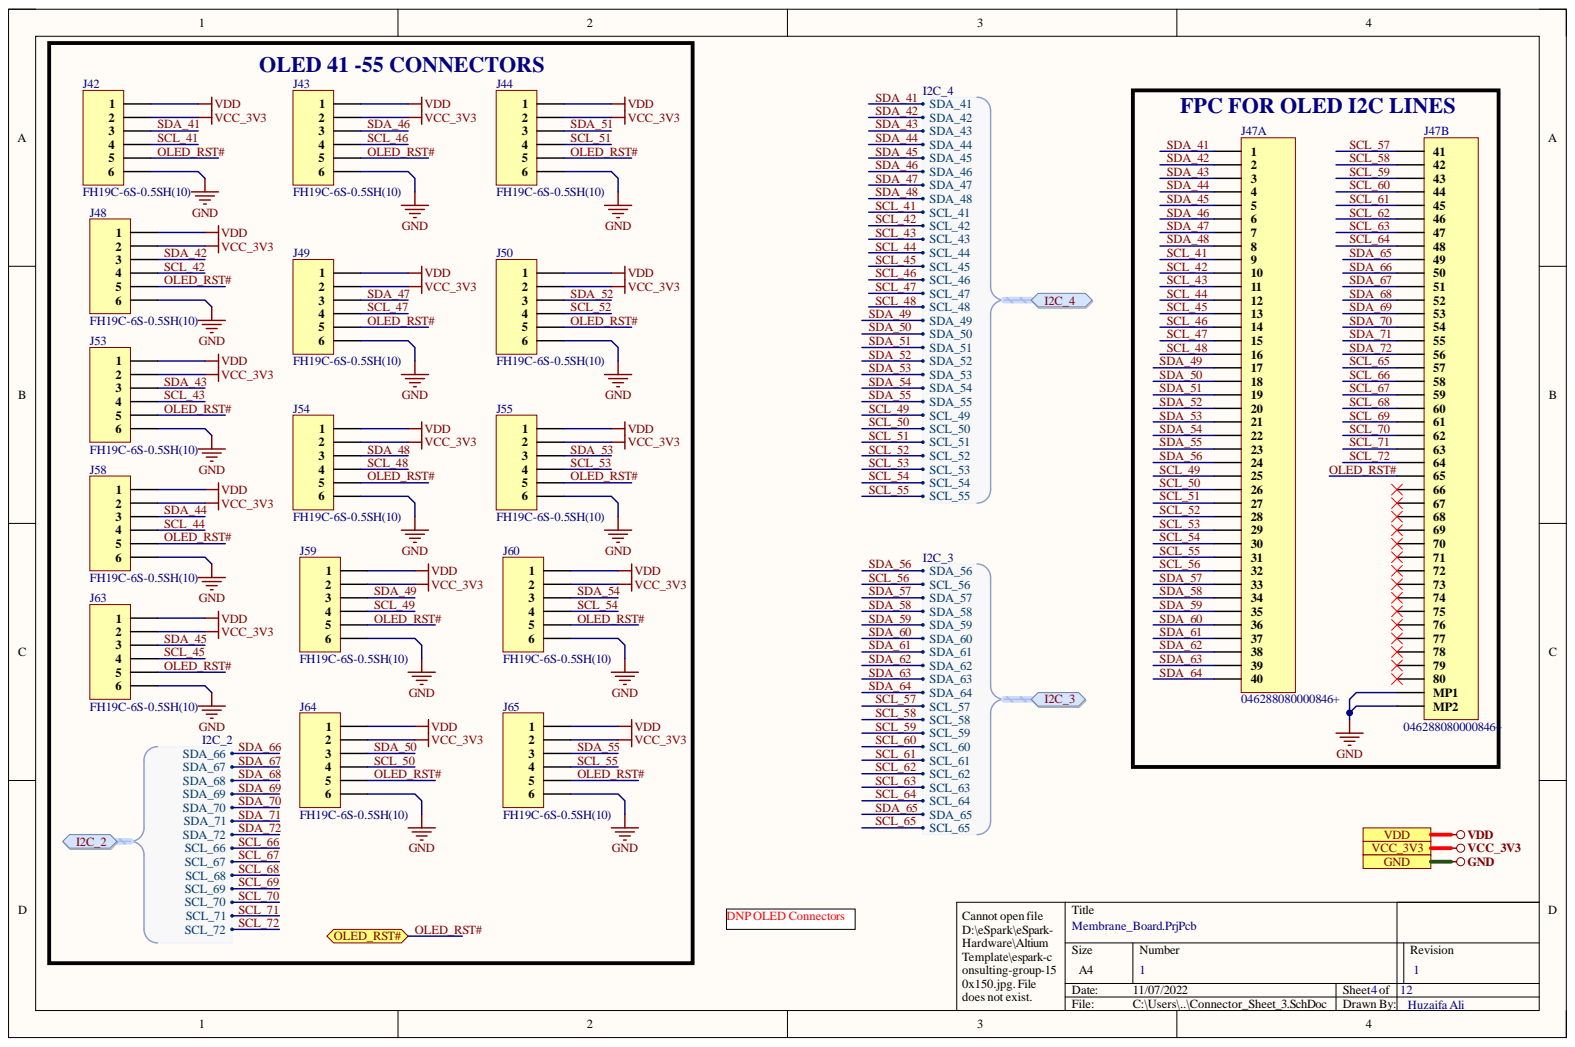
[picture p33: page 4]

FPC FOR OLED I2C LINES 123456789

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

Siz e A4 | Numb e r 1 | R evisio n 1

Da te : 11/07/20 2 2 | She et of 4 | 12
File : C:\Use rs\. .\Conne ctor_She e t_ 3 . S c hD o c | Dr awn B y | : Huz aifa A li

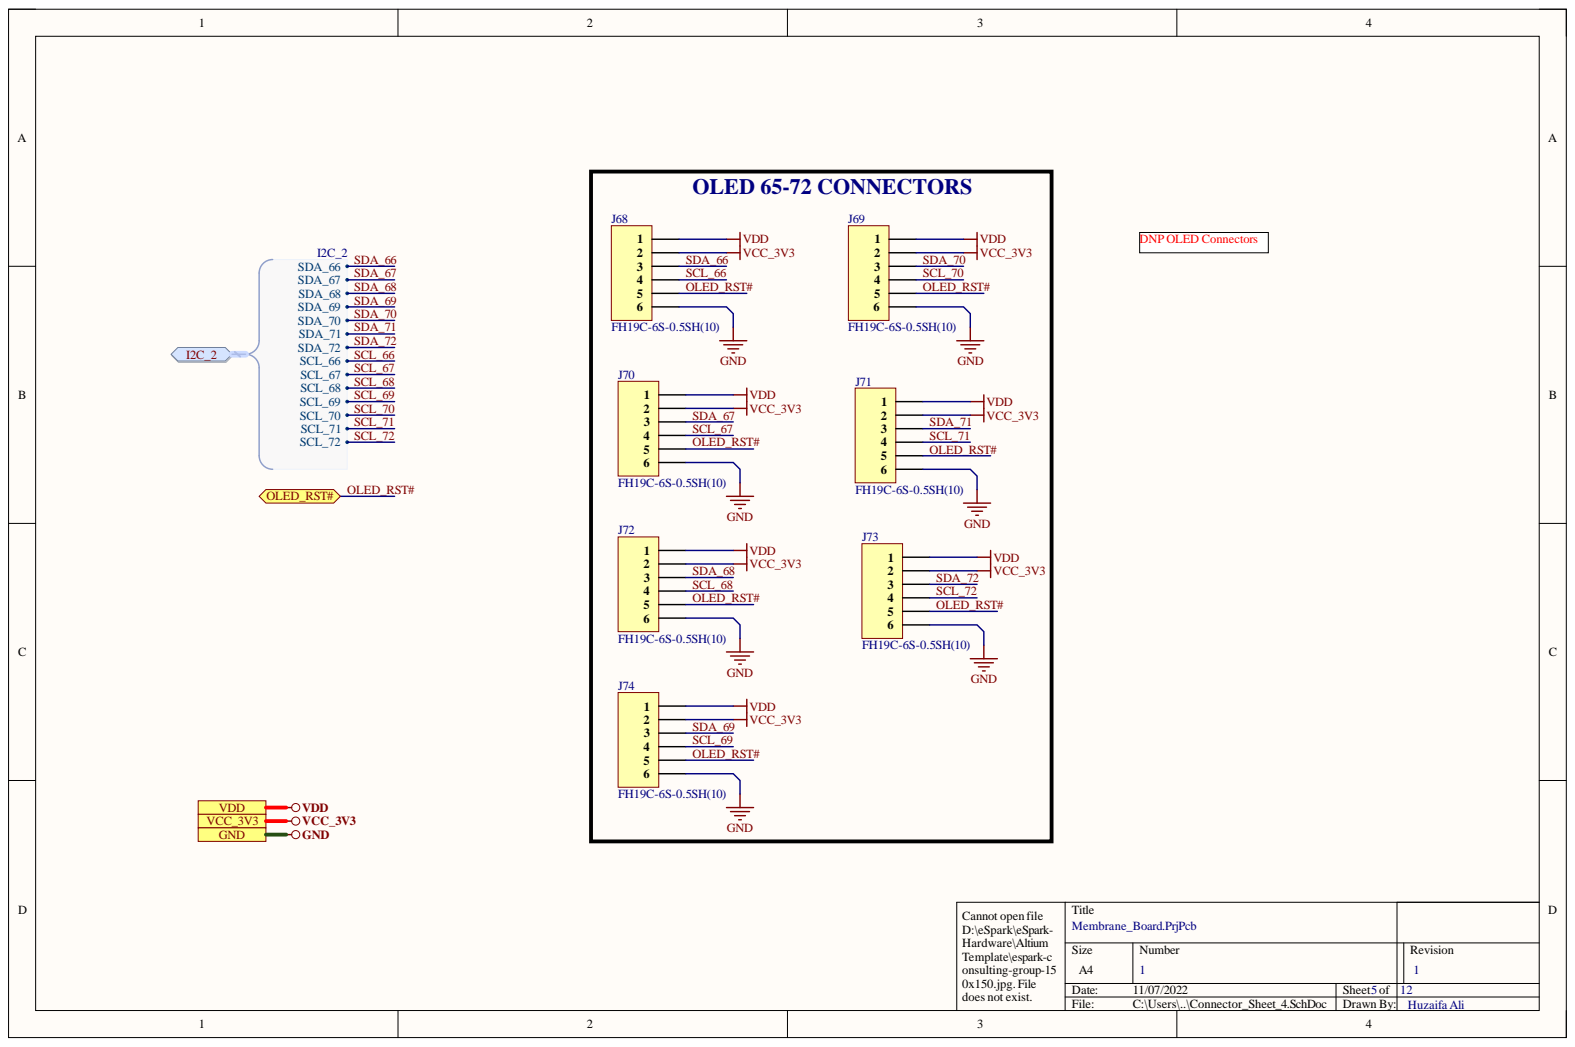
[picture p34: page 5]
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

Siz e A4 | Numb e r 1 | R evisio n 1

Da te : 11/07/20 2 2 | She et of 5 | 12
File : C:\Use rs\. .\Conne ctor_She e t_4 . S c hD o c | Dr awn B y | : Huz aifa A li

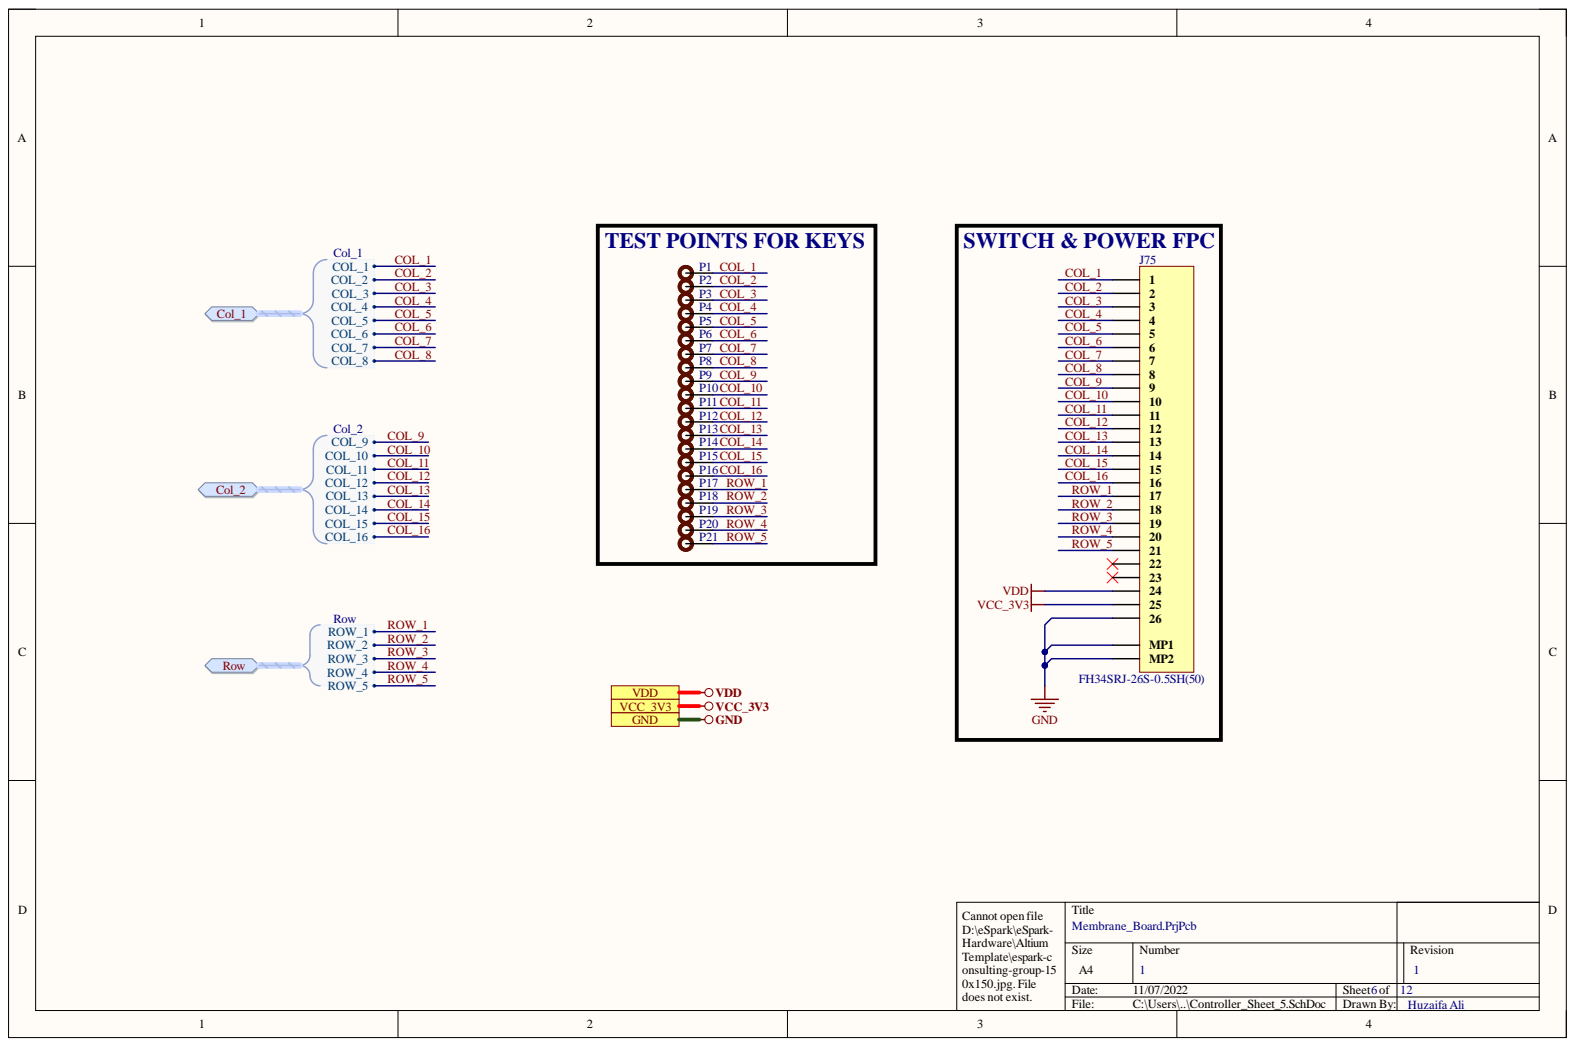
[picture p35: page 6]

TEST POINTS FOR KEYS

SWITCH & POWER FPC GND VDD

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

Siz e A4 | Numb e r 1 | R evisio n 1

Da te : 11/07/20 2 2 | She et of 6 | 12
File : C:\Use rs\. .\Controlle r_She e t_5 . S c hD o c | Dr awn B y | : Huz aifa A li

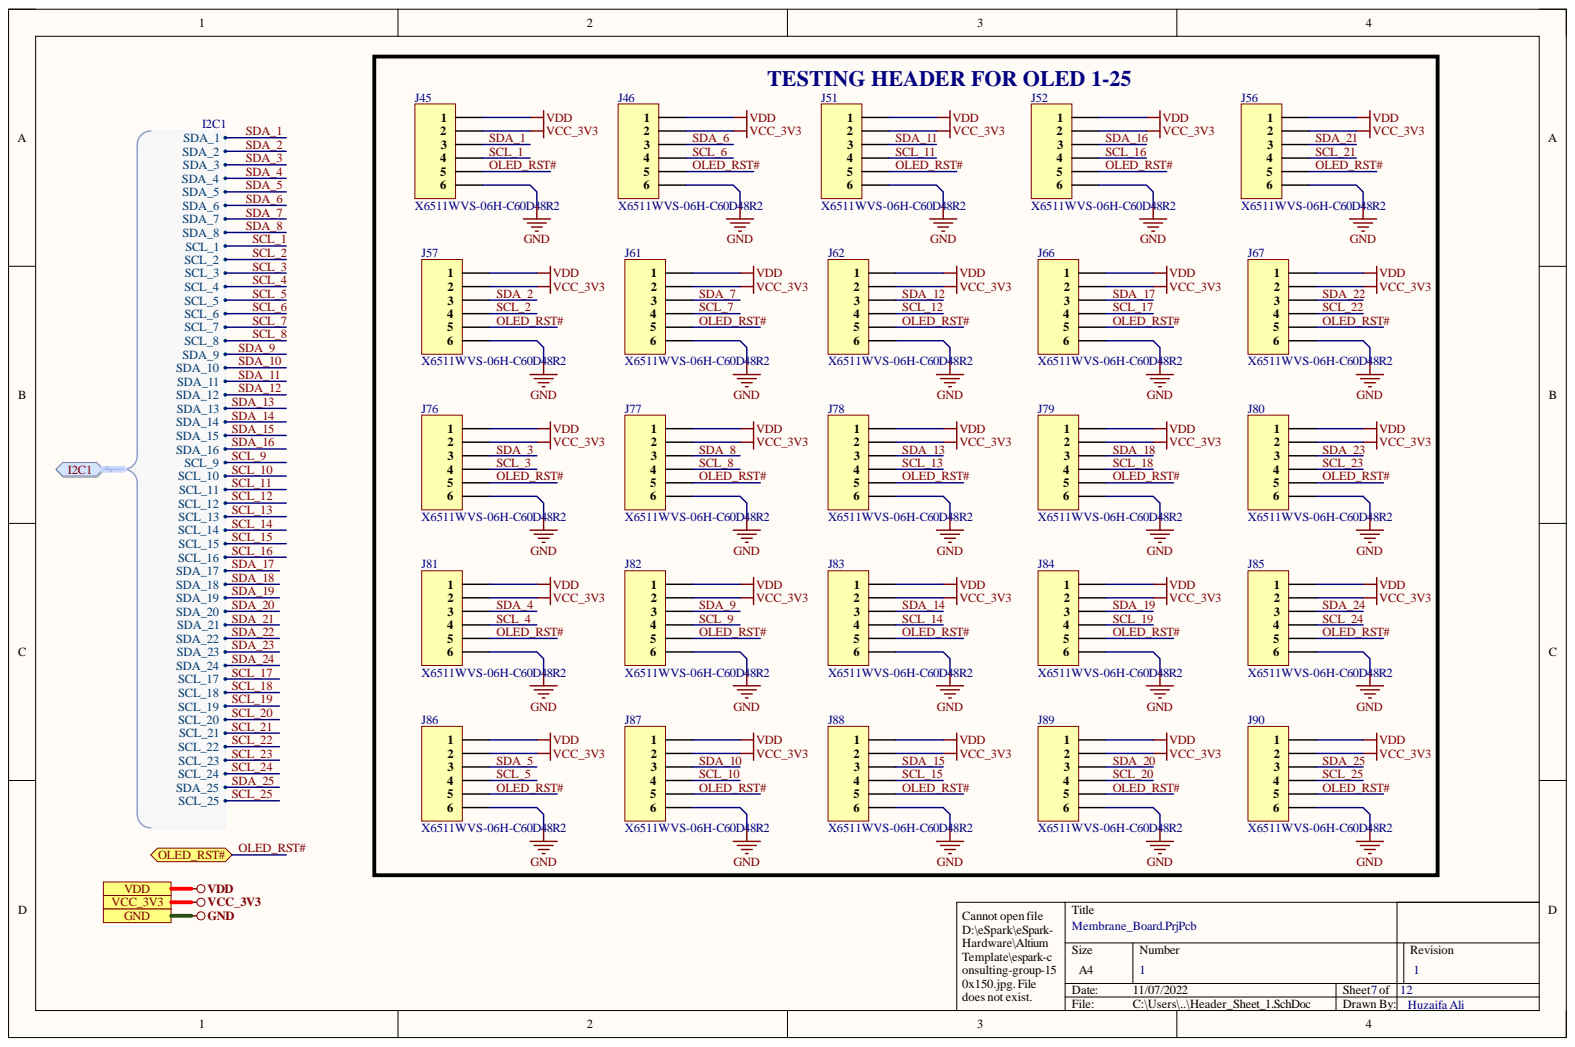
[picture p36: page 7]

TESTING HEADER FOR OLED 1-25

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

Siz e A4 | Numb e r 1 | R evisio n 1

Da te : 11/07/20 2 2 | She et of 7 | 12
File : C:\Use rs\. .\He ade r_She e t_ 1 . S c hD o c | Dr awn B y | : Huz aifa A li

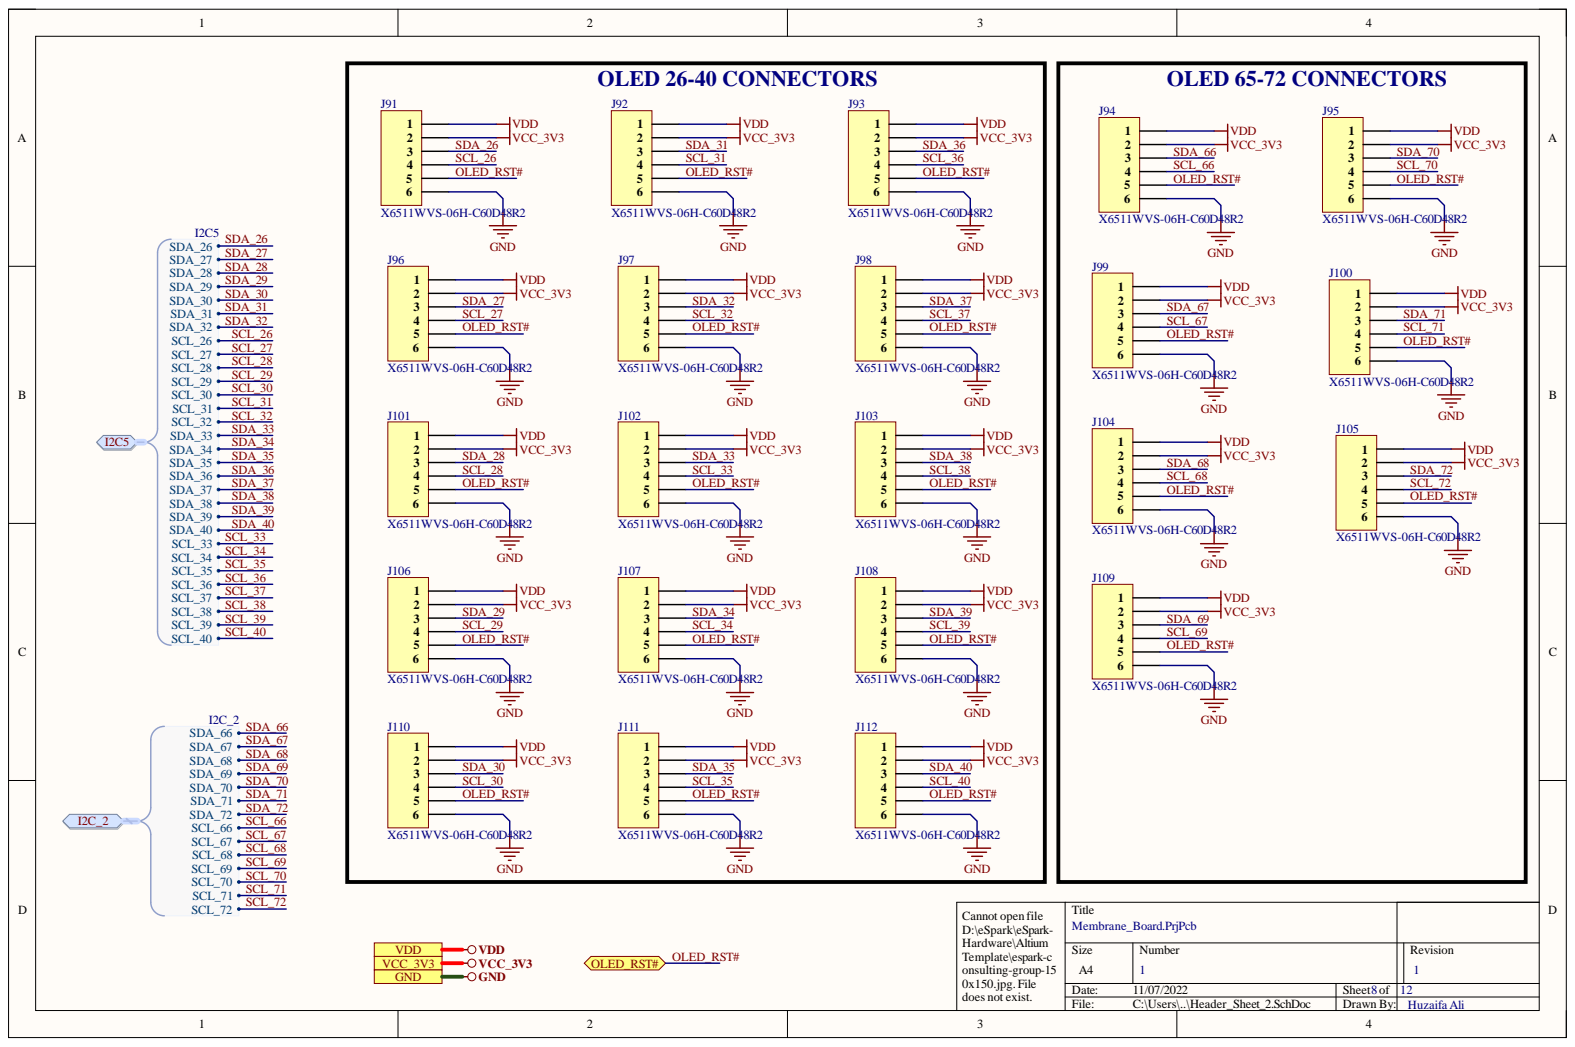
[picture p37: page 8]

Da te : 11/07/20 2 2 | She et of 8 | 12
File : C:\Use rs\. .\He ade r_She e t_2 . S c hD o c | Dr awn B y | : Huz aifa A li

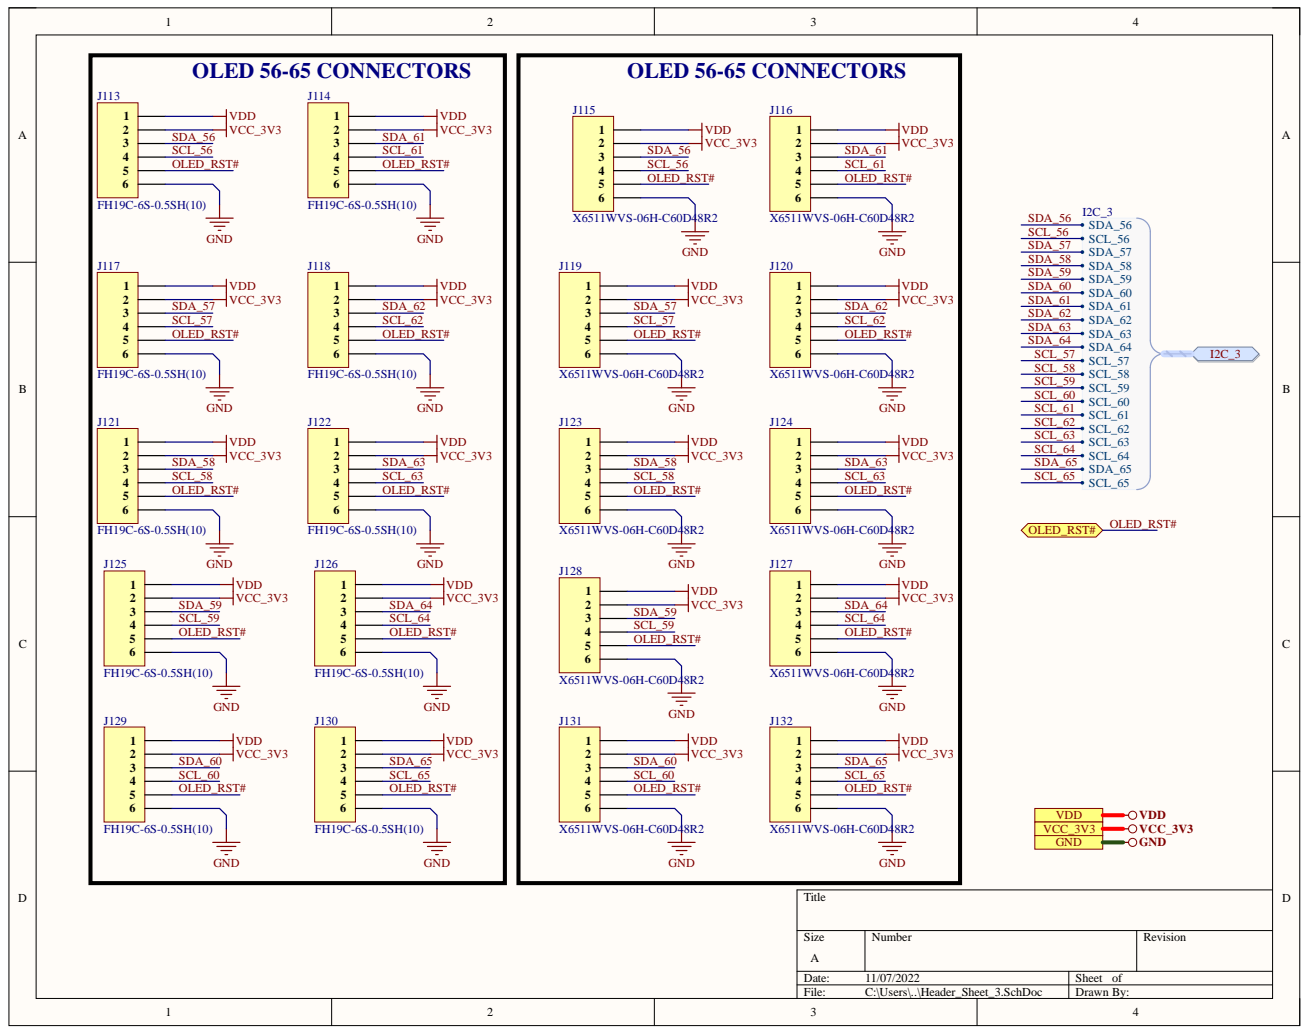
[picture p38: page 9]

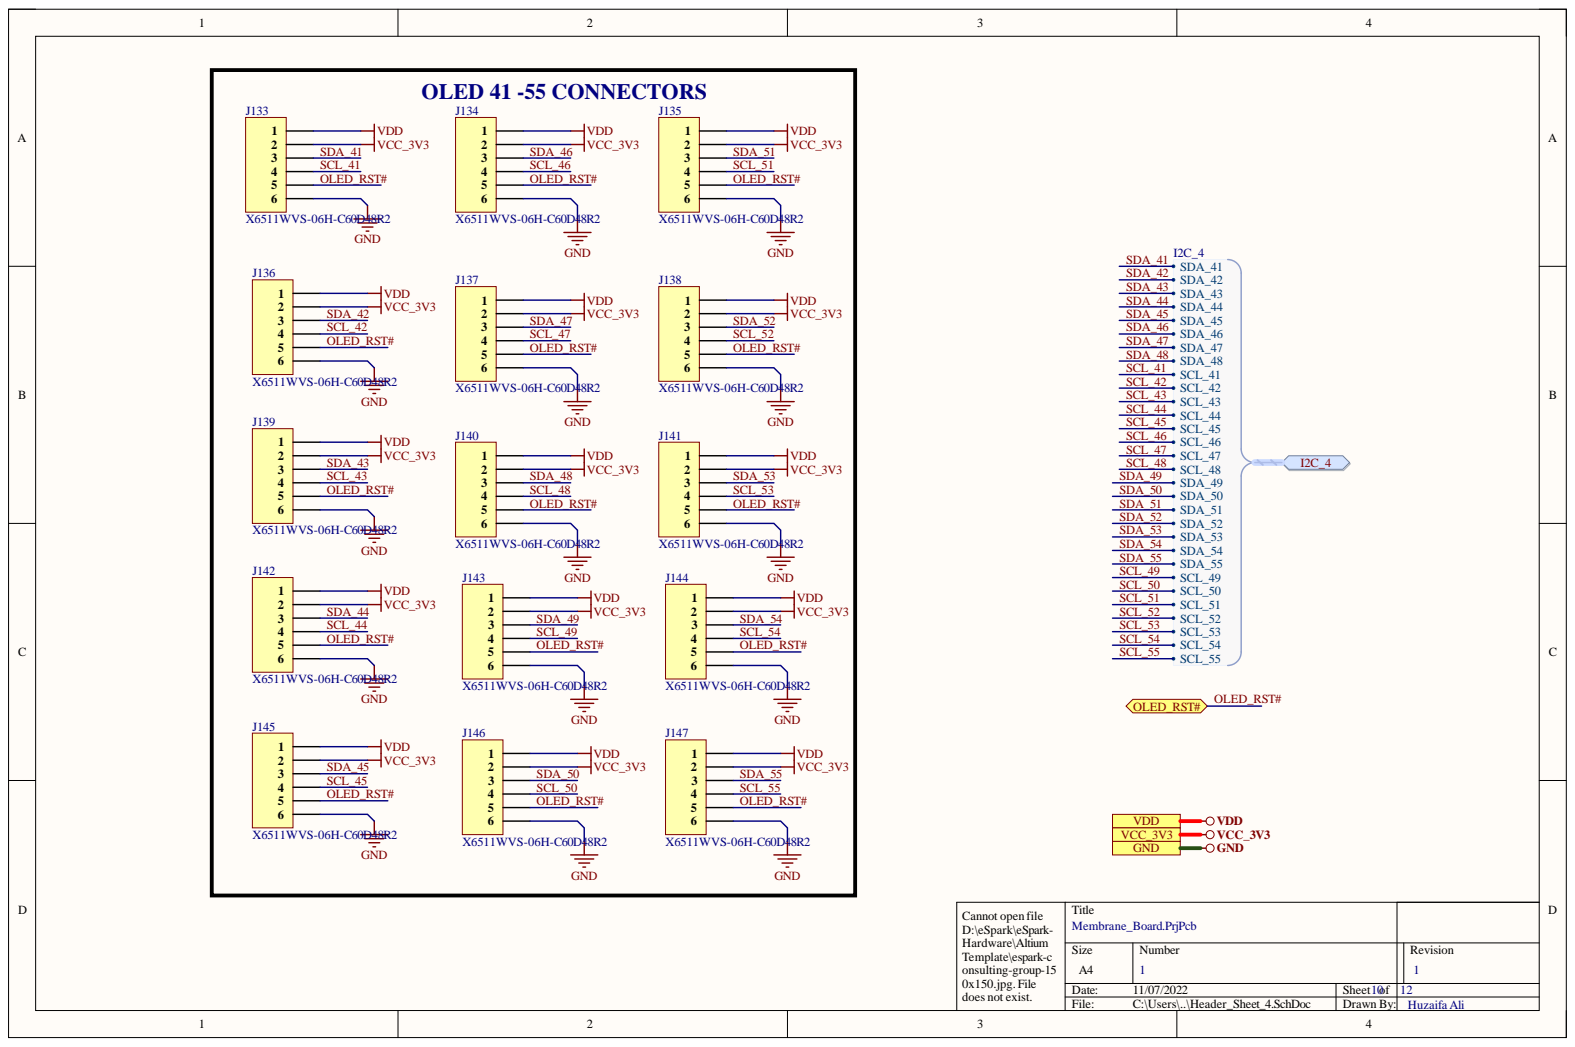
[picture p39: page 10]
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

Siz e A4 | Numb e r 1 | R evisio n 1

Da te : 11/07/20 2 2 | She et of 10 | 12
File : C:\Use rs\. .\He ade r_She e t_4 . S c hD o c | Dr awn B y | : Huz aifa A li

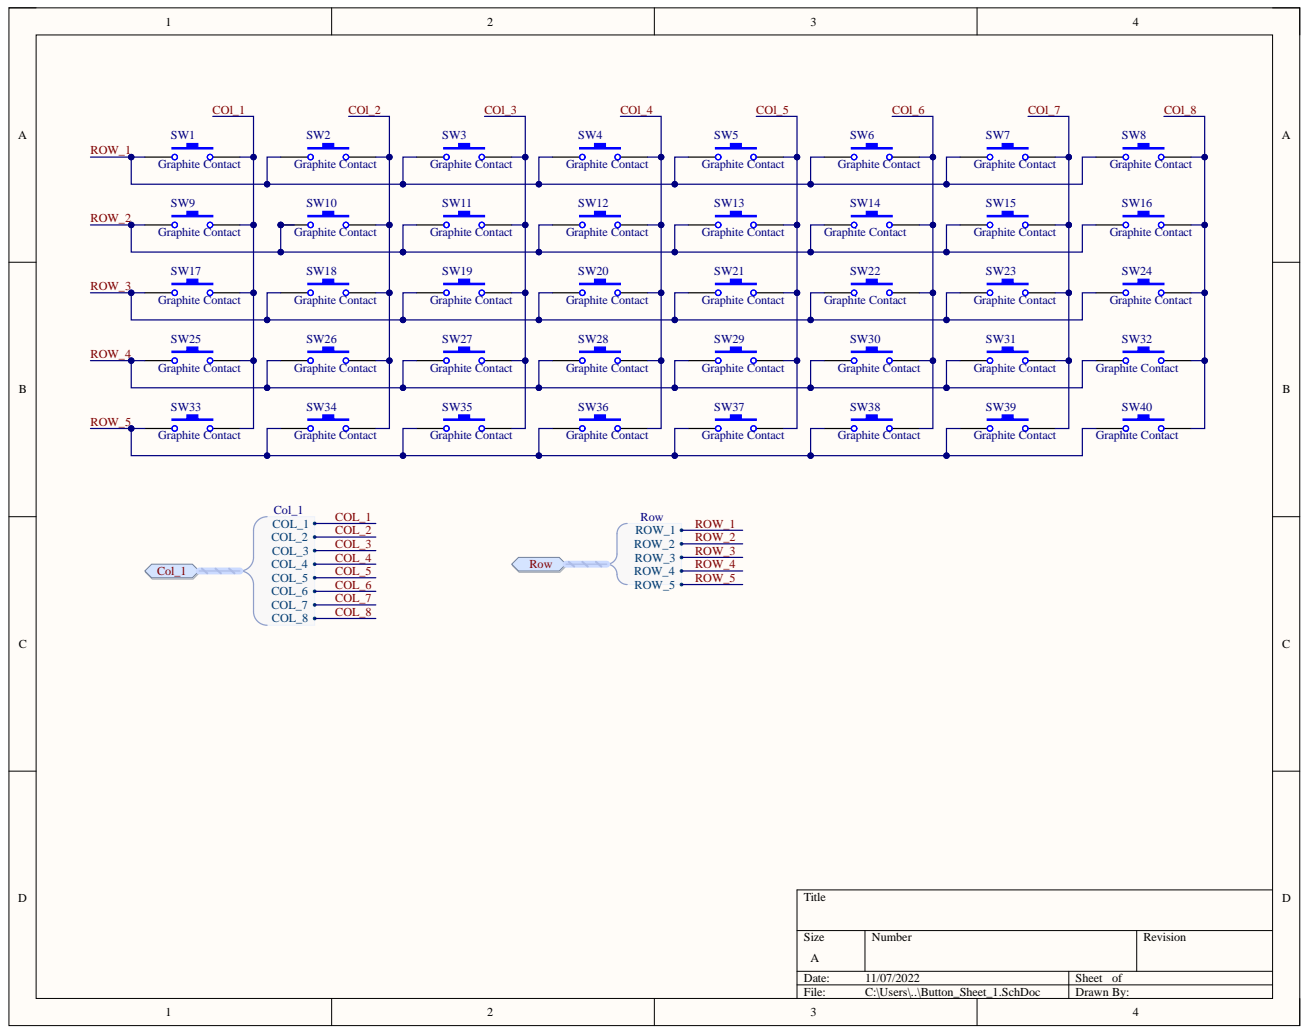
[picture p40: page 11]

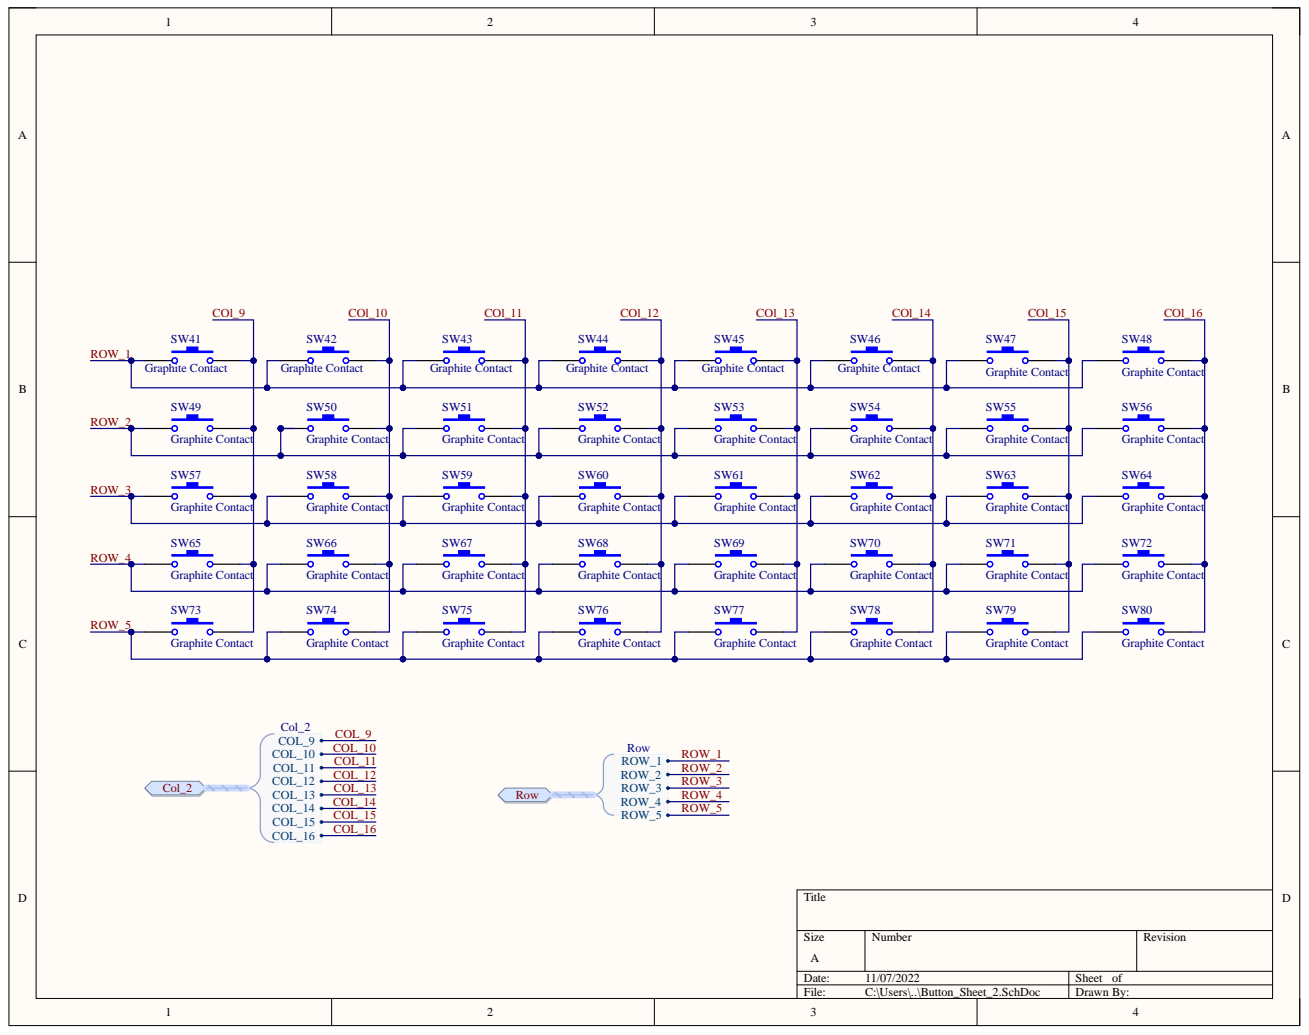
[picture p41: page 12]
