eSpark-Backup/yazid-boud-khlouf-oled-keyboard/Deliverables/Schematics/Assembly_Drawing.pdf

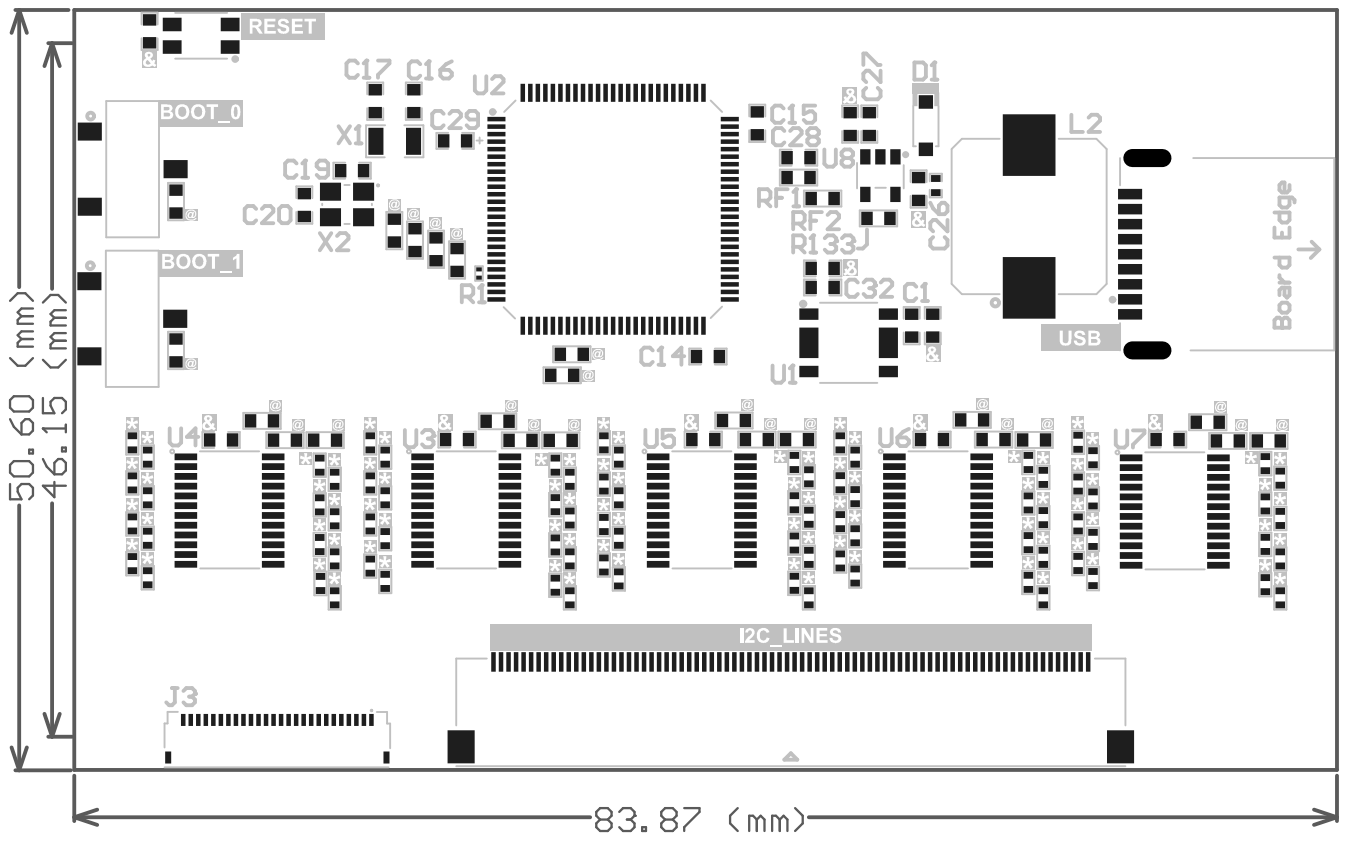
[picture p42: page 1]

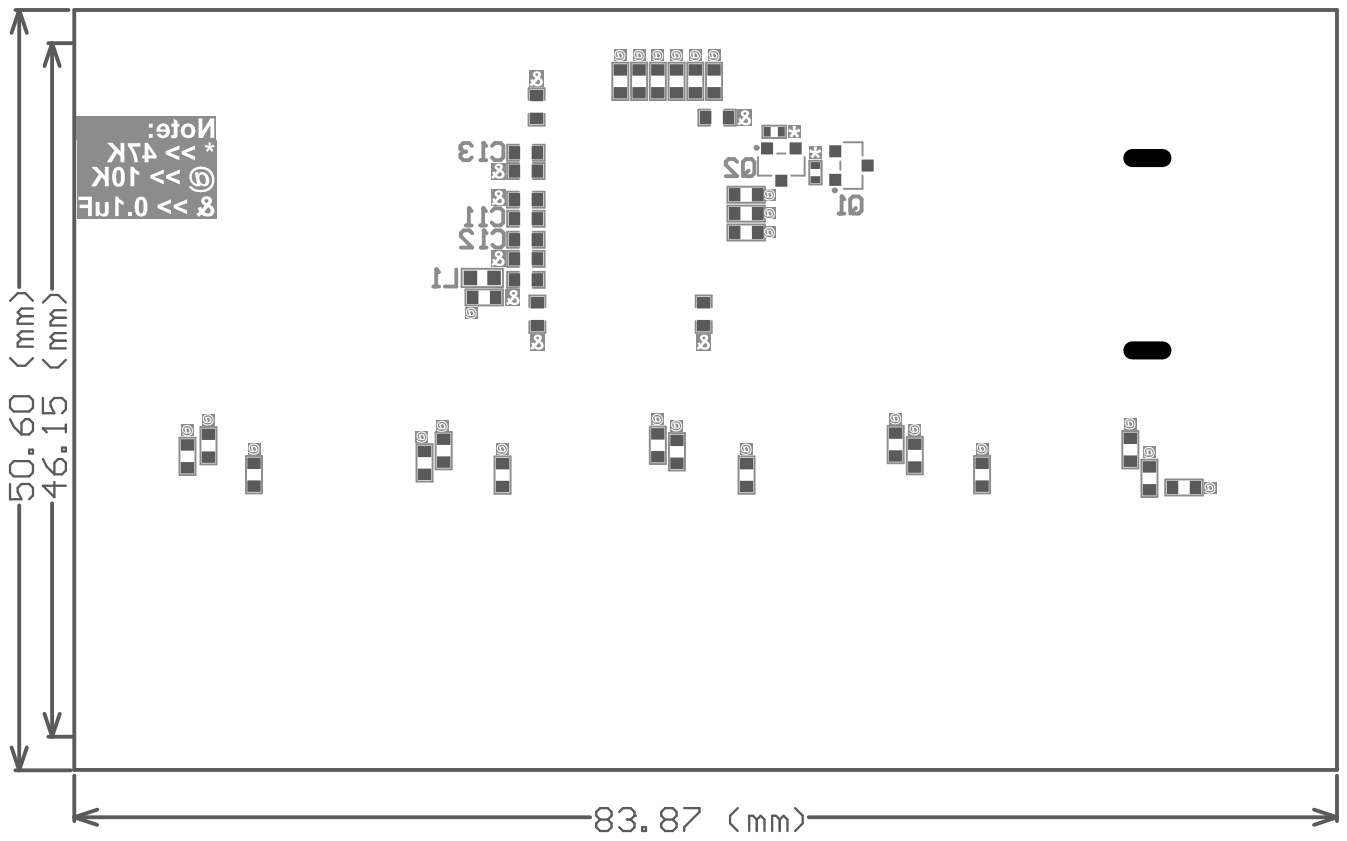
[picture p43: page 2]
