eSpark-Backup/yazid-boud-khlouf-oled-keyboard/Documents/Client-Files/Keyboard matrix.pdf

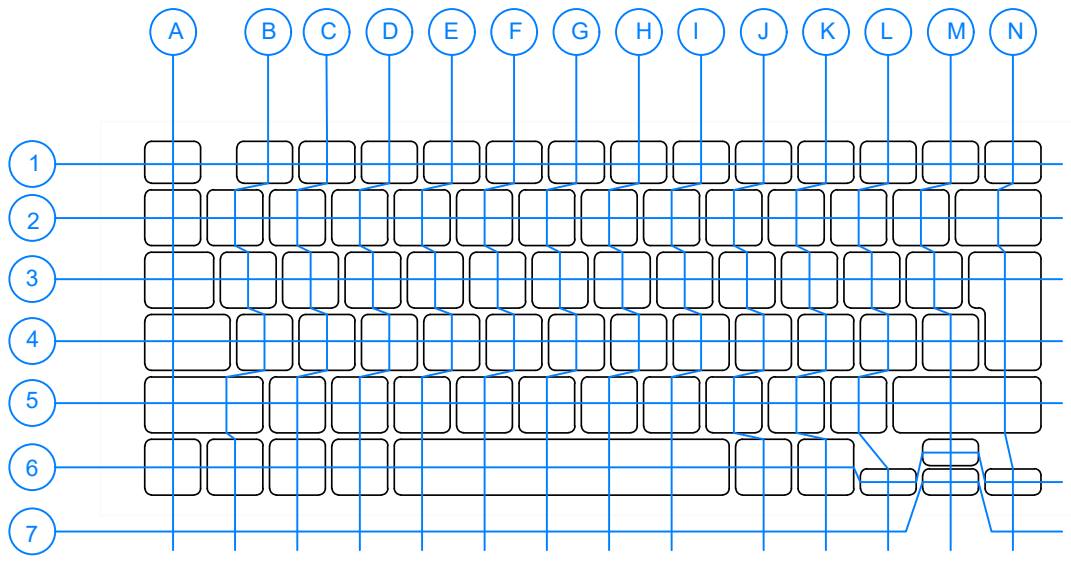
[picture p44: page 1]
Type :

Conception of a custom keyboard EURL ELIOT
Yazid Boukhlouf

Matrix of the keyboard
