eSpark-Backup/yazid-boud-khlouf-oled-keyboard/Documents/Client-Files/Keyboard_dimension.pdf

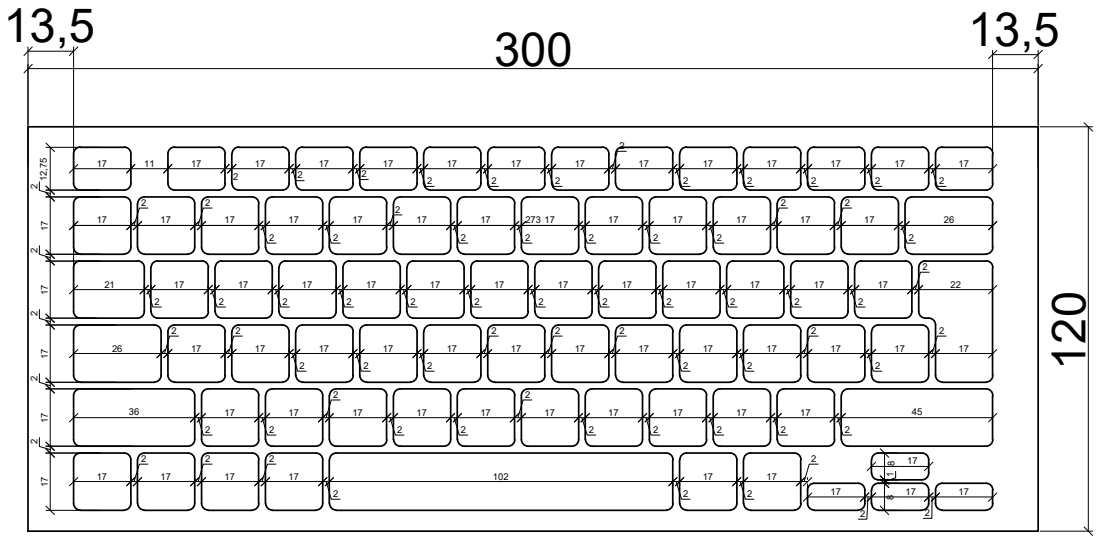
[picture p45: page 1]
Type :

Conception of a custom keyboard EURL ELIOT
Yazid Boukhlouf

Shape and dimension of the keyboard
PLN
