eSpark-Backup/yazid-boud-khlouf-oled-keyboard/(list of files, drawings)

Other design files:
Design-Files/Connector_Sheet.SchDoc
Design-Files/Control Board/BufferIC_Section.SchDoc
Design-Files/Control Board/Connector_Section.SchDoc
Design-Files/Control Board/Connector_Sheet.SchDoc
Design-Files/Control Board/Connector_Sheet_2.SchDoc
Design-Files/Control Board/Controller_Section.SchDoc
Design-Files/Control Board/Controller_Section_1.SchDoc
Design-Files/Control Board/Controller_Section_2.SchDoc
Design-Files/Control Board/Custom_Keyboard.PcbDoc
Design-Files/Control Board/Custom_Keyboard.PrjPcb
Design-Files/Control Board/I2C_Mux_Section.SchDoc
Design-Files/Control Board/Mux_Sheet _3.SchDoc
Design-Files/Control Board/Mux_Sheet_1.SchDoc
Design-Files/Control Board/Mux_Sheet_2.SchDoc
Design-Files/Control Board/Power_Section.SchDoc
Design-Files/Control Board/Rpull_Section2.SchDoc
Design-Files/Control Board/RPull_Section.SchDoc
Design-Files/Control Board/Top_Sheet.SchDoc
Design-Files/Controller_Section.SchDoc
Design-Files/Controller_Section_1.SchDoc
Design-Files/Controller_Section_2.SchDoc
Design-Files/Custom_Keyboard.PcbDoc
Design-Files/Custom_Keyboard.PrjPcb
Design-Files/Flex Cables/Control_Flex_Cable (26-Pin)/Control_Flex_Cable (26-Pin).PrjPcb
Design-Files/Flex Cables/Control_Flex_Cable (26-Pin)/PCB1.PcbDoc
Design-Files/Flex Cables/Control_Flex_Cable (26-Pin)/PCB_Flex_26.PcbDoc
Design-Files/Flex Cables/Control_Flex_Cable (26-Pin)/Sheet1.SchDoc
Design-Files/Flex Cables/Membrane_Flex_Cable (80-Pin)/Membrane_Flex_Cable (80-Pin).PrjPcb
Design-Files/Flex Cables/Membrane_Flex_Cable (80-Pin)/PCB1.PcbDoc
Design-Files/Flex Cables/Membrane_Flex_Cable (80-Pin)/PCB_Flex_80.PcbDoc
Design-Files/Flex Cables/Membrane_Flex_Cable (80-Pin)/Sheet1.SchDoc
Design-Files/Flex Cables/OLED_Flex_Cable (6-Pin)/OLED_Flex_Cable (6-Pin).PrjPcb
Design-Files/Flex Cables/OLED_Flex_Cable (6-Pin)/PCB1.PcbDoc
Design-Files/Flex Cables/OLED_Flex_Cable (6-Pin)/PCB2.PcbDoc
Design-Files/Flex Cables/OLED_Flex_Cable (6-Pin)/PCB_Flex_6.PcbDoc
Design-Files/Flex Cables/OLED_Flex_Cable (6-Pin)/Sheet1.SchDoc
Design-Files/I2C_Mux_Section.SchDoc
Design-Files/Membrane_Board/Button_Sheet.SchDoc
Design-Files/Membrane_Board/Button_Sheet_1.SchDoc
Design-Files/Membrane_Board/Button_Sheet_2.SchDoc
Design-Files/Membrane_Board/Connector_Sheet_1.SchDoc
Design-Files/Membrane_Board/Connector_Sheet_2.SchDoc
Design-Files/Membrane_Board/Connector_Sheet_3.SchDoc
Design-Files/Membrane_Board/Connector_Sheet_4.SchDoc
Design-Files/Membrane_Board/Controller_Sheet_5.SchDoc
Design-Files/Membrane_Board/Header_Sheet_1.SchDoc
Design-Files/Membrane_Board/Header_Sheet_2.SchDoc
Design-Files/Membrane_Board/Header_Sheet_3.SchDoc
Design-Files/Membrane_Board/Header_Sheet_4.SchDoc
Design-Files/Membrane_Board/Membrane_Board.PcbDoc
Design-Files/Membrane_Board/Membrane_Board.PrjPcb
Design-Files/Membrane_Board/Membrane_Board_Latest.PcbDoc
Design-Files/Membrane_Board/Top_Sheet.SchDoc
Design-Files/Mux_Sheet_1.SchDoc
Design-Files/Mux_Sheet_2.SchDoc
Design-Files/OLED_PCB/OLED_PCB.PcbDoc
Design-Files/OLED_PCB/OLED_PCB.PrjPcb
Design-Files/OLED_PCB/OLED_Section.SchDoc
Design-Files/Power_Section.SchDoc
Design-Files/RPull_Section.SchDoc
Design-Files/Top_Sheet.SchDoc
Design-Files/USB Extension Board/Connector_Section.SchDoc
Design-Files/USB Extension Board/USB_Extension.PcbDoc
Design-Files/USB Extension Board/USB_Extension.PrjPcb
Library-Files/CKey_Pcb.PcbLib
Library-Files/CKey_Sch.SchLib
