eSpark-Backup/yazid-boud-khlouf-oled-keyboard/Firmware-developement/Test codes/Arduino IDE/STM32F407/keypad_test/keypad_test.ino

#define INPUT1 PD9
#define INPUT2 PD10
#define INPUT3 PD11
#define INPUT4 PD12

#define OUTPUT1 PA0
#define OUTPUT2 PA1
#define OUTPUT3 PA2
#define OUTPUT4 PA3

uint32_t output_pins[] = {OUTPUT1, OUTPUT2, OUTPUT3, OUTPUT4};
int buttons[] = {1, 2, 3, 4, 5, 6, 7, 8, 9, 10, 11, 12, 13, 14, 15, 16};

void setup() {
  // put your setup code here, to run once:
  pinMode(INPUT1, INPUT_PULLDOWN);
  pinMode(INPUT2, INPUT_PULLDOWN);
  pinMode(INPUT3, INPUT_PULLDOWN);
  pinMode(INPUT4, INPUT_PULLDOWN);

  pinMode(OUTPUT1, OUTPUT);
  pinMode(OUTPUT2, OUTPUT);
  pinMode(OUTPUT3, OUTPUT);
  pinMode(OUTPUT4, OUTPUT);

  Serial.begin(115200);
}

void loop() {
  // put your main code here, to run repeatedly:

  for (int output = 0; output < 4; output++)
  {
    digitalWrite(output_pins[0], output == 0);
    digitalWrite(output_pins[1], output == 1);
    digitalWrite(output_pins[2], output == 2);
    digitalWrite(output_pins[3], output == 3);

    if (output == 0)
    {
      if (digitalRead(INPUT1) == 1)
      {
        Serial.print("Button pressed: ");
        Serial.println(1 + (output * 4));
      }

      if (digitalRead(INPUT2) == 1)
      {
        Serial.print("Button pressed: ");
        Serial.println(2 + (output * 4));
      }

      if (digitalRead(INPUT3) == 1)
      {
        Serial.print("Button pressed: ");
        Serial.println(3 + (output * 4));
      }

      if (digitalRead(INPUT4) == 1)
      {
        Serial.print("Button pressed: ");
        Serial.println(4 + (output * 4));
      }
    }

    if (output == 1)
    {
      if (digitalRead(INPUT1) == 1)
      {
        Serial.print("Button pressed: ");
        Serial.println(1 + (output * 4));
      }

      if (digitalRead(INPUT2) == 1)
      {
        Serial.print("Button pressed: ");
        Serial.println(2 + (output * 4));
      }

      if (digitalRead(INPUT3) == 1)
      {
        Serial.print("Button pressed: ");
        Serial.println(3 + (output * 4));
      }

      if (digitalRead(INPUT4) == 1)
      {
        Serial.print("Button pressed: ");
        Serial.println(4 + (output * 4));
      }
    }

    if (output == 2)
    {
      if (digitalRead(INPUT1) == 1)
      {
        Serial.print("Button pressed: ");
        Serial.println(1 + (output * 4));
      }

      if (digitalRead(INPUT2) == 1)
      {
        Serial.print("Button pressed: ");
        Serial.println(2 + (output * 4));
      }

      if (digitalRead(INPUT3) == 1)
      {
        Serial.print("Button pressed: ");
        Serial.println(3 + (output * 4));
      }

      if (digitalRead(INPUT4) == 1)
      {
        Serial.print("Button pressed: ");
        Serial.println(4 + (output * 4));
      }
    }

    if (output == 3)
    {
      if (digitalRead(INPUT1) == 1)
      {
        Serial.print("Button pressed: ");
        Serial.println(1 + (output * 4));
      }

      if (digitalRead(INPUT2) == 1)
      {
        Serial.print("Button pressed: ");
        Serial.println(2 + (output * 4));
      }

      if (digitalRead(INPUT3) == 1)
      {
        Serial.print("Button pressed: ");
        Serial.println(3 + (output * 4));
      }

      if (digitalRead(INPUT4) == 1)
      {
        Serial.print("Button pressed: ");
        Serial.println(4 + (output * 4));
      }

    }

    delay(50);

  }

}
