eSpark-Backup/yazid-boud-khlouf-oled-keyboard/(commit log)

2022-01-07 3.3V regulator, USB type A 3.0, switches, crystals & other supporting components added.
2022-01-08 Power section, MCU section and Mux added. issue #6
2022-01-12 Schematic Design completed a/c to issue #6
2022-03-09 Switches and OLED circuitry added #17
2022-03-10 implemented keypad button detection code remaining testing
2022-03-25 #38 completed. PCB updated.
2022-03-29 #41 (Net GND remaining)
2022-03-31 Digikey BOM completed. #44
2022-05-06 #55 completed. parts imported to PCB.
2022-05-12 #58 (U231-091N-4BLRA00-S-1) Footprint and 3d Model updated
2022-05-13 PCB updated acc to #60
2022-05-13 Fresh Deliverables generated after Updating PCB #60
2022-07-14 USB connector replaced #71
2022-07-15 USB Extension Schematic Complete #76
2022-07-15 board shape defined; test pad hole and pad size increased #78
2022-07-15 USB connector replaced with Pads #79
2022-07-28 Routing of Main Board in progress #84
2022-08-12 Part Placement of OLED Board #93 completed and some routing remaining
2022-08-15 routing of oled board completed #94 and Placement of Membrane board in progress #96
2022-08-16 PCB parts Placement #96 in progress
2022-08-18 Oled PCB updated acc to #92 control board remaining
2022-08-18 PCB updated acc to #98 and parts Placement done #96
2022-08-22 Incomplete routing of membrane board #99
2022-08-30 Routing of membrane board in progress #99
2022-08-31 PCB routing in progress #99
2022-09-05 Routing of membrane PCB in progress #99
2022-10-06 Minor changes in Custom Keyboard and Membrane PCB #99 .
2022-10-11 Step files of Keyboard, OLED, Control Board and Membrane PCB added in their Design Files Folders.
2022-10-12 Changes in Alignment hole done #99 .
2022-10-17 Mounting holes deleted. #100
2022-10-24 Mounting Holes added #82
2022-10-26 #101 Graphite Button Added.
2022-11-07 Minor Changes in Routing of Control PCB.
